Tai-Min/KV260-Human-Detector/hardware/hardware.runs/hardware_proc_sys_reset_1_0_synth_1/.vivado.begin.rst

<?xml version="1.0"?>
<ProcessHandle Version="1" Minor="0">
    <Process Command="vivado" Owner="mateusz" Host="PC" Pid="10663" HostCore="12" HostMemory="16323700">
    </Process>
</ProcessHandle>
