Tai-Min/KV260-Human-Detector/hardware/hardware.runs/impl_1/.init_design.begin.rst

<?xml version="1.0"?>
<ProcessHandle Version="1" Minor="0">
    <Process Command=".planAhead." Owner="mateusz" Host="" Pid="2269716">
    </Process>
</ProcessHandle>
