Tai-Min/KV260-Human-Detector/hardware/hardware.runs/hardware_temp2pwm_0_0_synth_1/.vivado.begin.rst

<?xml version="1.0"?>
<ProcessHandle Version="1" Minor="0">
    <Process Command="vivado" Owner="mateusz" Host="PC" Pid="37465" HostCore="12" HostMemory="16323700">
    </Process>
</ProcessHandle>
