Tai-Min/KV260-Human-Detector/linux/hardware/xilinx-k26-starterkit-2021.1/xilinx-k26-starterkit-2021.1.runs/impl_1/.vivado.begin.rst

<?xml version="1.0"?>
<ProcessHandle Version="1" Minor="0">
    <Process Command="vivado" Owner="xbrbbot" Host="xcosswbld06" Pid="35040" HostCore="56" HostMemory="528287204">
    </Process>
</ProcessHandle>
