Tai-Min/KV260-Human-Detector/stl/bottom_panel_stopper.stl

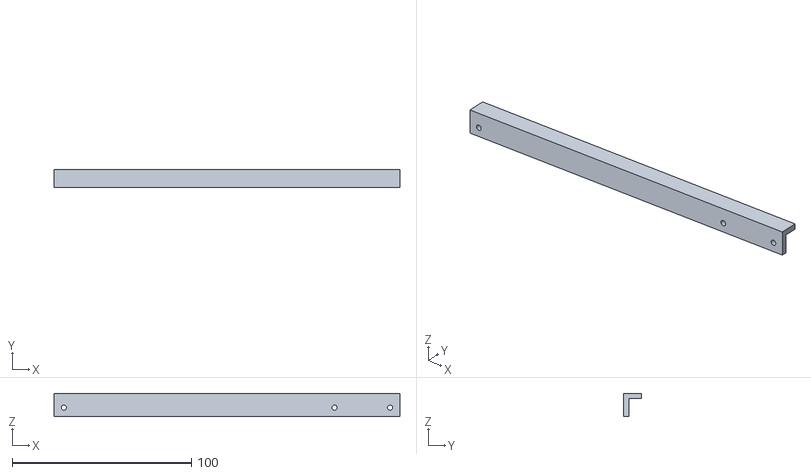
[picture p3: CAD file, 2022-03-03]
stl/bottom_panel_stopper.stl
193.0 x 10.0 x 13.0
