Tai-Min/KV260-Human-Detector/stl/top_panel.stl

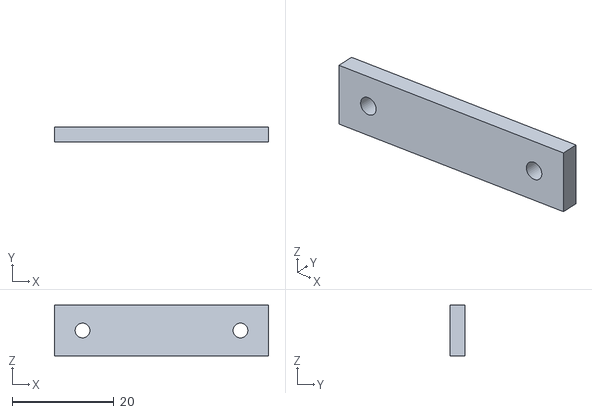
[picture p4: CAD file, 2022-03-03]
stl/top_panel.stl
42.0 x 3.00 x 10.0
