Tai-Min/KV260-Human-Detector/stl/motor_frame.stl

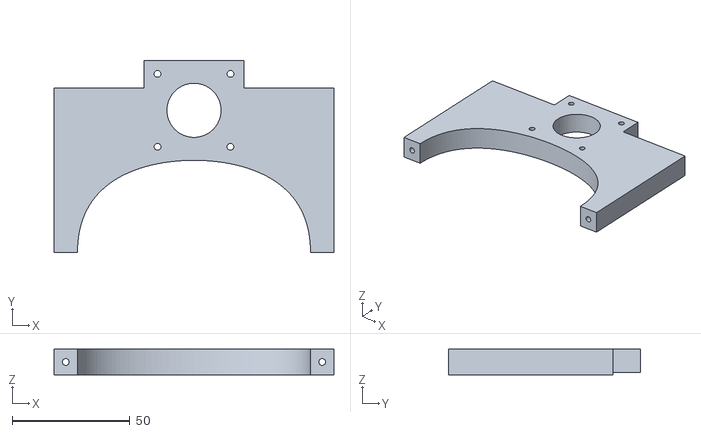
[picture p5: CAD file, 2022-03-03]
stl/motor_frame.stl
119.0 x 81.8 x 11.0
