Tai-Min/KV260-Human-Detector/stl/lidar_frame.stl

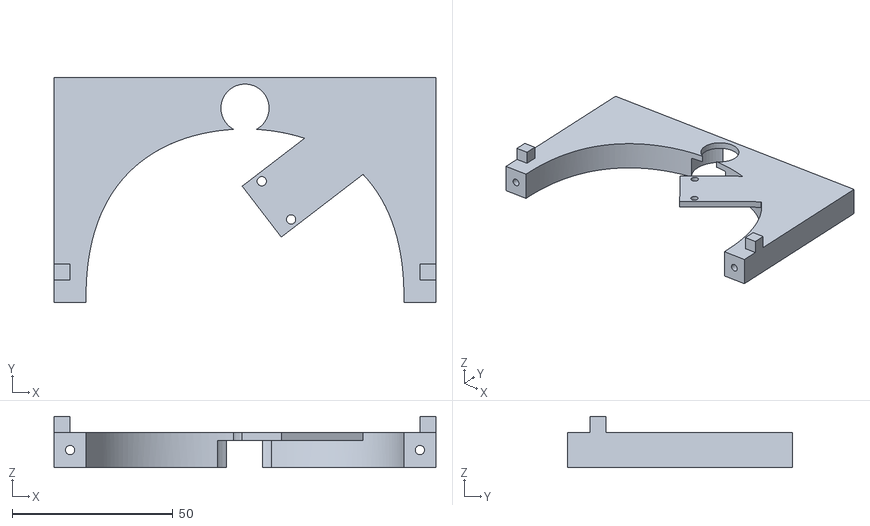
[picture p6: CAD file, 2022-03-03]
stl/lidar_frame.stl
119.0 x 70.0 x 16.0
