Tai-Min/KV260-Human-Detector/stl/bottom_panel.stl

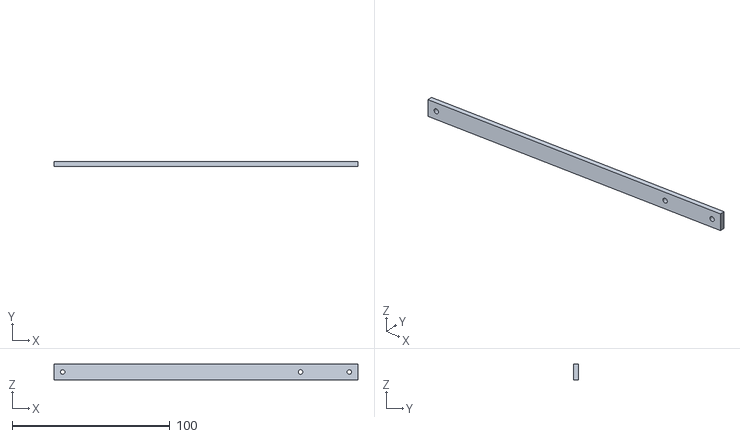
[picture p7: CAD file, 2022-03-03]
stl/bottom_panel.stl
193.0 x 3.00 x 10.0
