Tai-Min/KV260-Human-Detector/stl/bottom_panel_feets.stl

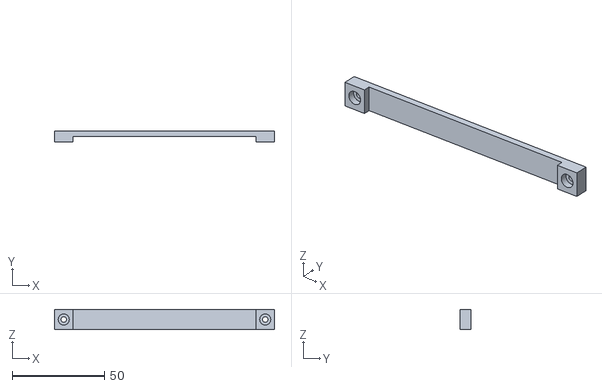
[picture p8: CAD file, 2022-03-03]
stl/bottom_panel_feets.stl
119.0 x 6.00 x 11.0
