Tai-Min/KV260-Human-Detector/stl/nema_connector.stl

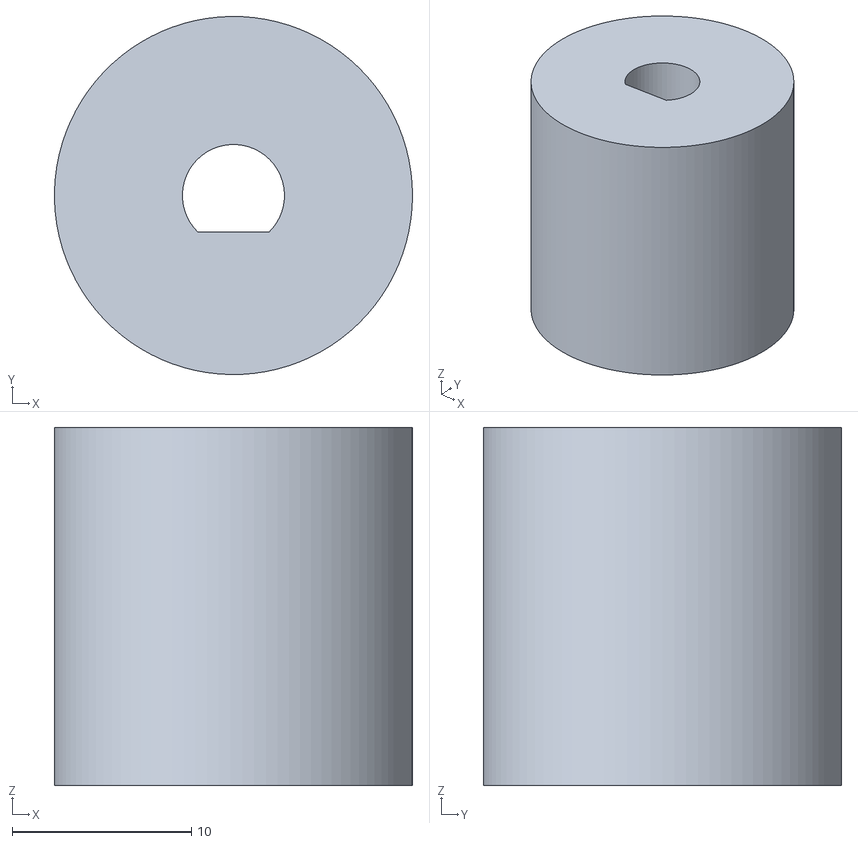
[picture p9: CAD file, 2022-03-03]
stl/nema_connector.stl
20.0 x 20.0 x 20.0
