Tai-Min/KV260-Human-Detector/stl/lidar_board_holder.stl

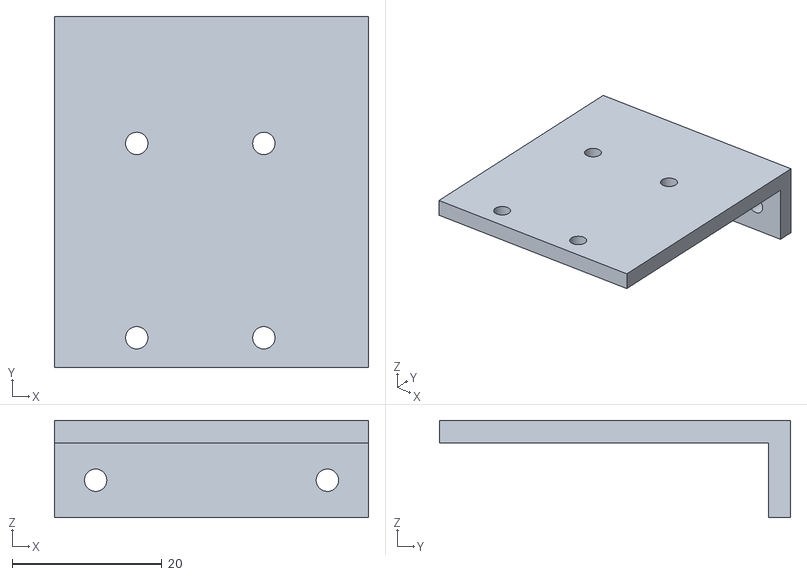
[picture p10: CAD file, 2022-03-03]
stl/lidar_board_holder.stl
42.0 x 47.0 x 13.0
