Tai-Min/KV260-Human-Detector/stl/cradle.stl

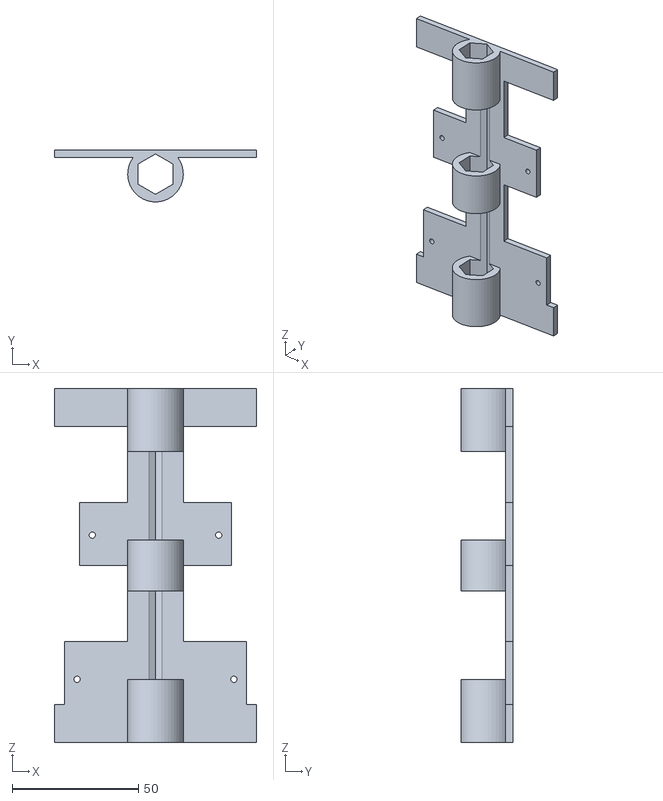
[picture p11: CAD file, 2022-03-03]
stl/cradle.stl
80.0 x 20.5 x 140.0
