Tai-Min/KV260-Human-Detector/linux/hardware/xilinx-k26-starterkit-2021.1/xilinx-k26-starterkit-2021.1.runs/impl_1/usage_statistics_webtalk.html

### Device Usage Page (usage_statistics_webtalk.html)

This HTML page displays the device usage statistics that will be sent to Xilinx.
To see the actual file transmitted to Xilinx, please click here.

software_version_and_target_device
beta | FALSE | build_version | 3247384
date_generated | Fri Jun 11 05:08:06 2021 | os_platform | LIN64
product_version | Vivado v2021.1 (64-bit) | project_id | 5b311babb7be460c8d784e81aaf17de7
project_iteration | 1 | random_id | fea0ae4543065926943c36c45e53d794
registration_id | 1_2_4_3 | route_design | TRUE
target_device | xck26 | target_family | zynquplus
target_package | sfvc784 | target_speed | -2LV
tool_flow | Vivado

user_environment
cpu_name | Intel(R) Xeon(R) CPU E5-2690 v4 @ 2.60GHz | cpu_speed | 1197.268 MHz
os_name | Ubuntu | os_release | Ubuntu 18.04.5 LTS
system_ram | 540.000 GB | total_processors | 2

vivado_usage

other_data

batchmode=1

project_data
base_connector_name_1=som240_1_connector | board=Kria KV260 Vision AI Starter Kit | constraintsetcount=1 | core_container=false
currentimplrun=impl_1 | currentsynthesisrun=synth_1 | default_library=xil_defaultlib | designmode=RTL
export_simulation_activehdl=0 | export_simulation_ies=0 | export_simulation_modelsim=0 | export_simulation_questa=0
export_simulation_riviera=0 | export_simulation_vcs=0 | export_simulation_xsim=0 | fmc_board_1=xilinx.com:som240:1.0
fmc_connector_name_1=som240_1_connector | implstrategy=Vivado Implementation Defaults | launch_simulation_activehdl=0 | launch_simulation_ies=0
launch_simulation_modelsim=0 | launch_simulation_questa=0 | launch_simulation_riviera=0 | launch_simulation_vcs=0
launch_simulation_xsim=0 | simulator_language=Mixed | srcsetcount=2 | synthesisstrategy=Vivado Synthesis Defaults
target_language=Verilog | target_simulator=XSim | totalimplruns=2 | totalsynthesisruns=2

unisim_transformation

post_unisim_transformation
bufg_ps=2 | gnd=3 | lut1=264 | ps8=1

vcc=2

pre_unisim_transformation
bufg_ps=2 | gnd=3 | lut1=264 | ps8=1

vcc=2

phys_opt_design_post_place

command_line_options
-aggressive_hold_fix=default::[not_specified] | -bram_register_opt=default::[not_specified] | -clock_opt=default::[not_specified] | -critical_cell_opt=default::[not_specified]
-critical_pin_opt=default::[not_specified] | -directive=default::[not_specified] | -dsp_register_opt=default::[not_specified] | -effort_level=default::[not_specified]
-fanout_opt=default::[not_specified] | -hold_fix=default::[not_specified] | -insert_negative_edge_ffs=default::[not_specified] | -multi_clock_opt=default::[not_specified]
-placement_opt=default::[not_specified] | -restruct_opt=default::[not_specified] | -retime=default::[not_specified] | -rewire=default::[not_specified]
-shift_register_opt=default::[not_specified] | -uram_register_opt=default::[not_specified] | -verbose=default::[not_specified] | -vhfn=default::[not_specified]

ip_statistics

IP_Integrator/1
bdsource=USER | core_container=NA | da_zynq_ultra_ps_e_cnt=1 | iptotal=1
maxhierdepth=0 | numblks=1 | numhdlrefblks=0 | numhierblks=0
numhlsblks=0 | numnonxlnxblks=0 | numpkgbdblks=0 | numreposblks=1
numsysgenblks=0 | synth_mode=OOC_per_IP | x_iplanguage=VERILOG | x_iplibrary=BlockDiagram
x_ipname=project_1 | x_ipvendor=xilinx.com | x_ipversion=1.00.a

zynq_ultra_ps_e_v3_3_5_zynq_ultra_ps_e/1
c_dp_use_audio=0 | c_dp_use_video=0 | c_emio_gpio_width=1 | c_en_emio_trace=0
c_en_fifo_enet0=0 | c_en_fifo_enet1=0 | c_en_fifo_enet2=0 | c_en_fifo_enet3=0
c_maxigp0_data_width=128 | c_maxigp1_data_width=128 | c_maxigp2_data_width=32 | c_num_f2p_0_intr_inputs=1
c_num_f2p_1_intr_inputs=1 | c_num_fabric_resets=1 | c_pl_clk0_buf=TRUE | c_pl_clk1_buf=TRUE
c_pl_clk2_buf=FALSE | c_pl_clk3_buf=FALSE | c_saxigp0_data_width=128 | c_saxigp1_data_width=128
c_saxigp2_data_width=128 | c_saxigp3_data_width=128 | c_saxigp4_data_width=128 | c_saxigp5_data_width=128
c_saxigp6_data_width=128 | c_sd0_internal_bus_width=8 | c_sd1_internal_bus_width=8 | c_trace_data_width=32
c_trace_pipeline_width=8 | c_use_debug_test=0 | c_use_diff_rw_clk_gp0=0 | c_use_diff_rw_clk_gp1=0
c_use_diff_rw_clk_gp2=0 | c_use_diff_rw_clk_gp3=0 | c_use_diff_rw_clk_gp4=0 | c_use_diff_rw_clk_gp5=0
c_use_diff_rw_clk_gp6=0 | core_container=NA | iptotal=1 | x_ipcorerevision=5
x_iplanguage=VERILOG | x_iplibrary=ip | x_ipname=zynq_ultra_ps_e | x_ipproduct=Vivado 2021.1
x_ipsimlanguage=MIXED | x_ipvendor=xilinx.com | x_ipversion=3.3

zynq_ultra_ps_e_v3_3_user_configuration/1
x_ipversion=3.3 | core_container=NA | iptotal=1 | psu__acpu0__power__on=1
psu__acpu1__power__on=1 | psu__acpu2__power__on=1 | psu__acpu3__power__on=1 | psu__actual__ip=1
psu__can0__grp_clk__enable=0 | psu__can0__peripheral__enable=0 | psu__can0_loop_can1__enable=0 | psu__can1__grp_clk__enable=0
psu__can1__peripheral__enable=0 | psu__crf_apb__acpu_ctrl__act_freqmhz=1333.333008 | psu__crf_apb__acpu_ctrl__divisor0=1 | psu__crf_apb__acpu_ctrl__freqmhz=1333.333
psu__crf_apb__acpu_ctrl__srcsel=APLL | psu__crf_apb__afi0_ref__enable=0 | psu__crf_apb__afi0_ref_ctrl__act_freqmhz=667 | psu__crf_apb__afi0_ref_ctrl__divisor0=2
psu__crf_apb__afi0_ref_ctrl__freqmhz=667 | psu__crf_apb__afi0_ref_ctrl__srcsel=DPLL | psu__crf_apb__afi1_ref__enable=0 | psu__crf_apb__afi1_ref_ctrl__act_freqmhz=667
psu__crf_apb__afi1_ref_ctrl__divisor0=2 | psu__crf_apb__afi1_ref_ctrl__freqmhz=667 | psu__crf_apb__afi1_ref_ctrl__srcsel=DPLL | psu__crf_apb__afi2_ref__enable=0
psu__crf_apb__afi2_ref_ctrl__act_freqmhz=667 | psu__crf_apb__afi2_ref_ctrl__divisor0=2 | psu__crf_apb__afi2_ref_ctrl__freqmhz=667 | psu__crf_apb__afi2_ref_ctrl__srcsel=DPLL
psu__crf_apb__afi3_ref__enable=0 | psu__crf_apb__afi3_ref_ctrl__act_freqmhz=667 | psu__crf_apb__afi3_ref_ctrl__divisor0=2 | psu__crf_apb__afi3_ref_ctrl__freqmhz=667
psu__crf_apb__afi3_ref_ctrl__srcsel=DPLL | psu__crf_apb__afi4_ref__enable=0 | psu__crf_apb__afi4_ref_ctrl__act_freqmhz=667 | psu__crf_apb__afi4_ref_ctrl__divisor0=2
psu__crf_apb__afi4_ref_ctrl__freqmhz=667 | psu__crf_apb__afi4_ref_ctrl__srcsel=DPLL | psu__crf_apb__afi5_ref__enable=0 | psu__crf_apb__afi5_ref_ctrl__act_freqmhz=667
psu__crf_apb__afi5_ref_ctrl__divisor0=2 | psu__crf_apb__afi5_ref_ctrl__freqmhz=667 | psu__crf_apb__afi5_ref_ctrl__srcsel=DPLL | psu__crf_apb__apll_ctrl__div2=1
psu__crf_apb__apll_ctrl__fbdiv=80 | psu__crf_apb__apll_ctrl__srcsel=PSS_REF_CLK | psu__crf_apb__apll_frac_cfg__enabled=1 | psu__crf_apb__apll_to_lpd_ctrl__divisor0=3
psu__crf_apb__apm_ctrl__act_freqmhz=1 | psu__crf_apb__apm_ctrl__divisor0=1 | psu__crf_apb__apm_ctrl__freqmhz=1 | psu__crf_apb__dbg_fpd_ctrl__act_freqmhz=249.997498
psu__crf_apb__dbg_fpd_ctrl__divisor0=2 | psu__crf_apb__dbg_fpd_ctrl__freqmhz=250 | psu__crf_apb__dbg_fpd_ctrl__srcsel=IOPLL | psu__crf_apb__dbg_trace_ctrl__act_freqmhz=250
psu__crf_apb__dbg_trace_ctrl__divisor0=5 | psu__crf_apb__dbg_trace_ctrl__freqmhz=250 | psu__crf_apb__dbg_trace_ctrl__srcsel=IOPLL | psu__crf_apb__dbg_tstmp_ctrl__act_freqmhz=249.997498
psu__crf_apb__dbg_tstmp_ctrl__divisor0=2 | psu__crf_apb__dbg_tstmp_ctrl__freqmhz=250 | psu__crf_apb__dbg_tstmp_ctrl__srcsel=IOPLL | psu__crf_apb__ddr_ctrl__act_freqmhz=533.328003
psu__crf_apb__ddr_ctrl__divisor0=2 | psu__crf_apb__ddr_ctrl__freqmhz=1200 | psu__crf_apb__ddr_ctrl__srcsel=DPLL | psu__crf_apb__dp_audio_ref_ctrl__act_freqmhz=24.242182
psu__crf_apb__dp_audio_ref_ctrl__divisor0=22 | psu__crf_apb__dp_audio_ref_ctrl__divisor1=1 | psu__crf_apb__dp_audio_ref_ctrl__freqmhz=25 | psu__crf_apb__dp_audio_ref_ctrl__srcsel=RPLL
psu__crf_apb__dp_stc_ref_ctrl__act_freqmhz=26.666401 | psu__crf_apb__dp_stc_ref_ctrl__divisor0=20 | psu__crf_apb__dp_stc_ref_ctrl__divisor1=1 | psu__crf_apb__dp_stc_ref_ctrl__freqmhz=27
psu__crf_apb__dp_stc_ref_ctrl__srcsel=RPLL | psu__crf_apb__dp_video_ref_ctrl__act_freqmhz=299.997009 | psu__crf_apb__dp_video_ref_ctrl__divisor0=5 | psu__crf_apb__dp_video_ref_ctrl__divisor1=1
psu__crf_apb__dp_video_ref_ctrl__freqmhz=300 | psu__crf_apb__dp_video_ref_ctrl__srcsel=VPLL | psu__crf_apb__dpdma_ref_ctrl__act_freqmhz=444.444336 | psu__crf_apb__dpdma_ref_ctrl__divisor0=3
psu__crf_apb__dpdma_ref_ctrl__freqmhz=600 | psu__crf_apb__dpdma_ref_ctrl__srcsel=APLL | psu__crf_apb__dpll_ctrl__div2=1 | psu__crf_apb__dpll_ctrl__fbdiv=64
psu__crf_apb__dpll_ctrl__srcsel=PSS_REF_CLK | psu__crf_apb__dpll_frac_cfg__enabled=0 | psu__crf_apb__dpll_to_lpd_ctrl__divisor0=2 | psu__crf_apb__gdma_ref_ctrl__act_freqmhz=533.328003
psu__crf_apb__gdma_ref_ctrl__divisor0=2 | psu__crf_apb__gdma_ref_ctrl__freqmhz=600 | psu__crf_apb__gdma_ref_ctrl__srcsel=DPLL | psu__crf_apb__gpu_ref_ctrl__act_freqmhz=499.994995
psu__crf_apb__gpu_ref_ctrl__divisor0=1 | psu__crf_apb__gpu_ref_ctrl__freqmhz=600 | psu__crf_apb__gpu_ref_ctrl__srcsel=IOPLL | psu__crf_apb__pcie_ref_ctrl__act_freqmhz=250
psu__crf_apb__pcie_ref_ctrl__divisor0=6 | psu__crf_apb__pcie_ref_ctrl__freqmhz=250 | psu__crf_apb__pcie_ref_ctrl__srcsel=IOPLL | psu__crf_apb__sata_ref_ctrl__act_freqmhz=250
psu__crf_apb__sata_ref_ctrl__divisor0=5 | psu__crf_apb__sata_ref_ctrl__freqmhz=250 | psu__crf_apb__sata_ref_ctrl__srcsel=IOPLL | psu__crf_apb__topsw_lsbus_ctrl__act_freqmhz=99.999001
psu__crf_apb__topsw_lsbus_ctrl__divisor0=5 | psu__crf_apb__topsw_lsbus_ctrl__freqmhz=100 | psu__crf_apb__topsw_lsbus_ctrl__srcsel=IOPLL | psu__crf_apb__topsw_main_ctrl__act_freqmhz=533.328003
psu__crf_apb__topsw_main_ctrl__divisor0=2 | psu__crf_apb__topsw_main_ctrl__freqmhz=533.33 | psu__crf_apb__topsw_main_ctrl__srcsel=DPLL | psu__crf_apb__vpll_ctrl__div2=1
psu__crf_apb__vpll_ctrl__fbdiv=90 | psu__crf_apb__vpll_ctrl__srcsel=PSS_REF_CLK | psu__crf_apb__vpll_frac_cfg__enabled=0 | psu__crf_apb__vpll_to_lpd_ctrl__divisor0=3
psu__crl_apb__adma_ref_ctrl__act_freqmhz=499.994995 | psu__crl_apb__adma_ref_ctrl__divisor0=3 | psu__crl_apb__adma_ref_ctrl__freqmhz=500 | psu__crl_apb__adma_ref_ctrl__srcsel=IOPLL
psu__crl_apb__afi6__enable=0 | psu__crl_apb__afi6_ref_ctrl__act_freqmhz=500 | psu__crl_apb__afi6_ref_ctrl__divisor0=3 | psu__crl_apb__afi6_ref_ctrl__freqmhz=500
psu__crl_apb__afi6_ref_ctrl__srcsel=IOPLL | psu__crl_apb__ams_ref_ctrl__act_freqmhz=49.999500 | psu__crl_apb__ams_ref_ctrl__divisor0=30 | psu__crl_apb__ams_ref_ctrl__divisor1=1
psu__crl_apb__ams_ref_ctrl__freqmhz=50 | psu__crl_apb__ams_ref_ctrl__srcsel=IOPLL | psu__crl_apb__can0_ref_ctrl__act_freqmhz=100 | psu__crl_apb__can0_ref_ctrl__divisor0=15
psu__crl_apb__can0_ref_ctrl__divisor1=1 | psu__crl_apb__can0_ref_ctrl__freqmhz=100 | psu__crl_apb__can0_ref_ctrl__srcsel=IOPLL | psu__crl_apb__can1_ref_ctrl__act_freqmhz=100
psu__crl_apb__can1_ref_ctrl__divisor0=15 | psu__crl_apb__can1_ref_ctrl__divisor1=1 | psu__crl_apb__can1_ref_ctrl__freqmhz=100 | psu__crl_apb__can1_ref_ctrl__srcsel=IOPLL
psu__crl_apb__cpu_r5_ctrl__act_freqmhz=533.328003 | psu__crl_apb__cpu_r5_ctrl__divisor0=2 | psu__crl_apb__cpu_r5_ctrl__freqmhz=533.333 | psu__crl_apb__cpu_r5_ctrl__srcsel=RPLL
psu__crl_apb__csu_pll_ctrl__act_freqmhz=180 | psu__crl_apb__csu_pll_ctrl__divisor0=3 | psu__crl_apb__csu_pll_ctrl__freqmhz=180 | psu__crl_apb__csu_pll_ctrl__srcsel=SysOsc
psu__crl_apb__dbg_lpd_ctrl__act_freqmhz=249.997498 | psu__crl_apb__dbg_lpd_ctrl__divisor0=6 | psu__crl_apb__dbg_lpd_ctrl__freqmhz=250 | psu__crl_apb__dbg_lpd_ctrl__srcsel=IOPLL
psu__crl_apb__debug_r5_atclk_ctrl__act_freqmhz=1000 | psu__crl_apb__debug_r5_atclk_ctrl__divisor0=6 | psu__crl_apb__debug_r5_atclk_ctrl__freqmhz=1000 | psu__crl_apb__debug_r5_atclk_ctrl__srcsel=RPLL
psu__crl_apb__dll_ref_ctrl__act_freqmhz=1499.984985 | psu__crl_apb__dll_ref_ctrl__freqmhz=1500 | psu__crl_apb__dll_ref_ctrl__srcsel=IOPLL | psu__crl_apb__gem0_ref_ctrl__act_freqmhz=125
psu__crl_apb__gem0_ref_ctrl__divisor0=12 | psu__crl_apb__gem0_ref_ctrl__divisor1=1 | psu__crl_apb__gem0_ref_ctrl__freqmhz=125 | psu__crl_apb__gem0_ref_ctrl__srcsel=IOPLL
psu__crl_apb__gem1_ref_ctrl__act_freqmhz=125 | psu__crl_apb__gem1_ref_ctrl__divisor0=12 | psu__crl_apb__gem1_ref_ctrl__divisor1=1 | psu__crl_apb__gem1_ref_ctrl__freqmhz=125
psu__crl_apb__gem1_ref_ctrl__srcsel=IOPLL | psu__crl_apb__gem2_ref_ctrl__act_freqmhz=125 | psu__crl_apb__gem2_ref_ctrl__divisor0=12 | psu__crl_apb__gem2_ref_ctrl__divisor1=1
psu__crl_apb__gem2_ref_ctrl__freqmhz=125 | psu__crl_apb__gem2_ref_ctrl__srcsel=IOPLL | psu__crl_apb__gem3_ref_ctrl__act_freqmhz=124.998749 | psu__crl_apb__gem3_ref_ctrl__divisor0=12
psu__crl_apb__gem3_ref_ctrl__divisor1=1 | psu__crl_apb__gem3_ref_ctrl__freqmhz=125 | psu__crl_apb__gem3_ref_ctrl__srcsel=IOPLL | psu__crl_apb__gem_tsu_ref_ctrl__act_freqmhz=249.997498
psu__crl_apb__gem_tsu_ref_ctrl__divisor0=6 | psu__crl_apb__gem_tsu_ref_ctrl__divisor1=1 | psu__crl_apb__gem_tsu_ref_ctrl__freqmhz=250 | psu__crl_apb__gem_tsu_ref_ctrl__srcsel=IOPLL
psu__crl_apb__i2c0_ref_ctrl__act_freqmhz=100 | psu__crl_apb__i2c0_ref_ctrl__divisor0=15 | psu__crl_apb__i2c0_ref_ctrl__divisor1=1 | psu__crl_apb__i2c0_ref_ctrl__freqmhz=100
psu__crl_apb__i2c0_ref_ctrl__srcsel=IOPLL | psu__crl_apb__i2c1_ref_ctrl__act_freqmhz=99.999001 | psu__crl_apb__i2c1_ref_ctrl__divisor0=15 | psu__crl_apb__i2c1_ref_ctrl__divisor1=1
psu__crl_apb__i2c1_ref_ctrl__freqmhz=100 | psu__crl_apb__i2c1_ref_ctrl__srcsel=IOPLL | psu__crl_apb__iopll_ctrl__div2=1 | psu__crl_apb__iopll_ctrl__fbdiv=90
psu__crl_apb__iopll_ctrl__srcsel=PSS_REF_CLK | psu__crl_apb__iopll_frac_cfg__enabled=0 | psu__crl_apb__iopll_to_fpd_ctrl__divisor0=3 | psu__crl_apb__iou_switch_ctrl__act_freqmhz=249.997498
psu__crl_apb__iou_switch_ctrl__divisor0=6 | psu__crl_apb__iou_switch_ctrl__freqmhz=250 | psu__crl_apb__iou_switch_ctrl__srcsel=IOPLL | psu__crl_apb__lpd_lsbus_ctrl__act_freqmhz=99.999001
psu__crl_apb__lpd_lsbus_ctrl__divisor0=15 | psu__crl_apb__lpd_lsbus_ctrl__freqmhz=100 | psu__crl_apb__lpd_lsbus_ctrl__srcsel=IOPLL | psu__crl_apb__lpd_switch_ctrl__act_freqmhz=499.994995
psu__crl_apb__lpd_switch_ctrl__divisor0=3 | psu__crl_apb__lpd_switch_ctrl__freqmhz=500 | psu__crl_apb__lpd_switch_ctrl__srcsel=IOPLL | psu__crl_apb__nand_ref_ctrl__act_freqmhz=100
psu__crl_apb__nand_ref_ctrl__divisor0=15 | psu__crl_apb__nand_ref_ctrl__divisor1=1 | psu__crl_apb__nand_ref_ctrl__freqmhz=100 | psu__crl_apb__nand_ref_ctrl__srcsel=IOPLL
psu__crl_apb__ocm_main_ctrl__act_freqmhz=500 | psu__crl_apb__ocm_main_ctrl__divisor0=3 | psu__crl_apb__ocm_main_ctrl__freqmhz=500 | psu__crl_apb__ocm_main_ctrl__srcsel=IOPLL
psu__crl_apb__pcap_ctrl__act_freqmhz=187.498123 | psu__crl_apb__pcap_ctrl__divisor0=8 | psu__crl_apb__pcap_ctrl__freqmhz=200 | psu__crl_apb__pcap_ctrl__srcsel=IOPLL
psu__crl_apb__pl0_ref_ctrl__act_freqmhz=99.999001 | psu__crl_apb__pl0_ref_ctrl__divisor0=15 | psu__crl_apb__pl0_ref_ctrl__divisor1=1 | psu__crl_apb__pl0_ref_ctrl__freqmhz=100
psu__crl_apb__pl0_ref_ctrl__srcsel=IOPLL | psu__crl_apb__pl1_ref_ctrl__act_freqmhz=99.999001 | psu__crl_apb__pl1_ref_ctrl__divisor0=15 | psu__crl_apb__pl1_ref_ctrl__divisor1=1
psu__crl_apb__pl1_ref_ctrl__freqmhz=100 | psu__crl_apb__pl1_ref_ctrl__srcsel=IOPLL | psu__crl_apb__pl2_ref_ctrl__act_freqmhz=100 | psu__crl_apb__pl2_ref_ctrl__divisor0=4
psu__crl_apb__pl2_ref_ctrl__divisor1=1 | psu__crl_apb__pl2_ref_ctrl__freqmhz=100 | psu__crl_apb__pl2_ref_ctrl__srcsel=RPLL | psu__crl_apb__pl3_ref_ctrl__act_freqmhz=100
psu__crl_apb__pl3_ref_ctrl__divisor0=4 | psu__crl_apb__pl3_ref_ctrl__divisor1=1 | psu__crl_apb__pl3_ref_ctrl__freqmhz=100 | psu__crl_apb__pl3_ref_ctrl__srcsel=RPLL
psu__crl_apb__qspi_ref_ctrl__act_freqmhz=124.998749 | psu__crl_apb__qspi_ref_ctrl__divisor0=12 | psu__crl_apb__qspi_ref_ctrl__divisor1=1 | psu__crl_apb__qspi_ref_ctrl__freqmhz=125
psu__crl_apb__qspi_ref_ctrl__srcsel=IOPLL | psu__crl_apb__rpll_ctrl__div2=1 | psu__crl_apb__rpll_ctrl__fbdiv=64 | psu__crl_apb__rpll_ctrl__srcsel=PSS_REF_CLK
psu__crl_apb__rpll_frac_cfg__enabled=0 | psu__crl_apb__rpll_to_fpd_ctrl__divisor0=2 | psu__crl_apb__sdio0_ref_ctrl__act_freqmhz=200 | psu__crl_apb__sdio0_ref_ctrl__divisor0=7
psu__crl_apb__sdio0_ref_ctrl__divisor1=1 | psu__crl_apb__sdio0_ref_ctrl__freqmhz=200 | psu__crl_apb__sdio0_ref_ctrl__srcsel=RPLL | psu__crl_apb__sdio1_ref_ctrl__act_freqmhz=187.498123
psu__crl_apb__sdio1_ref_ctrl__divisor0=8 | psu__crl_apb__sdio1_ref_ctrl__divisor1=1 | psu__crl_apb__sdio1_ref_ctrl__freqmhz=200 | psu__crl_apb__sdio1_ref_ctrl__srcsel=IOPLL
psu__crl_apb__spi0_ref_ctrl__act_freqmhz=214 | psu__crl_apb__spi0_ref_ctrl__divisor0=7 | psu__crl_apb__spi0_ref_ctrl__divisor1=1 | psu__crl_apb__spi0_ref_ctrl__freqmhz=200
psu__crl_apb__spi0_ref_ctrl__srcsel=RPLL | psu__crl_apb__spi1_ref_ctrl__act_freqmhz=187.498123 | psu__crl_apb__spi1_ref_ctrl__divisor0=8 | psu__crl_apb__spi1_ref_ctrl__divisor1=1
psu__crl_apb__spi1_ref_ctrl__freqmhz=200 | psu__crl_apb__spi1_ref_ctrl__srcsel=IOPLL | psu__crl_apb__timestamp_ref_ctrl__act_freqmhz=99.999001 | psu__crl_apb__timestamp_ref_ctrl__divisor0=15
psu__crl_apb__timestamp_ref_ctrl__freqmhz=100 | psu__crl_apb__timestamp_ref_ctrl__srcsel=IOPLL | psu__crl_apb__uart0_ref_ctrl__act_freqmhz=100 | psu__crl_apb__uart0_ref_ctrl__divisor0=15
psu__crl_apb__uart0_ref_ctrl__divisor1=1 | psu__crl_apb__uart0_ref_ctrl__freqmhz=100 | psu__crl_apb__uart0_ref_ctrl__srcsel=IOPLL | psu__crl_apb__uart1_ref_ctrl__act_freqmhz=99.999001
psu__crl_apb__uart1_ref_ctrl__divisor0=15 | psu__crl_apb__uart1_ref_ctrl__divisor1=1 | psu__crl_apb__uart1_ref_ctrl__freqmhz=100 | psu__crl_apb__uart1_ref_ctrl__srcsel=IOPLL
psu__crl_apb__usb0_bus_ref_ctrl__act_freqmhz=249.997498 | psu__crl_apb__usb0_bus_ref_ctrl__divisor0=6 | psu__crl_apb__usb0_bus_ref_ctrl__divisor1=1 | psu__crl_apb__usb0_bus_ref_ctrl__freqmhz=250
psu__crl_apb__usb0_bus_ref_ctrl__srcsel=IOPLL | psu__crl_apb__usb1_bus_ref_ctrl__act_freqmhz=250 | psu__crl_apb__usb1_bus_ref_ctrl__divisor0=6 | psu__crl_apb__usb1_bus_ref_ctrl__divisor1=1
psu__crl_apb__usb1_bus_ref_ctrl__freqmhz=250 | psu__crl_apb__usb1_bus_ref_ctrl__srcsel=IOPLL | psu__crl_apb__usb3__enable=1 | psu__crl_apb__usb3_dual_ref_ctrl__act_freqmhz=19.999800
psu__crl_apb__usb3_dual_ref_ctrl__divisor0=25 | psu__crl_apb__usb3_dual_ref_ctrl__divisor1=3 | psu__crl_apb__usb3_dual_ref_ctrl__freqmhz=20 | psu__crl_apb__usb3_dual_ref_ctrl__srcsel=IOPLL
psu__csu__csu_tamper_0__enable=0 | psu__csu__csu_tamper_0__erase_bbram=0 | psu__csu__csu_tamper_10__enable=0 | psu__csu__csu_tamper_10__erase_bbram=0
psu__csu__csu_tamper_11__enable=0 | psu__csu__csu_tamper_11__erase_bbram=0 | psu__csu__csu_tamper_12__enable=0 | psu__csu__csu_tamper_12__erase_bbram=0
psu__csu__csu_tamper_1__enable=0 | psu__csu__csu_tamper_1__erase_bbram=0 | psu__csu__csu_tamper_2__enable=0 | psu__csu__csu_tamper_2__erase_bbram=0
psu__csu__csu_tamper_3__enable=0 | psu__csu__csu_tamper_3__erase_bbram=0 | psu__csu__csu_tamper_4__enable=0 | psu__csu__csu_tamper_4__erase_bbram=0
psu__csu__csu_tamper_5__enable=0 | psu__csu__csu_tamper_5__erase_bbram=0 | psu__csu__csu_tamper_6__enable=0 | psu__csu__csu_tamper_6__erase_bbram=0
psu__csu__csu_tamper_7__enable=0 | psu__csu__csu_tamper_7__erase_bbram=0 | psu__csu__csu_tamper_8__enable=0 | psu__csu__csu_tamper_8__erase_bbram=0
psu__csu__csu_tamper_9__enable=0 | psu__csu__csu_tamper_9__erase_bbram=0 | psu__csu__peripheral__enable=0 | psu__ddr_qos_enable=0
psu__ddrc__al=0 | psu__ddrc__bank_addr_count=2 | psu__ddrc__bus_width=64 Bit | psu__ddrc__cl=16
psu__ddrc__clock_stop_en=0 | psu__ddrc__col_addr_count=10 | psu__ddrc__cwl=14 | psu__ddrc__device_capacity=8192 MBits
psu__ddrc__dram_width=16 Bits | psu__ddrc__ecc=Disabled | psu__ddrc__enable=1 | psu__ddrc__freq_mhz=1
psu__ddrc__memory_type=DDR 4 | psu__ddrc__row_addr_count=16 | psu__ddrc__speed_bin=DDR4_2400R | psu__ddrc__t_faw=30.0
psu__ddrc__t_ras_min=33 | psu__ddrc__t_rc=47.06 | psu__ddrc__t_rcd=16 | psu__ddrc__t_rp=16
psu__ddrc__train_data_eye=1 | psu__ddrc__train_read_gate=1 | psu__ddrc__train_write_level=1 | psu__displayport__peripheral__enable=1
psu__dpaux__peripheral__enable=1 | psu__dpaux__peripheral__io=MIO 27 .. 30 | psu__enet0__grp_mdio__enable=0 | psu__enet0__peripheral__enable=0
psu__enet1__grp_mdio__enable=0 | psu__enet1__peripheral__enable=0 | psu__enet2__grp_mdio__enable=0 | psu__enet2__peripheral__enable=0
psu__enet3__grp_mdio__enable=1 | psu__enet3__grp_mdio__io=MIO 76 .. 77 | psu__enet3__peripheral__enable=1 | psu__enet3__peripheral__io=MIO 64 .. 75
psu__ep__ip=0 | psu__fp__power__on=1 | psu__fpd_slcr__wdt_clk_sel__select=APB | psu__fpga_pl0_enable=1
psu__fpga_pl1_enable=1 | psu__fpga_pl2_enable=0 | psu__fpga_pl3_enable=0 | psu__gem__tsu__enable=0
psu__gen_ipi_0__master=APU | psu__gen_ipi_10__master=NONE | psu__gen_ipi_1__master=RPU0 | psu__gen_ipi_2__master=RPU1
psu__gen_ipi_3__master=PMU | psu__gen_ipi_4__master=PMU | psu__gen_ipi_5__master=PMU | psu__gen_ipi_6__master=PMU
psu__gen_ipi_7__master=NONE | psu__gen_ipi_8__master=NONE | psu__gen_ipi_9__master=NONE | psu__gpio0_mio__io=MIO 0 .. 25
psu__gpio0_mio__peripheral__enable=1 | psu__gpio1_mio__io=MIO 26 .. 51 | psu__gpio1_mio__peripheral__enable=1 | psu__gpio2_mio__peripheral__enable=0
psu__gpio_emio__peripheral__enable=0 | psu__gpu_pp0__power__on=1 | psu__gpu_pp1__power__on=1 | psu__i2c0__grp_int__enable=0
psu__i2c0__peripheral__enable=0 | psu__i2c0_loop_i2c1__enable=0 | psu__i2c1__grp_int__enable=0 | psu__i2c1__peripheral__enable=1
psu__i2c1__peripheral__io=MIO 24 .. 25 | psu__iou_slcr__iou_ttc_apb_clk__ttc0_sel=APB | psu__iou_slcr__iou_ttc_apb_clk__ttc1_sel=APB | psu__iou_slcr__iou_ttc_apb_clk__ttc2_sel=APB
psu__iou_slcr__iou_ttc_apb_clk__ttc3_sel=APB | psu__iou_slcr__wdt_clk_sel__select=APB | psu__l2_bank0__power__on=1 | psu__nand__chip_enable__enable=0
psu__nand__data_strobe__enable=0 | psu__nand__peripheral__enable=0 | psu__nand__ready_busy__enable=0 | psu__ocm_bank0__power__on=1
psu__ocm_bank1__power__on=1 | psu__ocm_bank2__power__on=1 | psu__ocm_bank3__power__on=1 | psu__override__basic_clock=0
psu__pcie__peripheral__enable=0 | psu__pjtag__peripheral__enable=0 | psu__pl__power__on=1 | psu__pmu__emio_gpi__enable=0
psu__pmu__emio_gpo__enable=0 | psu__pmu__gpi0__enable=1 | psu__pmu__gpi0__io=MIO 26 | psu__pmu__gpi1__enable=0
psu__pmu__gpi2__enable=0 | psu__pmu__gpi3__enable=0 | psu__pmu__gpi4__enable=0 | psu__pmu__gpi5__enable=1
psu__pmu__gpi5__io=MIO 31 | psu__pmu__gpo0__enable=1 | psu__pmu__gpo0__io=MIO 32 | psu__pmu__gpo1__enable=1
psu__pmu__gpo1__io=MIO 33 | psu__pmu__gpo2__enable=1 | psu__pmu__gpo2__io=MIO 34 | psu__pmu__gpo3__enable=1
psu__pmu__gpo3__io=MIO 35 | psu__pmu__gpo4__enable=0 | psu__pmu__gpo5__enable=0 | psu__pmu__peripheral__enable=1

psu__protection__ddr_segments=NONE

psu__protection__debug=0

psu__protection__fpd_segments=SA:0xFD1A0000; SIZE:1280; UNIT:KB; RegionTZ:Secure; WrAllowed:Read/Write; subsystemId:PMU Firmware| SA:0xFD000000; SIZE:64; UNIT:KB; RegionTZ:Secure; WrAllowed:Read/Write; subsystemId:PMU Firmware| SA:0xFD010000; SIZE:64; UNIT:KB; RegionTZ:Secure; WrAllowed:Read/Write; subsystemId:PMU Firmware| SA:0xFD020000; SIZE:64; UNIT:KB; RegionTZ:Secure; WrAllowed:Read/Write; subsystemId:PMU Firmware| SA:0xFD030000; SIZE:64; UNIT:KB; RegionTZ:Secure; WrAllowed:Read/Write; subsystemId:PMU Firmware| SA:0xFD040000; SIZE:64; UNIT:KB; RegionTZ:Secure; WrAllowed:Read/Write; subsystemId:PMU Firmware| SA:0xFD050000; SIZE:64; UNIT:KB; RegionTZ:Secure; WrAllowed:Read/Write; subsystemId:PMU Firmware| SA:0xFD610000; SIZE:512; UNIT:KB; RegionTZ:Secure; WrAllowed:Read/Write; subsystemId:PMU Firmware| SA:0xFD5D0000; SIZE:64; UNIT:KB; RegionTZ:Secure; WrAllowed:Read/Write; subsystemId:PMU Firmware|SA:0xFD1A0000 ; SIZE:1280; UNIT:KB; RegionTZ:Secure ; WrAllowed:Read/Write; subsystemId:Secure Subsystem

psu__protection__lpd_segments=SA:0xFF980000; SIZE:64; UNIT:KB; RegionTZ:Secure; WrAllowed:Read/Write; subsystemId:PMU Firmware| SA:0xFF5E0000; SIZE:2560; UNIT:KB; RegionTZ:Secure; WrAllowed:Read/Write; subsystemId:PMU Firmware| SA:0xFFCC0000; SIZE:64; UNIT:KB; RegionTZ:Secure; WrAllowed:Read/Write; subsystemId:PMU Firmware| SA:0xFF180000; SIZE:768; UNIT:KB; RegionTZ:Secure; WrAllowed:Read/Write; subsystemId:PMU Firmware| SA:0xFF410000; SIZE:640; UNIT:KB; RegionTZ:Secure; WrAllowed:Read/Write; subsystemId:PMU Firmware| SA:0xFFA70000; SIZE:64; UNIT:KB; RegionTZ:Secure; WrAllowed:Read/Write; subsystemId:PMU Firmware| SA:0xFF9A0000; SIZE:64; UNIT:KB; RegionTZ:Secure; WrAllowed:Read/Write; subsystemId:PMU Firmware|SA:0xFF5E0000 ; SIZE:2560; UNIT:KB; RegionTZ:Secure ; WrAllowed:Read/Write; subsystemId:Secure Subsystem|SA:0xFFCC0000 ; SIZE:64; UNIT:KB; RegionTZ:Secure ; WrAllowed:Read/Write; subsystemId:Secure Subsystem|SA:0xFF180000 ; SIZE:768; UNIT:KB; RegionTZ:Secure ; WrAllowed:Read/Write; subsystemId:Secure Subsystem|SA:0xFF9A0000 ; SIZE:64; UNIT:KB; RegionTZ:Secure ; WrAllowed:Read/Write; subsystemId:Secure Subsystem
psu__protection__ocm_segments=NONE | psu__protection__presubsystems=NONE | psu__protection__subsystems=PMU Firmware:PMU|Secure Subsystem: | psu__qspi__grp_fbclk__enable=0
psu__qspi__peripheral__data_mode=x4 | psu__qspi__peripheral__enable=1 | psu__qspi__peripheral__io=MIO 0 .. 5 | psu__qspi__peripheral__mode=Single
psu__rpu__power__on=1 | psu__sata__lane0__enable=0 | psu__sata__lane1__enable=0 | psu__sata__peripheral__enable=0
psu__sd0__grp_cd__enable=0 | psu__sd0__grp_pow__enable=0 | psu__sd0__grp_wp__enable=0 | psu__sd0__peripheral__enable=0
psu__sd1__grp_cd__enable=1 | psu__sd1__grp_cd__io=MIO 45 | psu__sd1__grp_pow__enable=1 | psu__sd1__grp_pow__io=MIO 43
psu__sd1__grp_wp__enable=0 | psu__sd1__peripheral__enable=1 | psu__sd1__peripheral__io=MIO 39 .. 51 | psu__sd1__slot_type=SD 3.0
psu__spi0__grp_ss0__enable=0 | psu__spi0__grp_ss1__enable=0 | psu__spi0__grp_ss2__enable=0 | psu__spi0__peripheral__enable=0
psu__spi0_loop_spi1__enable=0 | psu__spi1__grp_ss0__enable=1 | psu__spi1__grp_ss0__io=MIO 9 | psu__spi1__grp_ss1__enable=0
psu__spi1__grp_ss2__enable=0 | psu__spi1__peripheral__enable=1 | psu__spi1__peripheral__io=MIO 6 .. 11 | psu__swdt0__peripheral__enable=1
psu__swdt1__peripheral__enable=1 | psu__tcm0a__power__on=1 | psu__tcm0b__power__on=1 | psu__tcm1a__power__on=1
psu__tcm1b__power__on=1 | psu__testscan__peripheral__enable=0 | psu__trace__peripheral__enable=0 | psu__ttc0__peripheral__enable=1
psu__ttc1__peripheral__enable=1 | psu__ttc2__peripheral__enable=1 | psu__ttc3__peripheral__enable=1 | psu__uart0__modem__enable=0
psu__uart0__peripheral__enable=0 | psu__uart0_loop_uart1__enable=0 | psu__uart1__baud_rate=115200 | psu__uart1__modem__enable=0
psu__uart1__peripheral__enable=1 | psu__uart1__peripheral__io=MIO 36 .. 37 | psu__usb0__peripheral__enable=1 | psu__usb0__peripheral__io=MIO 52 .. 63

psu__usb1__peripheral__enable=0

report_design_analysis

command_line_options
-append=default::[not_specified] | -bounding_boxes=default::[not_specified] | -cells=default::[not_specified] | -complexity=default::[not_specified]
-congestion=default::[not_specified] | -end_point_clocks=default::[not_specified] | -extend=default::[not_specified] | -extract_metrics=default::[not_specified]
-file=default::[not_specified] | -full_logical_pin=default::[not_specified] | -hierarchical_depth=default::[not_specified] | -hold=default::[not_specified]
-logic_level_dist_paths=default::[not_specified] | -logic_level_distribution=default::[not_specified] | -logic_levels=default::[not_specified] | -max_level=default::[not_specified]
-max_paths=default::[not_specified] | -min_congestion_level=default::5 | -min_level=default::[not_specified] | -name=default::[not_specified]
-no_header=default::[not_specified] | -of_timing_paths=default::[not_specified] | -pploc_distance=default::[not_specified] | -qor_summary=[specified]
-quiet=default::[not_specified] | -return_string=default::[not_specified] | -return_timing_paths=default::[not_specified] | -routed_vs_estimated=default::[not_specified]
-routes=default::[not_specified] | -setup=default::[not_specified] | -show_all_congestion_windows=default::false | -suggestion=default::[not_specified]
-timing=default::[not_specified] | -verbose=default::[not_specified]

usage

runtime=0.3 secs

usage_count

qor_summary=4

report_drc

command_line_options
-append=default::[not_specified] | -checks=default::[not_specified] | -fail_on=default::[not_specified] | -force=default::[not_specified]
-format=default::[not_specified] | -internal=default::[not_specified] | -internal_only=default::[not_specified] | -max_msgs_per_check=default::[not_specified]
-messages=default::[not_specified] | -name=default::[not_specified] | -no_waivers=default::[not_specified] | -return_string=default::[not_specified]
-ruledecks=default::[not_specified] | -upgrade_cw=default::[not_specified] | -waived=default::[not_specified]

report_methodology

command_line_options
-append=default::[not_specified] | -checks=default::[not_specified] | -fail_on=default::[not_specified] | -force=default::[not_specified]
-format=default::[not_specified] | -merge_exceptions =default::[not_specified] | -messages=default::[not_specified] | -name=default::[not_specified]
-return_string=default::[not_specified] | -slack_lesser_than=default::[not_specified] | -waived=default::[not_specified]

report_power

command_line_options
-advisory=default::[not_specified] | -append=default::[not_specified] | -file=[specified] | -format=default::text
-hier=default::power | -hierarchical_depth=default::4 | -l=default::[not_specified] | -name=default::[not_specified]
-no_propagation=default::[not_specified] | -return_string=default::[not_specified] | -rpx=[specified] | -verbose=default::[not_specified]
-vid=default::[not_specified] | -xpe=default::[not_specified]

usage
airflow=250 (LFM) | ambient_temp=25.0 (C) | bi-dir_toggle=12.500000 | bidir_output_enable=1.000000
board_layers=12to15 (12 to 15 Layers) | board_selection=medium (10"x10") | clocks=0.001056 | confidence_level_clock_activity=High
confidence_level_design_state=High | confidence_level_device_models=High | confidence_level_internal_activity=High | confidence_level_io_activity=High
confidence_level_overall=High | customer=TBD | customer_class=TBD | devstatic=0.301196
die=xck26-sfvc784-2LV-c | dsp_output_toggle=12.500000 | dynamic=2.547053 | effective_thetaja=2.32
enable_probability=0.990000 | family=zynquplus | ff_toggle=12.500000 | flow_state=routed
heatsink=medium (Medium Profile) | input_toggle=12.500000 | junction_temp=31.6 (C) | logic=0.000000
mgtavcc_dynamic_current=0.000000 | mgtavcc_static_current=0.000000 | mgtavcc_total_current=0.000000 | mgtavcc_voltage=0.900000
mgtavtt_dynamic_current=0.000000 | mgtavtt_static_current=0.000000 | mgtavtt_total_current=0.000000 | mgtavtt_voltage=1.200000
mgtvccaux_dynamic_current=0.000000 | mgtvccaux_static_current=0.000000 | mgtvccaux_total_current=0.000000 | mgtvccaux_voltage=1.800000
netlist_net_matched=NA | off-chip_power=0.000000 | on-chip_power=2.848249 | output_enable=1.000000
output_load=0.000000 | output_toggle=12.500000 | package=sfvc784 | pct_clock_constrained=2.970000
pct_inputs_defined=0 | platform=lin64 | process=typical | ps8=2.545998
ram_enable=50.000000 | ram_write=50.000000 | read_saif=False | set/reset_probability=0.000000
signal_rate=False | simulation_file=None | speedgrade=-2LV | static_prob=False
temp_grade=commercial | thetajb=2.3 (C/W) | thetasa=5.5 (C/W) | toggle_rate=False
user_board_temp=25.0 (C) | user_effective_thetaja=2.32 | user_junc_temp=31.6 (C) | user_thetajb=2.3 (C/W)
user_thetasa=5.5 (C/W) | vcc_psadc_dynamic_current=0.000000 | vcc_psadc_static_current=0.000000 | vcc_psadc_total_current=0.000000
vcc_psadc_voltage=1.800000 | vcc_psaux_dynamic_current=0.000002 | vcc_psaux_static_current=0.000000 | vcc_psaux_total_current=0.000002
vcc_psaux_voltage=1.800000 | vcc_psbatt_dynamic_current=0.000000 | vcc_psbatt_static_current=0.000000 | vcc_psbatt_total_current=0.000000
vcc_psbatt_voltage=1.200000 | vcc_psddr_pll_dynamic_current=0.000000 | vcc_psddr_pll_static_current=0.000000 | vcc_psddr_pll_total_current=0.000000
vcc_psddr_pll_voltage=1.800000 | vcc_psintfp_ddr_dynamic_current=0.725560 | vcc_psintfp_ddr_static_current=0.000000 | vcc_psintfp_ddr_total_current=0.725560
vcc_psintfp_ddr_voltage=0.850000 | vcc_psintfp_dynamic_current=0.962651 | vcc_psintfp_static_current=0.000000 | vcc_psintfp_total_current=0.962651
vcc_psintfp_voltage=0.850000 | vcc_psintlp_dynamic_current=0.248744 | vcc_psintlp_static_current=0.000000 | vcc_psintlp_total_current=0.248744
vcc_psintlp_voltage=0.850000 | vcc_pspll_dynamic_current=0.071264 | vcc_pspll_static_current=0.000000 | vcc_pspll_total_current=0.071264
vcc_pspll_voltage=1.200000 | vccadc_dynamic_current=0.000000 | vccadc_static_current=0.008000 | vccadc_total_current=0.008000
vccadc_voltage=1.800000 | vccaux_dynamic_current=0.000000 | vccaux_io_dynamic_current=0.000000 | vccaux_io_static_current=0.031312
vccaux_io_total_current=0.031312 | vccaux_io_voltage=1.800000 | vccaux_static_current=0.075221 | vccaux_total_current=0.075221
vccaux_voltage=1.800000 | vccbram_dynamic_current=0.000000 | vccbram_static_current=0.001275 | vccbram_total_current=0.001275
vccbram_voltage=0.850000 | vccint_dynamic_current=0.001466 | vccint_io_dynamic_current=0.000000 | vccint_io_static_current=0.036418
vccint_io_total_current=0.036418 | vccint_io_voltage=0.850000 | vccint_static_current=0.087496 | vccint_total_current=0.088962
vccint_voltage=0.720000 | vcco10_dynamic_current=0.000000 | vcco10_static_current=0.000000 | vcco10_total_current=0.000000
vcco10_voltage=1.000000 | vcco12_dynamic_current=0.000000 | vcco12_static_current=0.000000 | vcco12_total_current=0.000000
vcco12_voltage=1.200000 | vcco135_dynamic_current=0.000000 | vcco135_static_current=0.000000 | vcco135_total_current=0.000000
vcco135_voltage=1.350000 | vcco15_dynamic_current=0.000000 | vcco15_static_current=0.000000 | vcco15_total_current=0.000000
vcco15_voltage=1.500000 | vcco18_dynamic_current=0.000000 | vcco18_static_current=0.000000 | vcco18_total_current=0.000000
vcco18_voltage=1.800000 | vcco25_dynamic_current=0.000000 | vcco25_static_current=0.000000 | vcco25_total_current=0.000000
vcco25_voltage=2.500000 | vcco33_dynamic_current=0.000000 | vcco33_static_current=0.000000 | vcco33_total_current=0.000000
vcco33_voltage=3.300000 | vcco_psddr_504_dynamic_current=0.592387 | vcco_psddr_504_static_current=0.000000 | vcco_psddr_504_total_current=0.592387
vcco_psddr_504_voltage=1.200000 | vcco_psio0_500_dynamic_current=0.000356 | vcco_psio0_500_static_current=0.000000 | vcco_psio0_500_total_current=0.000356
vcco_psio0_500_voltage=1.800000 | vcco_psio1_501_dynamic_current=0.000356 | vcco_psio1_501_static_current=0.000000 | vcco_psio1_501_total_current=0.000356
vcco_psio1_501_voltage=1.800000 | vcco_psio2_502_dynamic_current=0.000178 | vcco_psio2_502_static_current=0.000000 | vcco_psio2_502_total_current=0.000178
vcco_psio2_502_voltage=1.800000 | vcco_psio3_503_dynamic_current=0.000000 | vcco_psio3_503_static_current=0.000000 | vcco_psio3_503_total_current=0.000000
vcco_psio3_503_voltage=1.800000 | version=2021.1 | vps_mgtravcc_dynamic_current=0.067119 | vps_mgtravcc_static_current=0.000000
vps_mgtravcc_total_current=0.067119 | vps_mgtravcc_voltage=0.850000 | vps_mgtravtt_dynamic_current=0.024750 | vps_mgtravtt_static_current=0.000000
vps_mgtravtt_total_current=0.024750 | vps_mgtravtt_voltage=1.800000

report_utilization

io_standard
analog=0 | analog_se=0 | diff_hstl_i=0 | diff_hstl_i_12=0
diff_hstl_i_18=0 | diff_hstl_i_dci=0 | diff_hstl_i_dci_12=0 | diff_hstl_i_dci_18=0
diff_hsul_12=0 | diff_hsul_12_dci=0 | diff_pod10=0 | diff_pod10_dci=0
diff_pod12=0 | diff_pod12_dci=0 | diff_sstl12=0 | diff_sstl12_dci=0
diff_sstl135=0 | diff_sstl135_dci=0 | diff_sstl135_ii=0 | diff_sstl15=0
diff_sstl15_dci=0 | diff_sstl15_ii=0 | diff_sstl18_i=0 | diff_sstl18_i_dci=0
diff_sstl18_ii=0 | hslvdci_15=0 | hslvdci_18=0 | hstl_i=0
hstl_i_12=0 | hstl_i_18=0 | hstl_i_dci=0 | hstl_i_dci_12=0
hstl_i_dci_18=0 | hsul_12=0 | hsul_12_dci=0 | lvcmos12=0
lvcmos15=0 | lvcmos18=0 | lvcmos25=0 | lvcmos33=0
lvdci_15=0 | lvdci_18=0 | lvds=0 | lvds_25=0
lvpecl=0 | lvttl=0 | mipi_dphy_dci=0 | pod10=0
pod10_dci=0 | pod12=0 | pod12_dci=0 | slvs_400_18=0
slvs_400_25=0 | sstl12=0 | sstl12_dci=0 | sstl135=0
sstl135_dci=0 | sstl135_ii=0 | sstl15=0 | sstl15_dci=0
sstl15_ii=0 | sstl18_i=0 | sstl18_i_dci=0 | sstl18_ii=0

sub_lvds=0

primitives
bufg_ps_functional_category=Clock | bufg_ps_used=2 | ps8_functional_category=Advanced | ps8_used=1

synthesis

command_line_options
-assert=default::[not_specified] | -bufg=default::12 | -cascade_dsp=default::auto | -constrset=default::[not_specified]
-control_set_opt_threshold=default::auto | -debug_log=default::[not_specified] | -directive=default::default | -fanout_limit=default::10000
-flatten_hierarchy=default::rebuilt | -fsm_extraction=default::auto | -gated_clock_conversion=default::off | -generic=default::[not_specified]
-include_dirs=default::[not_specified] | -incremental=default::[not_specified] | -keep_equivalent_registers=default::[not_specified] | -lint=default::[not_specified]
-max_bram=default::-1 | -max_bram_cascade_height=default::-1 | -max_dsp=default::-1 | -max_uram=default::-1
-max_uram_cascade_height=default::-1 | -mode=default::default | -name=default::[not_specified] | -no_lc=default::[not_specified]
-no_srlextract=default::[not_specified] | -no_timing_driven=default::[not_specified] | -os=default::[not_specified] | -part=xck26-sfvc784-2LV-c
-resource_sharing=default::auto | -retiming=default::[not_specified] | -rtl=default::[not_specified] | -rtl_skip_constraints=default::[not_specified]
-rtl_skip_ip=default::[not_specified] | -seu_protect=default::none | -sfcu=default::[not_specified] | -shreg_min_size=default::3
-top=project_1_wrapper | -verilog_define=default::[not_specified]

usage
elapsed=00:00:30s | hls_ip=0 | memory_gain=901.492MB | memory_peak=3483.789MB
