Tai-Min/KV260-Human-Detector/hardware/hardware.pdf

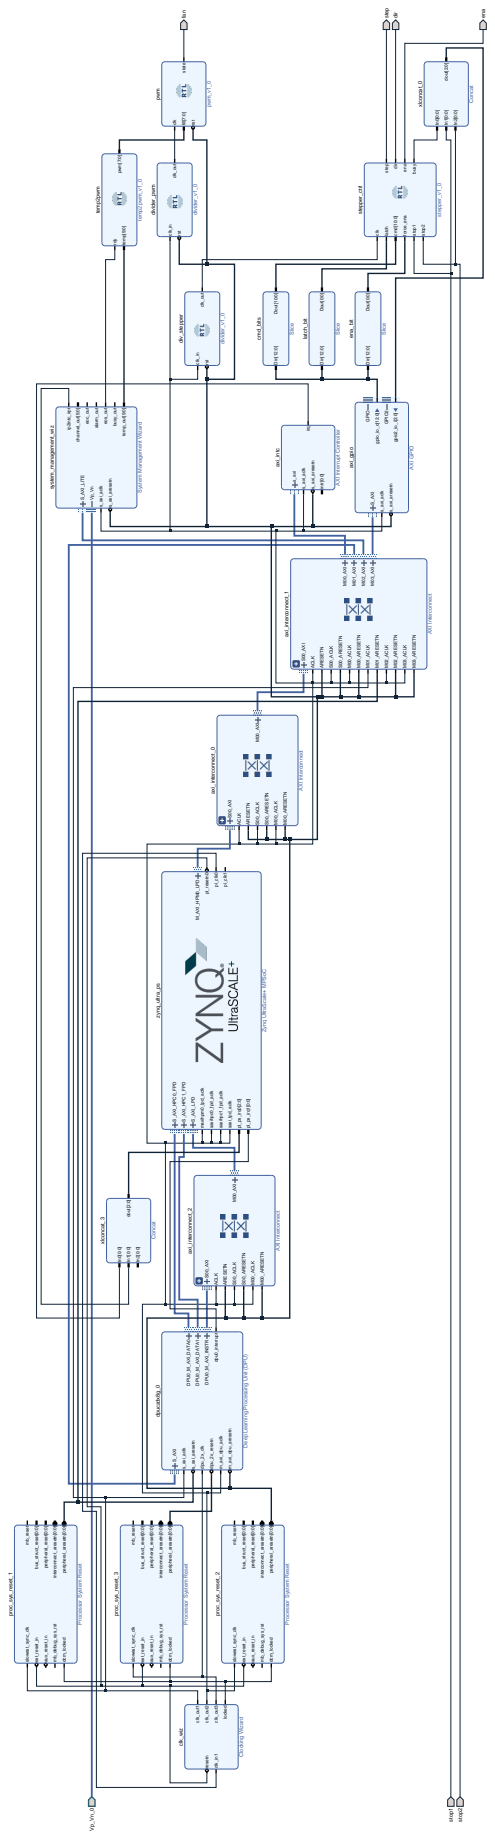
[picture p12: page 1]
axi_gpio; AXI GPIO; S_AXI GPIO; gpio_io_o[12:0] GPIO2; gpio2_io_i[2:0]; s_axi_aclk; s_axi_aresetn; axi_intc; s_axi s_axi_aclk; intr[0:0]; irq; axi_interconnect_0; AXI Interconnect; S00_AXI; M00_AXI; ACLK; ARESETN; S00_ACLK; S00_ARESETN M00_ACLK M00_ARESETN axi_interconnect_1; M00_AXI M01_AXI M02_AXI M03_AXI; S00_ARESETN M00_ACLK M00_ARESETN M01_ACLK M01_ARESETN M02_ACLK M02_ARESETN M03_ACLK M03_ARESETN; axi_interconnect_2; S00_ARESETN M00_ACLK M00_ARESETN; clk_wiz; Clocking Wizard; resetn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

System Management Wizard

AXI Interrupt Controller

Zynq UltraScale+ MPSoC

Deep Learning Processing Unit (DPU)

Processor System Reset
