Tai-Min/KV260-Human-Detector/pmod_shield/pcb.pdf

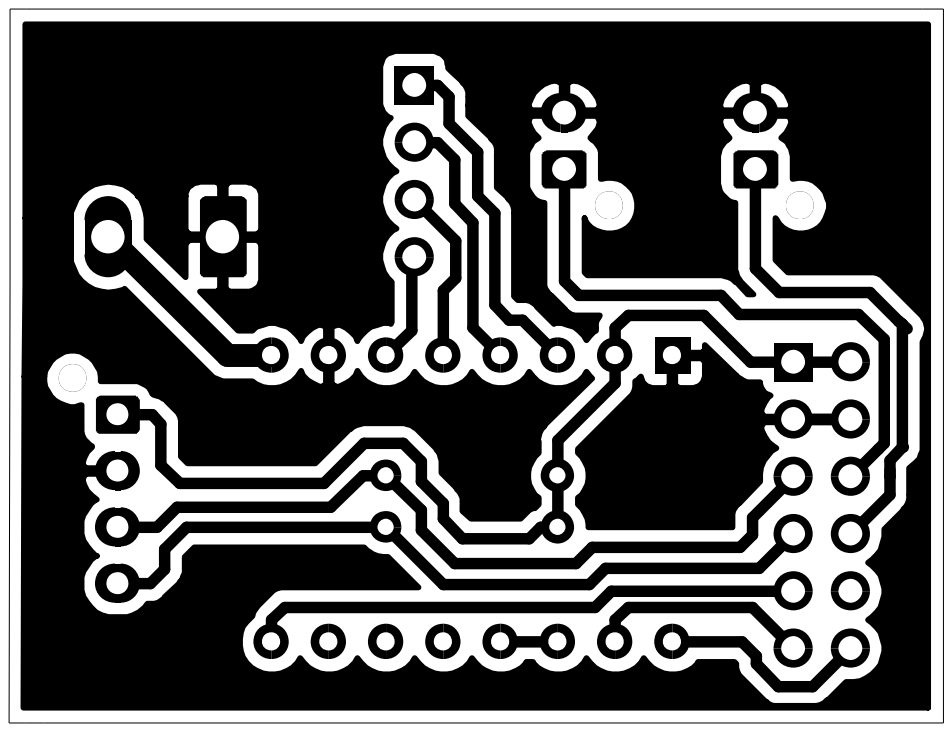
[picture p13: page 1]
