Tai-Min/KV260-Human-Detector/pmod_shield/pmod_shield.kicad_pcb

## KiCad design pmod_shield/pmod_shield.kicad_pcb (2022-01-18)

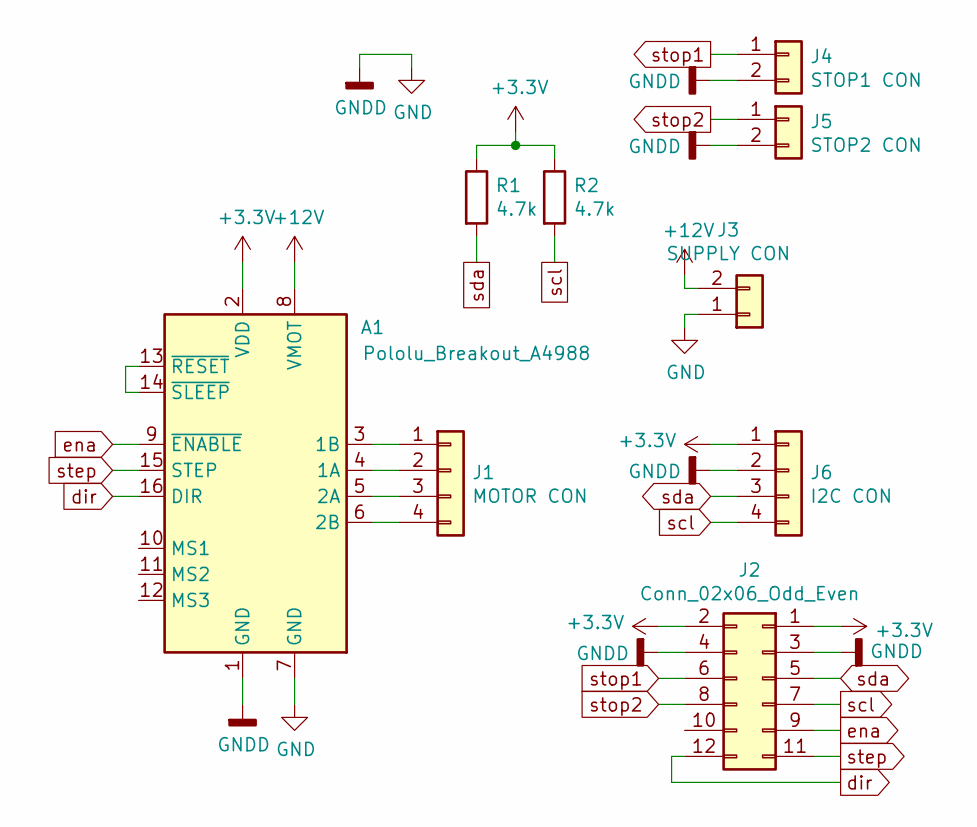
[picture p14: schematic pmod_shield.sch]

Parts:
A1: Pololu_Breakout_A4988; Pololu_Breakout-16_15.2x20.3mm
J1: MOTOR CON; PinHeader_1x04_P2.54mm_Vertical
J2: Conn_02x06_Odd_Even; PinHeader_2x06_P2.54mm_Horizontal
J3: SUPPLY CON; PhoenixContact_MSTBA_2,5_2-G-5,08_1x02_P5.08mm_Horizontal
J4: STOP1 CON; JST_XH_B2B-XH-AM_1x02_P2.50mm_Vertical
J5: STOP2 CON; JST_XH_B2B-XH-AM_1x02_P2.50mm_Vertical
J6: I2C CON; JST_XH_B4B-XH-AM_1x04_P2.50mm_Vertical
R1, R2: 4.7k; R_Axial_DIN0204_L3.6mm_D1.6mm_P7.62mm_Horizontal

Connections:
+3V3: A1.2 (VDD), J2.1, J2.2, J6.1, R1.1, R2.1
+12V: A1.8 (VMOT), J3.2
GND: A1.1 (GND), A1.7 (GND), J2.3, J2.4, J3.1, J4.2, J5.2, J6.2
unnamed: A1.3 (1B), J1.1
unnamed: A1.4 (1A), J1.2
unnamed: A1.5 (2A), J1.3
unnamed: A1.6 (2B), J1.4
unnamed: A1.13 (~RESET), A1.14 (~SLEEP)
dir: A1.16 (DIR), J2.12
ena: A1.9 (~ENABLE), J2.9
scl: J2.7, J6.4, R2.2
sda: J2.5, J6.3, R1.2
step: A1.15 (STEP), J2.11
stop1: J2.6, J4.1
stop2: J2.8, J5.1

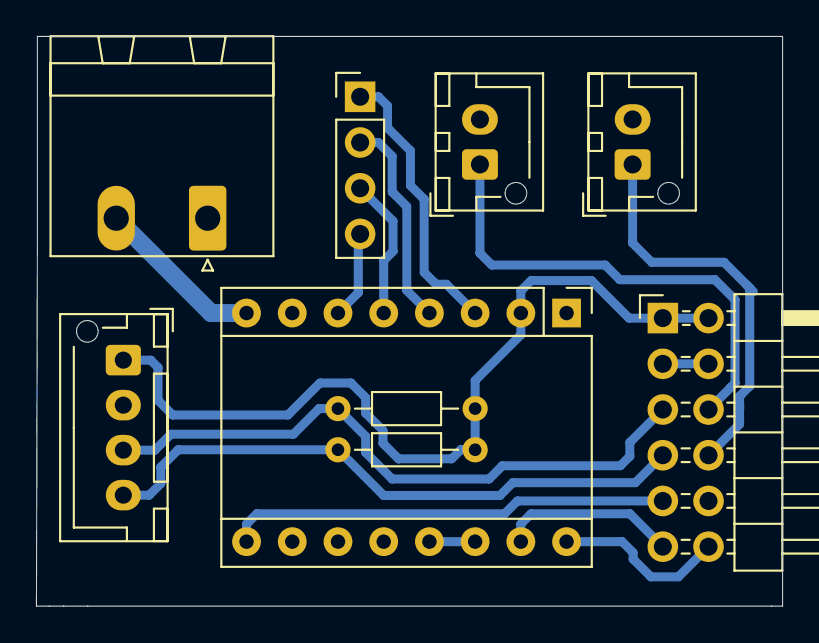
[picture p15: board pmod_shield.kicad_pcb from above]

Board: 2 copper layers, 41.5 x 31.6 mm, 9 parts (0 on the bottom side), 15 nets.
