Tai-Min/KV260-Human-Detector/hardware/hardware.runs/synth_1/.Xil/hardware_wrapper_propImpl.xdc

set_property SRC_FILE_INFO {cfile:/home/mateusz/KV260/hardware/hardware.srcs/constrs_1/imports/new/system.xdc rfile:../../../hardware.srcs/constrs_1/imports/new/system.xdc id:1} [current_design]
set_property src_info {type:XDC file:1 line:1 export:INPUT save:INPUT read:READ} [current_design]
set_property PACKAGE_PIN B11 [get_ports stop1]
set_property src_info {type:XDC file:1 line:5 export:INPUT save:INPUT read:READ} [current_design]
set_property PACKAGE_PIN D11 [get_ports stop2]
set_property src_info {type:XDC file:1 line:9 export:INPUT save:INPUT read:READ} [current_design]
set_property PACKAGE_PIN H12 [get_ports step]
set_property src_info {type:XDC file:1 line:12 export:INPUT save:INPUT read:READ} [current_design]
set_property PACKAGE_PIN B10 [get_ports dir]
set_property src_info {type:XDC file:1 line:15 export:INPUT save:INPUT read:READ} [current_design]
set_property PACKAGE_PIN E10 [get_ports ena]
set_property src_info {type:XDC file:1 line:18 export:INPUT save:INPUT read:READ} [current_design]
set_property PACKAGE_PIN A12 [get_ports fan]
