Tai-Min/KV260-Human-Detector/hardware/hardware.srcs/constrs_1/imports/new/system.xdc

set_property PACKAGE_PIN B11 [get_ports stop1]
set_property IOSTANDARD LVCMOS33 [get_ports stop1]
set_property PULLTYPE PULLUP [get_ports stop1]

set_property PACKAGE_PIN D11 [get_ports stop2]
set_property IOSTANDARD LVCMOS33 [get_ports stop2]
set_property PULLTYPE PULLUP [get_ports stop2]

set_property PACKAGE_PIN H12 [get_ports step]
set_property IOSTANDARD LVCMOS33 [get_ports step]

set_property PACKAGE_PIN B10 [get_ports dir]
set_property IOSTANDARD LVCMOS33 [get_ports dir]

set_property PACKAGE_PIN E10 [get_ports ena]
set_property IOSTANDARD LVCMOS33 [get_ports ena]

set_property PACKAGE_PIN A12 [get_ports fan]
set_property IOSTANDARD LVCMOS33 [get_ports fan]
