Tai-Min/KV260-Human-Detector/hardware/hardware.gen/sources_1/bd/hardware/ip/hardware_axi_intc_0_0/synth/hardware_axi_intc_0_0.vhd

-- (c) Copyright 1995-2022 Xilinx, Inc. All rights reserved.
-- 
-- This file contains confidential and proprietary information
-- of Xilinx, Inc. and is protected under U.S. and
-- international copyright and other intellectual property
-- laws.
-- 
-- DISCLAIMER
-- This disclaimer is not a license and does not grant any
-- rights to the materials distributed herewith. Except as
-- otherwise provided in a valid license issued to you by
-- Xilinx, and to the maximum extent permitted by applicable
-- law: (1) THESE MATERIALS ARE MADE AVAILABLE "AS IS" AND
-- WITH ALL FAULTS, AND XILINX HEREBY DISCLAIMS ALL WARRANTIES
-- AND CONDITIONS, EXPRESS, IMPLIED, OR STATUTORY, INCLUDING
-- BUT NOT LIMITED TO WARRANTIES OF MERCHANTABILITY, NON-
-- INFRINGEMENT, OR FITNESS FOR ANY PARTICULAR PURPOSE; and
-- (2) Xilinx shall not be liable (whether in contract or tort,
-- including negligence, or under any other theory of
-- liability) for any loss or damage of any kind or nature
-- related to, arising under or in connection with these
-- materials, including for any direct, or any indirect,
-- special, incidental, or consequential loss or damage
-- (including loss of data, profits, goodwill, or any type of
-- loss or damage suffered as a result of any action brought
-- by a third party) even if such damage or loss was
-- reasonably foreseeable or Xilinx had been advised of the
-- possibility of the same.
-- 
-- CRITICAL APPLICATIONS
-- Xilinx products are not designed or intended to be fail-
-- safe, or for use in any application requiring fail-safe
-- performance, such as life-support or safety devices or
-- systems, Class III medical devices, nuclear facilities,
-- applications related to the deployment of airbags, or any
-- other applications that could lead to death, personal
-- injury, or severe property or environmental damage
-- (individually and collectively, "Critical
-- Applications"). Customer assumes the sole risk and
-- liability of any use of Xilinx products in Critical
-- Applications, subject only to applicable laws and
-- regulations governing limitations on product liability.
-- 
-- THIS COPYRIGHT NOTICE AND DISCLAIMER MUST BE RETAINED AS
-- PART OF THIS FILE AT ALL TIMES.
-- 
-- DO NOT MODIFY THIS FILE.

-- IP VLNV: xilinx.com:ip:axi_intc:4.1
-- IP Revision: 15

LIBRARY ieee;
USE ieee.std_logic_1164.ALL;
USE ieee.numeric_std.ALL;

LIBRARY axi_intc_v4_1_15;
USE axi_intc_v4_1_15.axi_intc;

ENTITY hardware_axi_intc_0_0 IS
  PORT (
    s_axi_aclk : IN STD_LOGIC;
    s_axi_aresetn : IN STD_LOGIC;
    s_axi_awaddr : IN STD_LOGIC_VECTOR(8 DOWNTO 0);
    s_axi_awvalid : IN STD_LOGIC;
    s_axi_awready : OUT STD_LOGIC;
    s_axi_wdata : IN STD_LOGIC_VECTOR(31 DOWNTO 0);
    s_axi_wstrb : IN STD_LOGIC_VECTOR(3 DOWNTO 0);
    s_axi_wvalid : IN STD_LOGIC;
    s_axi_wready : OUT STD_LOGIC;
    s_axi_bresp : OUT STD_LOGIC_VECTOR(1 DOWNTO 0);
    s_axi_bvalid : OUT STD_LOGIC;
    s_axi_bready : IN STD_LOGIC;
    s_axi_araddr : IN STD_LOGIC_VECTOR(8 DOWNTO 0);
    s_axi_arvalid : IN STD_LOGIC;
    s_axi_arready : OUT STD_LOGIC;
    s_axi_rdata : OUT STD_LOGIC_VECTOR(31 DOWNTO 0);
    s_axi_rresp : OUT STD_LOGIC_VECTOR(1 DOWNTO 0);
    s_axi_rvalid : OUT STD_LOGIC;
    s_axi_rready : IN STD_LOGIC;
    intr : IN STD_LOGIC_VECTOR(0 DOWNTO 0);
    irq : OUT STD_LOGIC
  );
END hardware_axi_intc_0_0;

ARCHITECTURE hardware_axi_intc_0_0_arch OF hardware_axi_intc_0_0 IS
  ATTRIBUTE DowngradeIPIdentifiedWarnings : STRING;
  ATTRIBUTE DowngradeIPIdentifiedWarnings OF hardware_axi_intc_0_0_arch: ARCHITECTURE IS "yes";
  COMPONENT axi_intc IS
    GENERIC (
      C_FAMILY : STRING;
      C_INSTANCE : STRING;
      C_S_AXI_ADDR_WIDTH : INTEGER;
      C_S_AXI_DATA_WIDTH : INTEGER;
      C_NUM_INTR_INPUTS : INTEGER;
      C_NUM_SW_INTR : INTEGER;
      C_KIND_OF_INTR : STD_LOGIC_VECTOR(31 DOWNTO 0);
      C_KIND_OF_EDGE : STD_LOGIC_VECTOR(31 DOWNTO 0);
      C_KIND_OF_LVL : STD_LOGIC_VECTOR(31 DOWNTO 0);
      C_ASYNC_INTR : STD_LOGIC_VECTOR(31 DOWNTO 0);
      C_NUM_SYNC_FF : INTEGER;
      C_ADDR_WIDTH : INTEGER;
      C_IVAR_RESET_VALUE : STD_LOGIC_VECTOR;
      C_ENABLE_ASYNC : INTEGER;
      C_HAS_IPR : INTEGER;
      C_HAS_SIE : INTEGER;
      C_HAS_CIE : INTEGER;
      C_HAS_IVR : INTEGER;
      C_HAS_ILR : INTEGER;
      C_IRQ_IS_LEVEL : INTEGER;
      C_IRQ_ACTIVE : STD_LOGIC;
      C_DISABLE_SYNCHRONIZERS : INTEGER;
      C_MB_CLK_NOT_CONNECTED : INTEGER;
      C_HAS_FAST : INTEGER;
      C_EN_CASCADE_MODE : INTEGER;
      C_CASCADE_MASTER : INTEGER
    );
    PORT (
      s_axi_aclk : IN STD_LOGIC;
      s_axi_aresetn : IN STD_LOGIC;
      s_axi_awaddr : IN STD_LOGIC_VECTOR(8 DOWNTO 0);
      s_axi_awvalid : IN STD_LOGIC;
      s_axi_awready : OUT STD_LOGIC;
      s_axi_wdata : IN STD_LOGIC_VECTOR(31 DOWNTO 0);
      s_axi_wstrb : IN STD_LOGIC_VECTOR(3 DOWNTO 0);
      s_axi_wvalid : IN STD_LOGIC;
      s_axi_wready : OUT STD_LOGIC;
      s_axi_bresp : OUT STD_LOGIC_VECTOR(1 DOWNTO 0);
      s_axi_bvalid : OUT STD_LOGIC;
      s_axi_bready : IN STD_LOGIC;
      s_axi_araddr : IN STD_LOGIC_VECTOR(8 DOWNTO 0);
      s_axi_arvalid : IN STD_LOGIC;
      s_axi_arready : OUT STD_LOGIC;
      s_axi_rdata : OUT STD_LOGIC_VECTOR(31 DOWNTO 0);
      s_axi_rresp : OUT STD_LOGIC_VECTOR(1 DOWNTO 0);
      s_axi_rvalid : OUT STD_LOGIC;
      s_axi_rready : IN STD_LOGIC;
      intr : IN STD_LOGIC_VECTOR(0 DOWNTO 0);
      processor_clk : IN STD_LOGIC;
      processor_rst : IN STD_LOGIC;
      irq : OUT STD_LOGIC;
      processor_ack : IN STD_LOGIC_VECTOR(1 DOWNTO 0);
      interrupt_address : OUT STD_LOGIC_VECTOR(31 DOWNTO 0);
      irq_in : IN STD_LOGIC;
      interrupt_address_in : IN STD_LOGIC_VECTOR(31 DOWNTO 0);
      processor_ack_out : OUT STD_LOGIC_VECTOR(1 DOWNTO 0)
    );
  END COMPONENT axi_intc;
  ATTRIBUTE X_CORE_INFO : STRING;
  ATTRIBUTE X_CORE_INFO OF hardware_axi_intc_0_0_arch: ARCHITECTURE IS "axi_intc,Vivado 2021.1";
  ATTRIBUTE CHECK_LICENSE_TYPE : STRING;
  ATTRIBUTE CHECK_LICENSE_TYPE OF hardware_axi_intc_0_0_arch : ARCHITECTURE IS "hardware_axi_intc_0_0,axi_intc,{}";
  ATTRIBUTE CORE_GENERATION_INFO : STRING;
  ATTRIBUTE CORE_GENERATION_INFO OF hardware_axi_intc_0_0_arch: ARCHITECTURE IS "hardware_axi_intc_0_0,axi_intc,{x_ipProduct=Vivado 2021.1,x_ipVendor=xilinx.com,x_ipLibrary=ip,x_ipName=axi_intc,x_ipVersion=4.1,x_ipCoreRevision=15,x_ipLanguage=VERILOG,x_ipSimLanguage=MIXED,C_FAMILY=zynquplus,C_INSTANCE=hardware_axi_intc_0_0,C_S_AXI_ADDR_WIDTH=9,C_S_AXI_DATA_WIDTH=32,C_NUM_INTR_INPUTS=1,C_NUM_SW_INTR=0,C_KIND_OF_INTR=0xfffffffc,C_KIND_OF_EDGE=0xFFFFFFFF,C_KIND_OF_LVL=0xFFFFFFFF,C_ASYNC_INTR=0xFFFFFFFF,C_NUM_SYNC_FF=2,C_ADDR_WIDTH=32,C_IVAR_RESET_VALUE=0x0000000000000010,C_ENAB" & 
"LE_ASYNC=0,C_HAS_IPR=1,C_HAS_SIE=1,C_HAS_CIE=1,C_HAS_IVR=1,C_HAS_ILR=0,C_IRQ_IS_LEVEL=1,C_IRQ_ACTIVE=0x1,C_DISABLE_SYNCHRONIZERS=0,C_MB_CLK_NOT_CONNECTED=1,C_HAS_FAST=0,C_EN_CASCADE_MODE=0,C_CASCADE_MASTER=0}";
  ATTRIBUTE X_INTERFACE_INFO : STRING;
  ATTRIBUTE X_INTERFACE_PARAMETER : STRING;
  ATTRIBUTE X_INTERFACE_PARAMETER OF irq: SIGNAL IS "XIL_INTERFACENAME interrupt.irq, SENSITIVITY LEVEL_HIGH, PortWidth 1";
  ATTRIBUTE X_INTERFACE_INFO OF irq: SIGNAL IS "xilinx.com:signal:interrupt:1.0 interrupt.irq INTERRUPT";
  ATTRIBUTE X_INTERFACE_PARAMETER OF intr: SIGNAL IS "XIL_INTERFACENAME interrupt_input, SENSITIVITY LEVEL_HIGH, PortWidth 1";
  ATTRIBUTE X_INTERFACE_INFO OF intr: SIGNAL IS "xilinx.com:signal:interrupt:1.0 interrupt_input INTERRUPT";
  ATTRIBUTE X_INTERFACE_INFO OF s_axi_rready: SIGNAL IS "xilinx.com:interface:aximm:1.0 s_axi RREADY";
  ATTRIBUTE X_INTERFACE_INFO OF s_axi_rvalid: SIGNAL IS "xilinx.com:interface:aximm:1.0 s_axi RVALID";
  ATTRIBUTE X_INTERFACE_INFO OF s_axi_rresp: SIGNAL IS "xilinx.com:interface:aximm:1.0 s_axi RRESP";
  ATTRIBUTE X_INTERFACE_INFO OF s_axi_rdata: SIGNAL IS "xilinx.com:interface:aximm:1.0 s_axi RDATA";
  ATTRIBUTE X_INTERFACE_INFO OF s_axi_arready: SIGNAL IS "xilinx.com:interface:aximm:1.0 s_axi ARREADY";
  ATTRIBUTE X_INTERFACE_INFO OF s_axi_arvalid: SIGNAL IS "xilinx.com:interface:aximm:1.0 s_axi ARVALID";
  ATTRIBUTE X_INTERFACE_INFO OF s_axi_araddr: SIGNAL IS "xilinx.com:interface:aximm:1.0 s_axi ARADDR";
  ATTRIBUTE X_INTERFACE_INFO OF s_axi_bready: SIGNAL IS "xilinx.com:interface:aximm:1.0 s_axi BREADY";
  ATTRIBUTE X_INTERFACE_INFO OF s_axi_bvalid: SIGNAL IS "xilinx.com:interface:aximm:1.0 s_axi BVALID";
  ATTRIBUTE X_INTERFACE_INFO OF s_axi_bresp: SIGNAL IS "xilinx.com:interface:aximm:1.0 s_axi BRESP";
  ATTRIBUTE X_INTERFACE_INFO OF s_axi_wready: SIGNAL IS "xilinx.com:interface:aximm:1.0 s_axi WREADY";
  ATTRIBUTE X_INTERFACE_INFO OF s_axi_wvalid: SIGNAL IS "xilinx.com:interface:aximm:1.0 s_axi WVALID";
  ATTRIBUTE X_INTERFACE_INFO OF s_axi_wstrb: SIGNAL IS "xilinx.com:interface:aximm:1.0 s_axi WSTRB";
  ATTRIBUTE X_INTERFACE_INFO OF s_axi_wdata: SIGNAL IS "xilinx.com:interface:aximm:1.0 s_axi WDATA";
  ATTRIBUTE X_INTERFACE_INFO OF s_axi_awready: SIGNAL IS "xilinx.com:interface:aximm:1.0 s_axi AWREADY";
  ATTRIBUTE X_INTERFACE_INFO OF s_axi_awvalid: SIGNAL IS "xilinx.com:interface:aximm:1.0 s_axi AWVALID";
  ATTRIBUTE X_INTERFACE_PARAMETER OF s_axi_awaddr: SIGNAL IS "XIL_INTERFACENAME s_axi, DATA_WIDTH 32, PROTOCOL AXI4LITE, FREQ_HZ 99999000, ID_WIDTH 0, ADDR_WIDTH 9, AWUSER_WIDTH 0, ARUSER_WIDTH 0, WUSER_WIDTH 0, RUSER_WIDTH 0, BUSER_WIDTH 0, READ_WRITE_MODE READ_WRITE, HAS_BURST 0, HAS_LOCK 0, HAS_PROT 0, HAS_CACHE 0, HAS_QOS 0, HAS_REGION 0, HAS_WSTRB 1, HAS_BRESP 1, HAS_RRESP 1, SUPPORTS_NARROW_BURST 0, NUM_READ_OUTSTANDING 2, NUM_WRITE_OUTSTANDING 2, MAX_BURST_LENGTH 1, PHASE 0.0, CLK_DOMAIN /clk_wiz_0_clk_out1, NUM_READ_THREADS 1, NUM_WRITE_THREADS 1, " & 
"RUSER_BITS_PER_BYTE 0, WUSER_BITS_PER_BYTE 0, INSERT_VIP 0";
  ATTRIBUTE X_INTERFACE_INFO OF s_axi_awaddr: SIGNAL IS "xilinx.com:interface:aximm:1.0 s_axi AWADDR";
  ATTRIBUTE X_INTERFACE_PARAMETER OF s_axi_aresetn: SIGNAL IS "XIL_INTERFACENAME s_resetn, POLARITY ACTIVE_LOW, INSERT_VIP 0";
  ATTRIBUTE X_INTERFACE_INFO OF s_axi_aresetn: SIGNAL IS "xilinx.com:signal:reset:1.0 s_resetn RST";
  ATTRIBUTE X_INTERFACE_PARAMETER OF s_axi_aclk: SIGNAL IS "XIL_INTERFACENAME s_axi_aclk, ASSOCIATED_BUSIF s_axi, ASSOCIATED_RESET s_axi_aresetn, FREQ_HZ 99999000, FREQ_TOLERANCE_HZ 0, PHASE 0.0, CLK_DOMAIN /clk_wiz_0_clk_out1, INSERT_VIP 0";
  ATTRIBUTE X_INTERFACE_INFO OF s_axi_aclk: SIGNAL IS "xilinx.com:signal:clock:1.0 s_axi_aclk CLK";
BEGIN
  U0 : axi_intc
    GENERIC MAP (
      C_FAMILY => "zynquplus",
      C_INSTANCE => "hardware_axi_intc_0_0",
      C_S_AXI_ADDR_WIDTH => 9,
      C_S_AXI_DATA_WIDTH => 32,
      C_NUM_INTR_INPUTS => 1,
      C_NUM_SW_INTR => 0,
      C_KIND_OF_INTR => X"fffffffc",
      C_KIND_OF_EDGE => X"FFFFFFFF",
      C_KIND_OF_LVL => X"FFFFFFFF",
      C_ASYNC_INTR => X"FFFFFFFF",
      C_NUM_SYNC_FF => 2,
      C_ADDR_WIDTH => 32,
      C_IVAR_RESET_VALUE => X"0000000000000010",
      C_ENABLE_ASYNC => 0,
      C_HAS_IPR => 1,
      C_HAS_SIE => 1,
      C_HAS_CIE => 1,
      C_HAS_IVR => 1,
      C_HAS_ILR => 0,
      C_IRQ_IS_LEVEL => 1,
      C_IRQ_ACTIVE => '1',
      C_DISABLE_SYNCHRONIZERS => 0,
      C_MB_CLK_NOT_CONNECTED => 1,
      C_HAS_FAST => 0,
      C_EN_CASCADE_MODE => 0,
      C_CASCADE_MASTER => 0
    )
    PORT MAP (
      s_axi_aclk => s_axi_aclk,
      s_axi_aresetn => s_axi_aresetn,
      s_axi_awaddr => s_axi_awaddr,
      s_axi_awvalid => s_axi_awvalid,
      s_axi_awready => s_axi_awready,
      s_axi_wdata => s_axi_wdata,
      s_axi_wstrb => s_axi_wstrb,
      s_axi_wvalid => s_axi_wvalid,
      s_axi_wready => s_axi_wready,
      s_axi_bresp => s_axi_bresp,
      s_axi_bvalid => s_axi_bvalid,
      s_axi_bready => s_axi_bready,
      s_axi_araddr => s_axi_araddr,
      s_axi_arvalid => s_axi_arvalid,
      s_axi_arready => s_axi_arready,
      s_axi_rdata => s_axi_rdata,
      s_axi_rresp => s_axi_rresp,
      s_axi_rvalid => s_axi_rvalid,
      s_axi_rready => s_axi_rready,
      intr => intr,
      processor_clk => '0',
      processor_rst => '0',
      irq => irq,
      processor_ack => STD_LOGIC_VECTOR(TO_UNSIGNED(0, 2)),
      irq_in => '0',
      interrupt_address_in => STD_LOGIC_VECTOR(TO_UNSIGNED(0, 32))
    );
END hardware_axi_intc_0_0_arch;
