Tai-Min/KV260-Human-Detector/hardware/hardware.gen/sources_1/bd/hardware/ip/hardware_zynq_ultra_ps_e_0_0/hardware_zynq_ultra_ps_e_0_0_stub.vhdl

-- Copyright 1986-2021 Xilinx, Inc. All Rights Reserved.
-- --------------------------------------------------------------------------------
-- Tool Version: Vivado v.2021.1 (lin64) Build 3247384 Thu Jun 10 19:36:07 MDT 2021
-- Date        : Fri Mar 18 15:52:42 2022
-- Host        : PC running 64-bit Ubuntu 20.04.4 LTS
-- Command     : write_vhdl -force -mode synth_stub
--               /home/mateusz/KV260/hardware/hardware.gen/sources_1/bd/hardware/ip/hardware_zynq_ultra_ps_e_0_0/hardware_zynq_ultra_ps_e_0_0_stub.vhdl
-- Design      : hardware_zynq_ultra_ps_e_0_0
-- Purpose     : Stub declaration of top-level module interface
-- Device      : xck26-sfvc784-2LV-c
-- --------------------------------------------------------------------------------
library IEEE;
use IEEE.STD_LOGIC_1164.ALL;

entity hardware_zynq_ultra_ps_e_0_0 is
  Port ( 
    maxihpm0_lpd_aclk : in STD_LOGIC;
    maxigp2_awid : out STD_LOGIC_VECTOR ( 15 downto 0 );
    maxigp2_awaddr : out STD_LOGIC_VECTOR ( 39 downto 0 );
    maxigp2_awlen : out STD_LOGIC_VECTOR ( 7 downto 0 );
    maxigp2_awsize : out STD_LOGIC_VECTOR ( 2 downto 0 );
    maxigp2_awburst : out STD_LOGIC_VECTOR ( 1 downto 0 );
    maxigp2_awlock : out STD_LOGIC;
    maxigp2_awcache : out STD_LOGIC_VECTOR ( 3 downto 0 );
    maxigp2_awprot : out STD_LOGIC_VECTOR ( 2 downto 0 );
    maxigp2_awvalid : out STD_LOGIC;
    maxigp2_awuser : out STD_LOGIC_VECTOR ( 15 downto 0 );
    maxigp2_awready : in STD_LOGIC;
    maxigp2_wdata : out STD_LOGIC_VECTOR ( 31 downto 0 );
    maxigp2_wstrb : out STD_LOGIC_VECTOR ( 3 downto 0 );
    maxigp2_wlast : out STD_LOGIC;
    maxigp2_wvalid : out STD_LOGIC;
    maxigp2_wready : in STD_LOGIC;
    maxigp2_bid : in STD_LOGIC_VECTOR ( 15 downto 0 );
    maxigp2_bresp : in STD_LOGIC_VECTOR ( 1 downto 0 );
    maxigp2_bvalid : in STD_LOGIC;
    maxigp2_bready : out STD_LOGIC;
    maxigp2_arid : out STD_LOGIC_VECTOR ( 15 downto 0 );
    maxigp2_araddr : out STD_LOGIC_VECTOR ( 39 downto 0 );
    maxigp2_arlen : out STD_LOGIC_VECTOR ( 7 downto 0 );
    maxigp2_arsize : out STD_LOGIC_VECTOR ( 2 downto 0 );
    maxigp2_arburst : out STD_LOGIC_VECTOR ( 1 downto 0 );
    maxigp2_arlock : out STD_LOGIC;
    maxigp2_arcache : out STD_LOGIC_VECTOR ( 3 downto 0 );
    maxigp2_arprot : out STD_LOGIC_VECTOR ( 2 downto 0 );
    maxigp2_arvalid : out STD_LOGIC;
    maxigp2_aruser : out STD_LOGIC_VECTOR ( 15 downto 0 );
    maxigp2_arready : in STD_LOGIC;
    maxigp2_rid : in STD_LOGIC_VECTOR ( 15 downto 0 );
    maxigp2_rdata : in STD_LOGIC_VECTOR ( 31 downto 0 );
    maxigp2_rresp : in STD_LOGIC_VECTOR ( 1 downto 0 );
    maxigp2_rlast : in STD_LOGIC;
    maxigp2_rvalid : in STD_LOGIC;
    maxigp2_rready : out STD_LOGIC;
    maxigp2_awqos : out STD_LOGIC_VECTOR ( 3 downto 0 );
    maxigp2_arqos : out STD_LOGIC_VECTOR ( 3 downto 0 );
    saxihpc0_fpd_aclk : in STD_LOGIC;
    saxigp0_aruser : in STD_LOGIC;
    saxigp0_awuser : in STD_LOGIC;
    saxigp0_awid : in STD_LOGIC_VECTOR ( 5 downto 0 );
    saxigp0_awaddr : in STD_LOGIC_VECTOR ( 48 downto 0 );
    saxigp0_awlen : in STD_LOGIC_VECTOR ( 7 downto 0 );
    saxigp0_awsize : in STD_LOGIC_VECTOR ( 2 downto 0 );
    saxigp0_awburst : in STD_LOGIC_VECTOR ( 1 downto 0 );
    saxigp0_awlock : in STD_LOGIC;
    saxigp0_awcache : in STD_LOGIC_VECTOR ( 3 downto 0 );
    saxigp0_awprot : in STD_LOGIC_VECTOR ( 2 downto 0 );
    saxigp0_awvalid : in STD_LOGIC;
    saxigp0_awready : out STD_LOGIC;
    saxigp0_wdata : in STD_LOGIC_VECTOR ( 127 downto 0 );
    saxigp0_wstrb : in STD_LOGIC_VECTOR ( 15 downto 0 );
    saxigp0_wlast : in STD_LOGIC;
    saxigp0_wvalid : in STD_LOGIC;
    saxigp0_wready : out STD_LOGIC;
    saxigp0_bid : out STD_LOGIC_VECTOR ( 5 downto 0 );
    saxigp0_bresp : out STD_LOGIC_VECTOR ( 1 downto 0 );
    saxigp0_bvalid : out STD_LOGIC;
    saxigp0_bready : in STD_LOGIC;
    saxigp0_arid : in STD_LOGIC_VECTOR ( 5 downto 0 );
    saxigp0_araddr : in STD_LOGIC_VECTOR ( 48 downto 0 );
    saxigp0_arlen : in STD_LOGIC_VECTOR ( 7 downto 0 );
    saxigp0_arsize : in STD_LOGIC_VECTOR ( 2 downto 0 );
    saxigp0_arburst : in STD_LOGIC_VECTOR ( 1 downto 0 );
    saxigp0_arlock : in STD_LOGIC;
    saxigp0_arcache : in STD_LOGIC_VECTOR ( 3 downto 0 );
    saxigp0_arprot : in STD_LOGIC_VECTOR ( 2 downto 0 );
    saxigp0_arvalid : in STD_LOGIC;
    saxigp0_arready : out STD_LOGIC;
    saxigp0_rid : out STD_LOGIC_VECTOR ( 5 downto 0 );
    saxigp0_rdata : out STD_LOGIC_VECTOR ( 127 downto 0 );
    saxigp0_rresp : out STD_LOGIC_VECTOR ( 1 downto 0 );
    saxigp0_rlast : out STD_LOGIC;
    saxigp0_rvalid : out STD_LOGIC;
    saxigp0_rready : in STD_LOGIC;
    saxigp0_awqos : in STD_LOGIC_VECTOR ( 3 downto 0 );
    saxigp0_arqos : in STD_LOGIC_VECTOR ( 3 downto 0 );
    saxihpc1_fpd_aclk : in STD_LOGIC;
    saxigp1_aruser : in STD_LOGIC;
    saxigp1_awuser : in STD_LOGIC;
    saxigp1_awid : in STD_LOGIC_VECTOR ( 5 downto 0 );
    saxigp1_awaddr : in STD_LOGIC_VECTOR ( 48 downto 0 );
    saxigp1_awlen : in STD_LOGIC_VECTOR ( 7 downto 0 );
    saxigp1_awsize : in STD_LOGIC_VECTOR ( 2 downto 0 );
    saxigp1_awburst : in STD_LOGIC_VECTOR ( 1 downto 0 );
    saxigp1_awlock : in STD_LOGIC;
    saxigp1_awcache : in STD_LOGIC_VECTOR ( 3 downto 0 );
    saxigp1_awprot : in STD_LOGIC_VECTOR ( 2 downto 0 );
    saxigp1_awvalid : in STD_LOGIC;
    saxigp1_awready : out STD_LOGIC;
    saxigp1_wdata : in STD_LOGIC_VECTOR ( 127 downto 0 );
    saxigp1_wstrb : in STD_LOGIC_VECTOR ( 15 downto 0 );
    saxigp1_wlast : in STD_LOGIC;
    saxigp1_wvalid : in STD_LOGIC;
    saxigp1_wready : out STD_LOGIC;
    saxigp1_bid : out STD_LOGIC_VECTOR ( 5 downto 0 );
    saxigp1_bresp : out STD_LOGIC_VECTOR ( 1 downto 0 );
    saxigp1_bvalid : out STD_LOGIC;
    saxigp1_bready : in STD_LOGIC;
    saxigp1_arid : in STD_LOGIC_VECTOR ( 5 downto 0 );
    saxigp1_araddr : in STD_LOGIC_VECTOR ( 48 downto 0 );
    saxigp1_arlen : in STD_LOGIC_VECTOR ( 7 downto 0 );
    saxigp1_arsize : in STD_LOGIC_VECTOR ( 2 downto 0 );
    saxigp1_arburst : in STD_LOGIC_VECTOR ( 1 downto 0 );
    saxigp1_arlock : in STD_LOGIC;
    saxigp1_arcache : in STD_LOGIC_VECTOR ( 3 downto 0 );
    saxigp1_arprot : in STD_LOGIC_VECTOR ( 2 downto 0 );
    saxigp1_arvalid : in STD_LOGIC;
    saxigp1_arready : out STD_LOGIC;
    saxigp1_rid : out STD_LOGIC_VECTOR ( 5 downto 0 );
    saxigp1_rdata : out STD_LOGIC_VECTOR ( 127 downto 0 );
    saxigp1_rresp : out STD_LOGIC_VECTOR ( 1 downto 0 );
    saxigp1_rlast : out STD_LOGIC;
    saxigp1_rvalid : out STD_LOGIC;
    saxigp1_rready : in STD_LOGIC;
    saxigp1_awqos : in STD_LOGIC_VECTOR ( 3 downto 0 );
    saxigp1_arqos : in STD_LOGIC_VECTOR ( 3 downto 0 );
    saxi_lpd_aclk : in STD_LOGIC;
    saxigp6_aruser : in STD_LOGIC;
    saxigp6_awuser : in STD_LOGIC;
    saxigp6_awid : in STD_LOGIC_VECTOR ( 5 downto 0 );
    saxigp6_awaddr : in STD_LOGIC_VECTOR ( 48 downto 0 );
    saxigp6_awlen : in STD_LOGIC_VECTOR ( 7 downto 0 );
    saxigp6_awsize : in STD_LOGIC_VECTOR ( 2 downto 0 );
    saxigp6_awburst : in STD_LOGIC_VECTOR ( 1 downto 0 );
    saxigp6_awlock : in STD_LOGIC;
    saxigp6_awcache : in STD_LOGIC_VECTOR ( 3 downto 0 );
    saxigp6_awprot : in STD_LOGIC_VECTOR ( 2 downto 0 );
    saxigp6_awvalid : in STD_LOGIC;
    saxigp6_awready : out STD_LOGIC;
    saxigp6_wdata : in STD_LOGIC_VECTOR ( 31 downto 0 );
    saxigp6_wstrb : in STD_LOGIC_VECTOR ( 3 downto 0 );
    saxigp6_wlast : in STD_LOGIC;
    saxigp6_wvalid : in STD_LOGIC;
    saxigp6_wready : out STD_LOGIC;
    saxigp6_bid : out STD_LOGIC_VECTOR ( 5 downto 0 );
    saxigp6_bresp : out STD_LOGIC_VECTOR ( 1 downto 0 );
    saxigp6_bvalid : out STD_LOGIC;
    saxigp6_bready : in STD_LOGIC;
    saxigp6_arid : in STD_LOGIC_VECTOR ( 5 downto 0 );
    saxigp6_araddr : in STD_LOGIC_VECTOR ( 48 downto 0 );
    saxigp6_arlen : in STD_LOGIC_VECTOR ( 7 downto 0 );
    saxigp6_arsize : in STD_LOGIC_VECTOR ( 2 downto 0 );
    saxigp6_arburst : in STD_LOGIC_VECTOR ( 1 downto 0 );
    saxigp6_arlock : in STD_LOGIC;
    saxigp6_arcache : in STD_LOGIC_VECTOR ( 3 downto 0 );
    saxigp6_arprot : in STD_LOGIC_VECTOR ( 2 downto 0 );
    saxigp6_arvalid : in STD_LOGIC;
    saxigp6_arready : out STD_LOGIC;
    saxigp6_rid : out STD_LOGIC_VECTOR ( 5 downto 0 );
    saxigp6_rdata : out STD_LOGIC_VECTOR ( 31 downto 0 );
    saxigp6_rresp : out STD_LOGIC_VECTOR ( 1 downto 0 );
    saxigp6_rlast : out STD_LOGIC;
    saxigp6_rvalid : out STD_LOGIC;
    saxigp6_rready : in STD_LOGIC;
    saxigp6_awqos : in STD_LOGIC_VECTOR ( 3 downto 0 );
    saxigp6_arqos : in STD_LOGIC_VECTOR ( 3 downto 0 );
    pl_ps_irq0 : in STD_LOGIC_VECTOR ( 2 downto 0 );
    pl_resetn0 : out STD_LOGIC;
    pl_clk0 : out STD_LOGIC
  );

end hardware_zynq_ultra_ps_e_0_0;

architecture stub of hardware_zynq_ultra_ps_e_0_0 is
attribute syn_black_box : boolean;
attribute black_box_pad_pin : string;
attribute syn_black_box of stub : architecture is true;
attribute black_box_pad_pin of stub : architecture is "maxihpm0_lpd_aclk,maxigp2_awid[15:0],maxigp2_awaddr[39:0],maxigp2_awlen[7:0],maxigp2_awsize[2:0],maxigp2_awburst[1:0],maxigp2_awlock,maxigp2_awcache[3:0],maxigp2_awprot[2:0],maxigp2_awvalid,maxigp2_awuser[15:0],maxigp2_awready,maxigp2_wdata[31:0],maxigp2_wstrb[3:0],maxigp2_wlast,maxigp2_wvalid,maxigp2_wready,maxigp2_bid[15:0],maxigp2_bresp[1:0],maxigp2_bvalid,maxigp2_bready,maxigp2_arid[15:0],maxigp2_araddr[39:0],maxigp2_arlen[7:0],maxigp2_arsize[2:0],maxigp2_arburst[1:0],maxigp2_arlock,maxigp2_arcache[3:0],maxigp2_arprot[2:0],maxigp2_arvalid,maxigp2_aruser[15:0],maxigp2_arready,maxigp2_rid[15:0],maxigp2_rdata[31:0],maxigp2_rresp[1:0],maxigp2_rlast,maxigp2_rvalid,maxigp2_rready,maxigp2_awqos[3:0],maxigp2_arqos[3:0],saxihpc0_fpd_aclk,saxigp0_aruser,saxigp0_awuser,saxigp0_awid[5:0],saxigp0_awaddr[48:0],saxigp0_awlen[7:0],saxigp0_awsize[2:0],saxigp0_awburst[1:0],saxigp0_awlock,saxigp0_awcache[3:0],saxigp0_awprot[2:0],saxigp0_awvalid,saxigp0_awready,saxigp0_wdata[127:0],saxigp0_wstrb[15:0],saxigp0_wlast,saxigp0_wvalid,saxigp0_wready,saxigp0_bid[5:0],saxigp0_bresp[1:0],saxigp0_bvalid,saxigp0_bready,saxigp0_arid[5:0],saxigp0_araddr[48:0],saxigp0_arlen[7:0],saxigp0_arsize[2:0],saxigp0_arburst[1:0],saxigp0_arlock,saxigp0_arcache[3:0],saxigp0_arprot[2:0],saxigp0_arvalid,saxigp0_arready,saxigp0_rid[5:0],saxigp0_rdata[127:0],saxigp0_rresp[1:0],saxigp0_rlast,saxigp0_rvalid,saxigp0_rready,saxigp0_awqos[3:0],saxigp0_arqos[3:0],saxihpc1_fpd_aclk,saxigp1_aruser,saxigp1_awuser,saxigp1_awid[5:0],saxigp1_awaddr[48:0],saxigp1_awlen[7:0],saxigp1_awsize[2:0],saxigp1_awburst[1:0],saxigp1_awlock,saxigp1_awcache[3:0],saxigp1_awprot[2:0],saxigp1_awvalid,saxigp1_awready,saxigp1_wdata[127:0],saxigp1_wstrb[15:0],saxigp1_wlast,saxigp1_wvalid,saxigp1_wready,saxigp1_bid[5:0],saxigp1_bresp[1:0],saxigp1_bvalid,saxigp1_bready,saxigp1_arid[5:0],saxigp1_araddr[48:0],saxigp1_arlen[7:0],saxigp1_arsize[2:0],saxigp1_arburst[1:0],saxigp1_arlock,saxigp1_arcache[3:0],saxigp1_arprot[2:0],saxigp1_arvalid,saxigp1_arready,saxigp1_rid[5:0],saxigp1_rdata[127:0],saxigp1_rresp[1:0],saxigp1_rlast,saxigp1_rvalid,saxigp1_rready,saxigp1_awqos[3:0],saxigp1_arqos[3:0],saxi_lpd_aclk,saxigp6_aruser,saxigp6_awuser,saxigp6_awid[5:0],saxigp6_awaddr[48:0],saxigp6_awlen[7:0],saxigp6_awsize[2:0],saxigp6_awburst[1:0],saxigp6_awlock,saxigp6_awcache[3:0],saxigp6_awprot[2:0],saxigp6_awvalid,saxigp6_awready,saxigp6_wdata[31:0],saxigp6_wstrb[3:0],saxigp6_wlast,saxigp6_wvalid,saxigp6_wready,saxigp6_bid[5:0],saxigp6_bresp[1:0],saxigp6_bvalid,saxigp6_bready,saxigp6_arid[5:0],saxigp6_araddr[48:0],saxigp6_arlen[7:0],saxigp6_arsize[2:0],saxigp6_arburst[1:0],saxigp6_arlock,saxigp6_arcache[3:0],saxigp6_arprot[2:0],saxigp6_arvalid,saxigp6_arready,saxigp6_rid[5:0],saxigp6_rdata[31:0],saxigp6_rresp[1:0],saxigp6_rlast,saxigp6_rvalid,saxigp6_rready,saxigp6_awqos[3:0],saxigp6_arqos[3:0],pl_ps_irq0[2:0],pl_resetn0,pl_clk0";
attribute X_CORE_INFO : string;
attribute X_CORE_INFO of stub : architecture is "zynq_ultra_ps_e_v3_3_5_zynq_ultra_ps_e,Vivado 2021.1";
begin
end;
