Tai-Min/KV260-Human-Detector/hardware/hardware.gen/sources_1/bd/hardware/synth/hardware.v

//Copyright 1986-2021 Xilinx, Inc. All Rights Reserved.
//--------------------------------------------------------------------------------
//Tool Version: Vivado v.2021.1 (lin64) Build 3247384 Thu Jun 10 19:36:07 MDT 2021
//Date        : Tue Mar 22 19:39:31 2022
//Host        : PC running 64-bit Ubuntu 20.04.4 LTS
//Command     : generate_target hardware.bd
//Design      : hardware
//Purpose     : IP block netlist
//--------------------------------------------------------------------------------
`timescale 1 ps / 1 ps

(* CORE_GENERATION_INFO = "hardware,IP_Integrator,{x_ipVendor=xilinx.com,x_ipLibrary=BlockDiagram,x_ipName=hardware,x_ipVersion=1.00.a,x_ipLanguage=VERILOG,numBlks=32,numReposBlks=24,numNonXlnxBlks=0,numHierBlks=8,maxHierDepth=0,numSysgenBlks=0,numHlsBlks=0,numHdlrefBlks=5,numPkgbdBlks=0,bdsource=USER,da_sys_mgmt_wiz_cnt=1,da_zynq_ultra_ps_e_cnt=1,synth_mode=OOC_per_IP}" *) (* HW_HANDOFF = "hardware.hwdef" *) 
module hardware
   (dir,
    ena,
    fan,
    step,
    stop1,
    stop2);
  output dir;
  output ena;
  output fan;
  output step;
  input stop1;
  input stop2;

  wire [39:0]DPUCZDX8G_0_DPU0_M_AXI_DATA0_ARADDR;
  wire [1:0]DPUCZDX8G_0_DPU0_M_AXI_DATA0_ARBURST;
  wire [3:0]DPUCZDX8G_0_DPU0_M_AXI_DATA0_ARCACHE;
  wire [1:0]DPUCZDX8G_0_DPU0_M_AXI_DATA0_ARID;
  wire [7:0]DPUCZDX8G_0_DPU0_M_AXI_DATA0_ARLEN;
  wire [0:0]DPUCZDX8G_0_DPU0_M_AXI_DATA0_ARLOCK;
  wire [2:0]DPUCZDX8G_0_DPU0_M_AXI_DATA0_ARPROT;
  wire [3:0]DPUCZDX8G_0_DPU0_M_AXI_DATA0_ARQOS;
  wire DPUCZDX8G_0_DPU0_M_AXI_DATA0_ARREADY;
  wire [2:0]DPUCZDX8G_0_DPU0_M_AXI_DATA0_ARSIZE;
  wire [0:0]DPUCZDX8G_0_DPU0_M_AXI_DATA0_ARUSER;
  wire DPUCZDX8G_0_DPU0_M_AXI_DATA0_ARVALID;
  wire [39:0]DPUCZDX8G_0_DPU0_M_AXI_DATA0_AWADDR;
  wire [1:0]DPUCZDX8G_0_DPU0_M_AXI_DATA0_AWBURST;
  wire [3:0]DPUCZDX8G_0_DPU0_M_AXI_DATA0_AWCACHE;
  wire [1:0]DPUCZDX8G_0_DPU0_M_AXI_DATA0_AWID;
  wire [7:0]DPUCZDX8G_0_DPU0_M_AXI_DATA0_AWLEN;
  wire [0:0]DPUCZDX8G_0_DPU0_M_AXI_DATA0_AWLOCK;
  wire [2:0]DPUCZDX8G_0_DPU0_M_AXI_DATA0_AWPROT;
  wire [3:0]DPUCZDX8G_0_DPU0_M_AXI_DATA0_AWQOS;
  wire DPUCZDX8G_0_DPU0_M_AXI_DATA0_AWREADY;
  wire [2:0]DPUCZDX8G_0_DPU0_M_AXI_DATA0_AWSIZE;
  wire [0:0]DPUCZDX8G_0_DPU0_M_AXI_DATA0_AWUSER;
  wire DPUCZDX8G_0_DPU0_M_AXI_DATA0_AWVALID;
  wire [5:0]DPUCZDX8G_0_DPU0_M_AXI_DATA0_BID;
  wire DPUCZDX8G_0_DPU0_M_AXI_DATA0_BREADY;
  wire [1:0]DPUCZDX8G_0_DPU0_M_AXI_DATA0_BRESP;
  wire DPUCZDX8G_0_DPU0_M_AXI_DATA0_BVALID;
  wire [127:0]DPUCZDX8G_0_DPU0_M_AXI_DATA0_RDATA;
  wire [5:0]DPUCZDX8G_0_DPU0_M_AXI_DATA0_RID;
  wire DPUCZDX8G_0_DPU0_M_AXI_DATA0_RLAST;
  wire DPUCZDX8G_0_DPU0_M_AXI_DATA0_RREADY;
  wire [1:0]DPUCZDX8G_0_DPU0_M_AXI_DATA0_RRESP;
  wire DPUCZDX8G_0_DPU0_M_AXI_DATA0_RVALID;
  wire [127:0]DPUCZDX8G_0_DPU0_M_AXI_DATA0_WDATA;
  wire DPUCZDX8G_0_DPU0_M_AXI_DATA0_WLAST;
  wire DPUCZDX8G_0_DPU0_M_AXI_DATA0_WREADY;
  wire [15:0]DPUCZDX8G_0_DPU0_M_AXI_DATA0_WSTRB;
  wire DPUCZDX8G_0_DPU0_M_AXI_DATA0_WVALID;
  wire [39:0]DPUCZDX8G_0_DPU0_M_AXI_DATA1_ARADDR;
  wire [1:0]DPUCZDX8G_0_DPU0_M_AXI_DATA1_ARBURST;
  wire [3:0]DPUCZDX8G_0_DPU0_M_AXI_DATA1_ARCACHE;
  wire [1:0]DPUCZDX8G_0_DPU0_M_AXI_DATA1_ARID;
  wire [7:0]DPUCZDX8G_0_DPU0_M_AXI_DATA1_ARLEN;
  wire [0:0]DPUCZDX8G_0_DPU0_M_AXI_DATA1_ARLOCK;
  wire [2:0]DPUCZDX8G_0_DPU0_M_AXI_DATA1_ARPROT;
  wire [3:0]DPUCZDX8G_0_DPU0_M_AXI_DATA1_ARQOS;
  wire DPUCZDX8G_0_DPU0_M_AXI_DATA1_ARREADY;
  wire [2:0]DPUCZDX8G_0_DPU0_M_AXI_DATA1_ARSIZE;
  wire [0:0]DPUCZDX8G_0_DPU0_M_AXI_DATA1_ARUSER;
  wire DPUCZDX8G_0_DPU0_M_AXI_DATA1_ARVALID;
  wire [39:0]DPUCZDX8G_0_DPU0_M_AXI_DATA1_AWADDR;
  wire [1:0]DPUCZDX8G_0_DPU0_M_AXI_DATA1_AWBURST;
  wire [3:0]DPUCZDX8G_0_DPU0_M_AXI_DATA1_AWCACHE;
  wire [1:0]DPUCZDX8G_0_DPU0_M_AXI_DATA1_AWID;
  wire [7:0]DPUCZDX8G_0_DPU0_M_AXI_DATA1_AWLEN;
  wire [0:0]DPUCZDX8G_0_DPU0_M_AXI_DATA1_AWLOCK;
  wire [2:0]DPUCZDX8G_0_DPU0_M_AXI_DATA1_AWPROT;
  wire [3:0]DPUCZDX8G_0_DPU0_M_AXI_DATA1_AWQOS;
  wire DPUCZDX8G_0_DPU0_M_AXI_DATA1_AWREADY;
  wire [2:0]DPUCZDX8G_0_DPU0_M_AXI_DATA1_AWSIZE;
  wire [0:0]DPUCZDX8G_0_DPU0_M_AXI_DATA1_AWUSER;
  wire DPUCZDX8G_0_DPU0_M_AXI_DATA1_AWVALID;
  wire [5:0]DPUCZDX8G_0_DPU0_M_AXI_DATA1_BID;
  wire DPUCZDX8G_0_DPU0_M_AXI_DATA1_BREADY;
  wire [1:0]DPUCZDX8G_0_DPU0_M_AXI_DATA1_BRESP;
  wire DPUCZDX8G_0_DPU0_M_AXI_DATA1_BVALID;
  wire [127:0]DPUCZDX8G_0_DPU0_M_AXI_DATA1_RDATA;
  wire [5:0]DPUCZDX8G_0_DPU0_M_AXI_DATA1_RID;
  wire DPUCZDX8G_0_DPU0_M_AXI_DATA1_RLAST;
  wire DPUCZDX8G_0_DPU0_M_AXI_DATA1_RREADY;
  wire [1:0]DPUCZDX8G_0_DPU0_M_AXI_DATA1_RRESP;
  wire DPUCZDX8G_0_DPU0_M_AXI_DATA1_RVALID;
  wire [127:0]DPUCZDX8G_0_DPU0_M_AXI_DATA1_WDATA;
  wire DPUCZDX8G_0_DPU0_M_AXI_DATA1_WLAST;
  wire DPUCZDX8G_0_DPU0_M_AXI_DATA1_WREADY;
  wire [15:0]DPUCZDX8G_0_DPU0_M_AXI_DATA1_WSTRB;
  wire DPUCZDX8G_0_DPU0_M_AXI_DATA1_WVALID;
  wire [39:0]DPUCZDX8G_0_DPU0_M_AXI_INSTR_ARADDR;
  wire [1:0]DPUCZDX8G_0_DPU0_M_AXI_INSTR_ARBURST;
  wire [3:0]DPUCZDX8G_0_DPU0_M_AXI_INSTR_ARCACHE;
  wire [1:0]DPUCZDX8G_0_DPU0_M_AXI_INSTR_ARID;
  wire [7:0]DPUCZDX8G_0_DPU0_M_AXI_INSTR_ARLEN;
  wire [0:0]DPUCZDX8G_0_DPU0_M_AXI_INSTR_ARLOCK;
  wire [2:0]DPUCZDX8G_0_DPU0_M_AXI_INSTR_ARPROT;
  wire [3:0]DPUCZDX8G_0_DPU0_M_AXI_INSTR_ARQOS;
  wire DPUCZDX8G_0_DPU0_M_AXI_INSTR_ARREADY;
  wire [2:0]DPUCZDX8G_0_DPU0_M_AXI_INSTR_ARSIZE;
  wire [0:0]DPUCZDX8G_0_DPU0_M_AXI_INSTR_ARUSER;
  wire DPUCZDX8G_0_DPU0_M_AXI_INSTR_ARVALID;
  wire [39:0]DPUCZDX8G_0_DPU0_M_AXI_INSTR_AWADDR;
  wire [1:0]DPUCZDX8G_0_DPU0_M_AXI_INSTR_AWBURST;
  wire [3:0]DPUCZDX8G_0_DPU0_M_AXI_INSTR_AWCACHE;
  wire [1:0]DPUCZDX8G_0_DPU0_M_AXI_INSTR_AWID;
  wire [7:0]DPUCZDX8G_0_DPU0_M_AXI_INSTR_AWLEN;
  wire [0:0]DPUCZDX8G_0_DPU0_M_AXI_INSTR_AWLOCK;
  wire [2:0]DPUCZDX8G_0_DPU0_M_AXI_INSTR_AWPROT;
  wire [3:0]DPUCZDX8G_0_DPU0_M_AXI_INSTR_AWQOS;
  wire DPUCZDX8G_0_DPU0_M_AXI_INSTR_AWREADY;
  wire [2:0]DPUCZDX8G_0_DPU0_M_AXI_INSTR_AWSIZE;
  wire [0:0]DPUCZDX8G_0_DPU0_M_AXI_INSTR_AWUSER;
  wire DPUCZDX8G_0_DPU0_M_AXI_INSTR_AWVALID;
  wire [5:0]DPUCZDX8G_0_DPU0_M_AXI_INSTR_BID;
  wire DPUCZDX8G_0_DPU0_M_AXI_INSTR_BREADY;
  wire [1:0]DPUCZDX8G_0_DPU0_M_AXI_INSTR_BRESP;
  wire DPUCZDX8G_0_DPU0_M_AXI_INSTR_BVALID;
  wire [31:0]DPUCZDX8G_0_DPU0_M_AXI_INSTR_RDATA;
  wire [5:0]DPUCZDX8G_0_DPU0_M_AXI_INSTR_RID;
  wire DPUCZDX8G_0_DPU0_M_AXI_INSTR_RLAST;
  wire DPUCZDX8G_0_DPU0_M_AXI_INSTR_RREADY;
  wire [1:0]DPUCZDX8G_0_DPU0_M_AXI_INSTR_RRESP;
  wire DPUCZDX8G_0_DPU0_M_AXI_INSTR_RVALID;
  wire [31:0]DPUCZDX8G_0_DPU0_M_AXI_INSTR_WDATA;
  wire DPUCZDX8G_0_DPU0_M_AXI_INSTR_WLAST;
  wire DPUCZDX8G_0_DPU0_M_AXI_INSTR_WREADY;
  wire [3:0]DPUCZDX8G_0_DPU0_M_AXI_INSTR_WSTRB;
  wire DPUCZDX8G_0_DPU0_M_AXI_INSTR_WVALID;
  wire [0:0]DPUCZDX8G_0_dpu_interrupt;
  wire [12:0]axi_gpio_gpio_io_o;
  wire axi_intc_irq;
  wire [39:0]axi_interconnect_0_M00_AXI_ARADDR;
  wire [1:0]axi_interconnect_0_M00_AXI_ARBURST;
  wire [3:0]axi_interconnect_0_M00_AXI_ARCACHE;
  wire [15:0]axi_interconnect_0_M00_AXI_ARID;
  wire [7:0]axi_interconnect_0_M00_AXI_ARLEN;
  wire [0:0]axi_interconnect_0_M00_AXI_ARLOCK;
  wire [2:0]axi_interconnect_0_M00_AXI_ARPROT;
  wire [3:0]axi_interconnect_0_M00_AXI_ARQOS;
  wire [0:0]axi_interconnect_0_M00_AXI_ARREADY;
  wire [2:0]axi_interconnect_0_M00_AXI_ARSIZE;
  wire [15:0]axi_interconnect_0_M00_AXI_ARUSER;
  wire [0:0]axi_interconnect_0_M00_AXI_ARVALID;
  wire [39:0]axi_interconnect_0_M00_AXI_AWADDR;
  wire [1:0]axi_interconnect_0_M00_AXI_AWBURST;
  wire [3:0]axi_interconnect_0_M00_AXI_AWCACHE;
  wire [15:0]axi_interconnect_0_M00_AXI_AWID;
  wire [7:0]axi_interconnect_0_M00_AXI_AWLEN;
  wire [0:0]axi_interconnect_0_M00_AXI_AWLOCK;
  wire [2:0]axi_interconnect_0_M00_AXI_AWPROT;
  wire [3:0]axi_interconnect_0_M00_AXI_AWQOS;
  wire [0:0]axi_interconnect_0_M00_AXI_AWREADY;
  wire [2:0]axi_interconnect_0_M00_AXI_AWSIZE;
  wire [15:0]axi_interconnect_0_M00_AXI_AWUSER;
  wire [0:0]axi_interconnect_0_M00_AXI_AWVALID;
  wire [15:0]axi_interconnect_0_M00_AXI_BID;
  wire [0:0]axi_interconnect_0_M00_AXI_BREADY;
  wire [1:0]axi_interconnect_0_M00_AXI_BRESP;
  wire [0:0]axi_interconnect_0_M00_AXI_BVALID;
  wire [31:0]axi_interconnect_0_M00_AXI_RDATA;
  wire [15:0]axi_interconnect_0_M00_AXI_RID;
  wire [0:0]axi_interconnect_0_M00_AXI_RLAST;
  wire [0:0]axi_interconnect_0_M00_AXI_RREADY;
  wire [1:0]axi_interconnect_0_M00_AXI_RRESP;
  wire [0:0]axi_interconnect_0_M00_AXI_RVALID;
  wire [31:0]axi_interconnect_0_M00_AXI_WDATA;
  wire [0:0]axi_interconnect_0_M00_AXI_WLAST;
  wire [0:0]axi_interconnect_0_M00_AXI_WREADY;
  wire [3:0]axi_interconnect_0_M00_AXI_WSTRB;
  wire [0:0]axi_interconnect_0_M00_AXI_WVALID;
  wire [39:0]axi_interconnect_1_M00_AXI_ARADDR;
  wire axi_interconnect_1_M00_AXI_ARREADY;
  wire axi_interconnect_1_M00_AXI_ARVALID;
  wire [39:0]axi_interconnect_1_M00_AXI_AWADDR;
  wire axi_interconnect_1_M00_AXI_AWREADY;
  wire axi_interconnect_1_M00_AXI_AWVALID;
  wire axi_interconnect_1_M00_AXI_BREADY;
  wire [1:0]axi_interconnect_1_M00_AXI_BRESP;
  wire axi_interconnect_1_M00_AXI_BVALID;
  wire [31:0]axi_interconnect_1_M00_AXI_RDATA;
  wire axi_interconnect_1_M00_AXI_RREADY;
  wire [1:0]axi_interconnect_1_M00_AXI_RRESP;
  wire axi_interconnect_1_M00_AXI_RVALID;
  wire [31:0]axi_interconnect_1_M00_AXI_WDATA;
  wire axi_interconnect_1_M00_AXI_WREADY;
  wire [3:0]axi_interconnect_1_M00_AXI_WSTRB;
  wire axi_interconnect_1_M00_AXI_WVALID;
  wire [39:0]axi_interconnect_1_M01_AXI_ARADDR;
  wire [1:0]axi_interconnect_1_M01_AXI_ARBURST;
  wire [3:0]axi_interconnect_1_M01_AXI_ARCACHE;
  wire [7:0]axi_interconnect_1_M01_AXI_ARLEN;
  wire [0:0]axi_interconnect_1_M01_AXI_ARLOCK;
  wire [2:0]axi_interconnect_1_M01_AXI_ARPROT;
  wire [3:0]axi_interconnect_1_M01_AXI_ARQOS;
  wire axi_interconnect_1_M01_AXI_ARREADY;
  wire [3:0]axi_interconnect_1_M01_AXI_ARREGION;
  wire [2:0]axi_interconnect_1_M01_AXI_ARSIZE;
  wire [15:0]axi_interconnect_1_M01_AXI_ARUSER;
  wire axi_interconnect_1_M01_AXI_ARVALID;
  wire [39:0]axi_interconnect_1_M01_AXI_AWADDR;
  wire [1:0]axi_interconnect_1_M01_AXI_AWBURST;
  wire [3:0]axi_interconnect_1_M01_AXI_AWCACHE;
  wire [7:0]axi_interconnect_1_M01_AXI_AWLEN;
  wire [0:0]axi_interconnect_1_M01_AXI_AWLOCK;
  wire [2:0]axi_interconnect_1_M01_AXI_AWPROT;
  wire [3:0]axi_interconnect_1_M01_AXI_AWQOS;
  wire axi_interconnect_1_M01_AXI_AWREADY;
  wire [3:0]axi_interconnect_1_M01_AXI_AWREGION;
  wire [2:0]axi_interconnect_1_M01_AXI_AWSIZE;
  wire [15:0]axi_interconnect_1_M01_AXI_AWUSER;
  wire axi_interconnect_1_M01_AXI_AWVALID;
  wire axi_interconnect_1_M01_AXI_BREADY;
  wire [1:0]axi_interconnect_1_M01_AXI_BRESP;
  wire axi_interconnect_1_M01_AXI_BVALID;
  wire [31:0]axi_interconnect_1_M01_AXI_RDATA;
  wire axi_interconnect_1_M01_AXI_RLAST;
  wire axi_interconnect_1_M01_AXI_RREADY;
  wire [1:0]axi_interconnect_1_M01_AXI_RRESP;
  wire axi_interconnect_1_M01_AXI_RVALID;
  wire [31:0]axi_interconnect_1_M01_AXI_WDATA;
  wire axi_interconnect_1_M01_AXI_WLAST;
  wire axi_interconnect_1_M01_AXI_WREADY;
  wire [3:0]axi_interconnect_1_M01_AXI_WSTRB;
  wire axi_interconnect_1_M01_AXI_WVALID;
  wire [12:0]axi_interconnect_1_M02_AXI_ARADDR;
  wire axi_interconnect_1_M02_AXI_ARREADY;
  wire axi_interconnect_1_M02_AXI_ARVALID;
  wire [12:0]axi_interconnect_1_M02_AXI_AWADDR;
  wire axi_interconnect_1_M02_AXI_AWREADY;
  wire axi_interconnect_1_M02_AXI_AWVALID;
  wire axi_interconnect_1_M02_AXI_BREADY;
  wire [1:0]axi_interconnect_1_M02_AXI_BRESP;
  wire axi_interconnect_1_M02_AXI_BVALID;
  wire [31:0]axi_interconnect_1_M02_AXI_RDATA;
  wire axi_interconnect_1_M02_AXI_RREADY;
  wire [1:0]axi_interconnect_1_M02_AXI_RRESP;
  wire axi_interconnect_1_M02_AXI_RVALID;
  wire [31:0]axi_interconnect_1_M02_AXI_WDATA;
  wire axi_interconnect_1_M02_AXI_WREADY;
  wire [3:0]axi_interconnect_1_M02_AXI_WSTRB;
  wire axi_interconnect_1_M02_AXI_WVALID;
  wire [39:0]axi_interconnect_1_M03_AXI_ARADDR;
  wire axi_interconnect_1_M03_AXI_ARREADY;
  wire axi_interconnect_1_M03_AXI_ARVALID;
  wire [39:0]axi_interconnect_1_M03_AXI_AWADDR;
  wire axi_interconnect_1_M03_AXI_AWREADY;
  wire axi_interconnect_1_M03_AXI_AWVALID;
  wire axi_interconnect_1_M03_AXI_BREADY;
  wire [1:0]axi_interconnect_1_M03_AXI_BRESP;
  wire axi_interconnect_1_M03_AXI_BVALID;
  wire [31:0]axi_interconnect_1_M03_AXI_RDATA;
  wire axi_interconnect_1_M03_AXI_RREADY;
  wire [1:0]axi_interconnect_1_M03_AXI_RRESP;
  wire axi_interconnect_1_M03_AXI_RVALID;
  wire [31:0]axi_interconnect_1_M03_AXI_WDATA;
  wire axi_interconnect_1_M03_AXI_WREADY;
  wire [3:0]axi_interconnect_1_M03_AXI_WSTRB;
  wire axi_interconnect_1_M03_AXI_WVALID;
  wire clk_wiz_0_dpu;
  wire clk_wiz_1_locked;
  wire clk_wiz_clk_out2;
  wire clk_wiz_clk_out3;
  wire clk_wiz_locked;
  wire [10:0]cmd_bits_Dout;
  wire div_stepper_clk_out;
  wire divider_0_clk_out;
  wire [0:0]dpu_reset_peripheral_aresetn;
  wire [0:0]ena_bit_Dout;
  wire [0:0]latch_bit_Dout;
  wire [0:0]proc_sys_reset_2_peripheral_aresetn;
  wire [0:0]proc_sys_reset_3_peripheral_aresetn;
  wire pwm_0_state;
  wire stepper_ctrl_busy;
  wire stepper_ctrl_dir;
  wire stepper_ctrl_ena;
  wire stepper_ctrl_step;
  wire stop1_1;
  wire stop2_1;
  wire system_management_wiz_0_eos_out;
  wire [9:0]system_management_wiz_0_temp_out;
  wire system_management_wiz_ip2intc_irpt;
  wire [7:0]temp2pwm_0_pwm;
  wire [2:0]xlconcat_0_dout;
  wire [2:0]xlconcat_3_dout;
  wire [39:0]zynq_ultra_ps_M_AXI_HPM0_LPD_ARADDR;
  wire [1:0]zynq_ultra_ps_M_AXI_HPM0_LPD_ARBURST;
  wire [3:0]zynq_ultra_ps_M_AXI_HPM0_LPD_ARCACHE;
  wire [15:0]zynq_ultra_ps_M_AXI_HPM0_LPD_ARID;
  wire [7:0]zynq_ultra_ps_M_AXI_HPM0_LPD_ARLEN;
  wire zynq_ultra_ps_M_AXI_HPM0_LPD_ARLOCK;
  wire [2:0]zynq_ultra_ps_M_AXI_HPM0_LPD_ARPROT;
  wire [3:0]zynq_ultra_ps_M_AXI_HPM0_LPD_ARQOS;
  wire [0:0]zynq_ultra_ps_M_AXI_HPM0_LPD_ARREADY;
  wire [2:0]zynq_ultra_ps_M_AXI_HPM0_LPD_ARSIZE;
  wire [15:0]zynq_ultra_ps_M_AXI_HPM0_LPD_ARUSER;
  wire zynq_ultra_ps_M_AXI_HPM0_LPD_ARVALID;
  wire [39:0]zynq_ultra_ps_M_AXI_HPM0_LPD_AWADDR;
  wire [1:0]zynq_ultra_ps_M_AXI_HPM0_LPD_AWBURST;
  wire [3:0]zynq_ultra_ps_M_AXI_HPM0_LPD_AWCACHE;
  wire [15:0]zynq_ultra_ps_M_AXI_HPM0_LPD_AWID;
  wire [7:0]zynq_ultra_ps_M_AXI_HPM0_LPD_AWLEN;
  wire zynq_ultra_ps_M_AXI_HPM0_LPD_AWLOCK;
  wire [2:0]zynq_ultra_ps_M_AXI_HPM0_LPD_AWPROT;
  wire [3:0]zynq_ultra_ps_M_AXI_HPM0_LPD_AWQOS;
  wire [0:0]zynq_ultra_ps_M_AXI_HPM0_LPD_AWREADY;
  wire [2:0]zynq_ultra_ps_M_AXI_HPM0_LPD_AWSIZE;
  wire [15:0]zynq_ultra_ps_M_AXI_HPM0_LPD_AWUSER;
  wire zynq_ultra_ps_M_AXI_HPM0_LPD_AWVALID;
  wire [15:0]zynq_ultra_ps_M_AXI_HPM0_LPD_BID;
  wire zynq_ultra_ps_M_AXI_HPM0_LPD_BREADY;
  wire [1:0]zynq_ultra_ps_M_AXI_HPM0_LPD_BRESP;
  wire [0:0]zynq_ultra_ps_M_AXI_HPM0_LPD_BVALID;
  wire [31:0]zynq_ultra_ps_M_AXI_HPM0_LPD_RDATA;
  wire [15:0]zynq_ultra_ps_M_AXI_HPM0_LPD_RID;
  wire [0:0]zynq_ultra_ps_M_AXI_HPM0_LPD_RLAST;
  wire zynq_ultra_ps_M_AXI_HPM0_LPD_RREADY;
  wire [1:0]zynq_ultra_ps_M_AXI_HPM0_LPD_RRESP;
  wire [0:0]zynq_ultra_ps_M_AXI_HPM0_LPD_RVALID;
  wire [31:0]zynq_ultra_ps_M_AXI_HPM0_LPD_WDATA;
  wire zynq_ultra_ps_M_AXI_HPM0_LPD_WLAST;
  wire [0:0]zynq_ultra_ps_M_AXI_HPM0_LPD_WREADY;
  wire [3:0]zynq_ultra_ps_M_AXI_HPM0_LPD_WSTRB;
  wire zynq_ultra_ps_M_AXI_HPM0_LPD_WVALID;
  wire zynq_ultra_ps_pl_clk0;
  wire zynq_ultra_ps_pl_resetn0;

  assign dir = stepper_ctrl_dir;
  assign ena = stepper_ctrl_ena;
  assign fan = pwm_0_state;
  assign step = stepper_ctrl_step;
  assign stop1_1 = stop1;
  assign stop2_1 = stop2;
  hardware_DPUCZDX8G_0_1 DPUCZDX8G_0
       (.dpu0_m_axi_data0_araddr(DPUCZDX8G_0_DPU0_M_AXI_DATA0_ARADDR),
        .dpu0_m_axi_data0_arburst(DPUCZDX8G_0_DPU0_M_AXI_DATA0_ARBURST),
        .dpu0_m_axi_data0_arcache(DPUCZDX8G_0_DPU0_M_AXI_DATA0_ARCACHE),
        .dpu0_m_axi_data0_arid(DPUCZDX8G_0_DPU0_M_AXI_DATA0_ARID),
        .dpu0_m_axi_data0_arlen(DPUCZDX8G_0_DPU0_M_AXI_DATA0_ARLEN),
        .dpu0_m_axi_data0_arlock(DPUCZDX8G_0_DPU0_M_AXI_DATA0_ARLOCK),
        .dpu0_m_axi_data0_arprot(DPUCZDX8G_0_DPU0_M_AXI_DATA0_ARPROT),
        .dpu0_m_axi_data0_arqos(DPUCZDX8G_0_DPU0_M_AXI_DATA0_ARQOS),
        .dpu0_m_axi_data0_arready(DPUCZDX8G_0_DPU0_M_AXI_DATA0_ARREADY),
        .dpu0_m_axi_data0_arsize(DPUCZDX8G_0_DPU0_M_AXI_DATA0_ARSIZE),
        .dpu0_m_axi_data0_aruser(DPUCZDX8G_0_DPU0_M_AXI_DATA0_ARUSER),
        .dpu0_m_axi_data0_arvalid(DPUCZDX8G_0_DPU0_M_AXI_DATA0_ARVALID),
        .dpu0_m_axi_data0_awaddr(DPUCZDX8G_0_DPU0_M_AXI_DATA0_AWADDR),
        .dpu0_m_axi_data0_awburst(DPUCZDX8G_0_DPU0_M_AXI_DATA0_AWBURST),
        .dpu0_m_axi_data0_awcache(DPUCZDX8G_0_DPU0_M_AXI_DATA0_AWCACHE),
        .dpu0_m_axi_data0_awid(DPUCZDX8G_0_DPU0_M_AXI_DATA0_AWID),
        .dpu0_m_axi_data0_awlen(DPUCZDX8G_0_DPU0_M_AXI_DATA0_AWLEN),
        .dpu0_m_axi_data0_awlock(DPUCZDX8G_0_DPU0_M_AXI_DATA0_AWLOCK),
        .dpu0_m_axi_data0_awprot(DPUCZDX8G_0_DPU0_M_AXI_DATA0_AWPROT),
        .dpu0_m_axi_data0_awqos(DPUCZDX8G_0_DPU0_M_AXI_DATA0_AWQOS),
        .dpu0_m_axi_data0_awready(DPUCZDX8G_0_DPU0_M_AXI_DATA0_AWREADY),
        .dpu0_m_axi_data0_awsize(DPUCZDX8G_0_DPU0_M_AXI_DATA0_AWSIZE),
        .dpu0_m_axi_data0_awuser(DPUCZDX8G_0_DPU0_M_AXI_DATA0_AWUSER),
        .dpu0_m_axi_data0_awvalid(DPUCZDX8G_0_DPU0_M_AXI_DATA0_AWVALID),
        .dpu0_m_axi_data0_bid(DPUCZDX8G_0_DPU0_M_AXI_DATA0_BID),
        .dpu0_m_axi_data0_bready(DPUCZDX8G_0_DPU0_M_AXI_DATA0_BREADY),
        .dpu0_m_axi_data0_bresp(DPUCZDX8G_0_DPU0_M_AXI_DATA0_BRESP),
        .dpu0_m_axi_data0_bvalid(DPUCZDX8G_0_DPU0_M_AXI_DATA0_BVALID),
        .dpu0_m_axi_data0_rdata(DPUCZDX8G_0_DPU0_M_AXI_DATA0_RDATA),
        .dpu0_m_axi_data0_rid(DPUCZDX8G_0_DPU0_M_AXI_DATA0_RID),
        .dpu0_m_axi_data0_rlast(DPUCZDX8G_0_DPU0_M_AXI_DATA0_RLAST),
        .dpu0_m_axi_data0_rready(DPUCZDX8G_0_DPU0_M_AXI_DATA0_RREADY),
        .dpu0_m_axi_data0_rresp(DPUCZDX8G_0_DPU0_M_AXI_DATA0_RRESP),
        .dpu0_m_axi_data0_rvalid(DPUCZDX8G_0_DPU0_M_AXI_DATA0_RVALID),
        .dpu0_m_axi_data0_wdata(DPUCZDX8G_0_DPU0_M_AXI_DATA0_WDATA),
        .dpu0_m_axi_data0_wlast(DPUCZDX8G_0_DPU0_M_AXI_DATA0_WLAST),
        .dpu0_m_axi_data0_wready(DPUCZDX8G_0_DPU0_M_AXI_DATA0_WREADY),
        .dpu0_m_axi_data0_wstrb(DPUCZDX8G_0_DPU0_M_AXI_DATA0_WSTRB),
        .dpu0_m_axi_data0_wvalid(DPUCZDX8G_0_DPU0_M_AXI_DATA0_WVALID),
        .dpu0_m_axi_data1_araddr(DPUCZDX8G_0_DPU0_M_AXI_DATA1_ARADDR),
        .dpu0_m_axi_data1_arburst(DPUCZDX8G_0_DPU0_M_AXI_DATA1_ARBURST),
        .dpu0_m_axi_data1_arcache(DPUCZDX8G_0_DPU0_M_AXI_DATA1_ARCACHE),
        .dpu0_m_axi_data1_arid(DPUCZDX8G_0_DPU0_M_AXI_DATA1_ARID),
        .dpu0_m_axi_data1_arlen(DPUCZDX8G_0_DPU0_M_AXI_DATA1_ARLEN),
        .dpu0_m_axi_data1_arlock(DPUCZDX8G_0_DPU0_M_AXI_DATA1_ARLOCK),
        .dpu0_m_axi_data1_arprot(DPUCZDX8G_0_DPU0_M_AXI_DATA1_ARPROT),
        .dpu0_m_axi_data1_arqos(DPUCZDX8G_0_DPU0_M_AXI_DATA1_ARQOS),
        .dpu0_m_axi_data1_arready(DPUCZDX8G_0_DPU0_M_AXI_DATA1_ARREADY),
        .dpu0_m_axi_data1_arsize(DPUCZDX8G_0_DPU0_M_AXI_DATA1_ARSIZE),
        .dpu0_m_axi_data1_aruser(DPUCZDX8G_0_DPU0_M_AXI_DATA1_ARUSER),
        .dpu0_m_axi_data1_arvalid(DPUCZDX8G_0_DPU0_M_AXI_DATA1_ARVALID),
        .dpu0_m_axi_data1_awaddr(DPUCZDX8G_0_DPU0_M_AXI_DATA1_AWADDR),
        .dpu0_m_axi_data1_awburst(DPUCZDX8G_0_DPU0_M_AXI_DATA1_AWBURST),
        .dpu0_m_axi_data1_awcache(DPUCZDX8G_0_DPU0_M_AXI_DATA1_AWCACHE),
        .dpu0_m_axi_data1_awid(DPUCZDX8G_0_DPU0_M_AXI_DATA1_AWID),
        .dpu0_m_axi_data1_awlen(DPUCZDX8G_0_DPU0_M_AXI_DATA1_AWLEN),
        .dpu0_m_axi_data1_awlock(DPUCZDX8G_0_DPU0_M_AXI_DATA1_AWLOCK),
        .dpu0_m_axi_data1_awprot(DPUCZDX8G_0_DPU0_M_AXI_DATA1_AWPROT),
        .dpu0_m_axi_data1_awqos(DPUCZDX8G_0_DPU0_M_AXI_DATA1_AWQOS),
        .dpu0_m_axi_data1_awready(DPUCZDX8G_0_DPU0_M_AXI_DATA1_AWREADY),
        .dpu0_m_axi_data1_awsize(DPUCZDX8G_0_DPU0_M_AXI_DATA1_AWSIZE),
        .dpu0_m_axi_data1_awuser(DPUCZDX8G_0_DPU0_M_AXI_DATA1_AWUSER),
        .dpu0_m_axi_data1_awvalid(DPUCZDX8G_0_DPU0_M_AXI_DATA1_AWVALID),
        .dpu0_m_axi_data1_bid(DPUCZDX8G_0_DPU0_M_AXI_DATA1_BID),
        .dpu0_m_axi_data1_bready(DPUCZDX8G_0_DPU0_M_AXI_DATA1_BREADY),
        .dpu0_m_axi_data1_bresp(DPUCZDX8G_0_DPU0_M_AXI_DATA1_BRESP),
        .dpu0_m_axi_data1_bvalid(DPUCZDX8G_0_DPU0_M_AXI_DATA1_BVALID),
        .dpu0_m_axi_data1_rdata(DPUCZDX8G_0_DPU0_M_AXI_DATA1_RDATA),
        .dpu0_m_axi_data1_rid(DPUCZDX8G_0_DPU0_M_AXI_DATA1_RID),
        .dpu0_m_axi_data1_rlast(DPUCZDX8G_0_DPU0_M_AXI_DATA1_RLAST),
        .dpu0_m_axi_data1_rready(DPUCZDX8G_0_DPU0_M_AXI_DATA1_RREADY),
        .dpu0_m_axi_data1_rresp(DPUCZDX8G_0_DPU0_M_AXI_DATA1_RRESP),
        .dpu0_m_axi_data1_rvalid(DPUCZDX8G_0_DPU0_M_AXI_DATA1_RVALID),
        .dpu0_m_axi_data1_wdata(DPUCZDX8G_0_DPU0_M_AXI_DATA1_WDATA),
        .dpu0_m_axi_data1_wlast(DPUCZDX8G_0_DPU0_M_AXI_DATA1_WLAST),
        .dpu0_m_axi_data1_wready(DPUCZDX8G_0_DPU0_M_AXI_DATA1_WREADY),
        .dpu0_m_axi_data1_wstrb(DPUCZDX8G_0_DPU0_M_AXI_DATA1_WSTRB),
        .dpu0_m_axi_data1_wvalid(DPUCZDX8G_0_DPU0_M_AXI_DATA1_WVALID),
        .dpu0_m_axi_instr_araddr(DPUCZDX8G_0_DPU0_M_AXI_INSTR_ARADDR),
        .dpu0_m_axi_instr_arburst(DPUCZDX8G_0_DPU0_M_AXI_INSTR_ARBURST),
        .dpu0_m_axi_instr_arcache(DPUCZDX8G_0_DPU0_M_AXI_INSTR_ARCACHE),
        .dpu0_m_axi_instr_arid(DPUCZDX8G_0_DPU0_M_AXI_INSTR_ARID),
        .dpu0_m_axi_instr_arlen(DPUCZDX8G_0_DPU0_M_AXI_INSTR_ARLEN),
        .dpu0_m_axi_instr_arlock(DPUCZDX8G_0_DPU0_M_AXI_INSTR_ARLOCK),
        .dpu0_m_axi_instr_arprot(DPUCZDX8G_0_DPU0_M_AXI_INSTR_ARPROT),
        .dpu0_m_axi_instr_arqos(DPUCZDX8G_0_DPU0_M_AXI_INSTR_ARQOS),
        .dpu0_m_axi_instr_arready(DPUCZDX8G_0_DPU0_M_AXI_INSTR_ARREADY),
        .dpu0_m_axi_instr_arsize(DPUCZDX8G_0_DPU0_M_AXI_INSTR_ARSIZE),
        .dpu0_m_axi_instr_aruser(DPUCZDX8G_0_DPU0_M_AXI_INSTR_ARUSER),
        .dpu0_m_axi_instr_arvalid(DPUCZDX8G_0_DPU0_M_AXI_INSTR_ARVALID),
        .dpu0_m_axi_instr_awaddr(DPUCZDX8G_0_DPU0_M_AXI_INSTR_AWADDR),
        .dpu0_m_axi_instr_awburst(DPUCZDX8G_0_DPU0_M_AXI_INSTR_AWBURST),
        .dpu0_m_axi_instr_awcache(DPUCZDX8G_0_DPU0_M_AXI_INSTR_AWCACHE),
        .dpu0_m_axi_instr_awid(DPUCZDX8G_0_DPU0_M_AXI_INSTR_AWID),
        .dpu0_m_axi_instr_awlen(DPUCZDX8G_0_DPU0_M_AXI_INSTR_AWLEN),
        .dpu0_m_axi_instr_awlock(DPUCZDX8G_0_DPU0_M_AXI_INSTR_AWLOCK),
        .dpu0_m_axi_instr_awprot(DPUCZDX8G_0_DPU0_M_AXI_INSTR_AWPROT),
        .dpu0_m_axi_instr_awqos(DPUCZDX8G_0_DPU0_M_AXI_INSTR_AWQOS),
        .dpu0_m_axi_instr_awready(DPUCZDX8G_0_DPU0_M_AXI_INSTR_AWREADY),
        .dpu0_m_axi_instr_awsize(DPUCZDX8G_0_DPU0_M_AXI_INSTR_AWSIZE),
        .dpu0_m_axi_instr_awuser(DPUCZDX8G_0_DPU0_M_AXI_INSTR_AWUSER),
        .dpu0_m_axi_instr_awvalid(DPUCZDX8G_0_DPU0_M_AXI_INSTR_AWVALID),
        .dpu0_m_axi_instr_bid(DPUCZDX8G_0_DPU0_M_AXI_INSTR_BID),
        .dpu0_m_axi_instr_bready(DPUCZDX8G_0_DPU0_M_AXI_INSTR_BREADY),
        .dpu0_m_axi_instr_bresp(DPUCZDX8G_0_DPU0_M_AXI_INSTR_BRESP),
        .dpu0_m_axi_instr_bvalid(DPUCZDX8G_0_DPU0_M_AXI_INSTR_BVALID),
        .dpu0_m_axi_instr_rdata(DPUCZDX8G_0_DPU0_M_AXI_INSTR_RDATA),
        .dpu0_m_axi_instr_rid(DPUCZDX8G_0_DPU0_M_AXI_INSTR_RID),
        .dpu0_m_axi_instr_rlast(DPUCZDX8G_0_DPU0_M_AXI_INSTR_RLAST),
        .dpu0_m_axi_instr_rready(DPUCZDX8G_0_DPU0_M_AXI_INSTR_RREADY),
        .dpu0_m_axi_instr_rresp(DPUCZDX8G_0_DPU0_M_AXI_INSTR_RRESP),
        .dpu0_m_axi_instr_rvalid(DPUCZDX8G_0_DPU0_M_AXI_INSTR_RVALID),
        .dpu0_m_axi_instr_wdata(DPUCZDX8G_0_DPU0_M_AXI_INSTR_WDATA),
        .dpu0_m_axi_instr_wlast(DPUCZDX8G_0_DPU0_M_AXI_INSTR_WLAST),
        .dpu0_m_axi_instr_wready(DPUCZDX8G_0_DPU0_M_AXI_INSTR_WREADY),
        .dpu0_m_axi_instr_wstrb(DPUCZDX8G_0_DPU0_M_AXI_INSTR_WSTRB),
        .dpu0_m_axi_instr_wvalid(DPUCZDX8G_0_DPU0_M_AXI_INSTR_WVALID),
        .dpu_2x_clk(clk_wiz_clk_out3),
        .dpu_2x_resetn(proc_sys_reset_3_peripheral_aresetn),
        .dpu_interrupt(DPUCZDX8G_0_dpu_interrupt),
        .m_axi_dpu_aclk(clk_wiz_0_dpu),
        .m_axi_dpu_aresetn(dpu_reset_peripheral_aresetn),
        .s_axi_aclk(clk_wiz_clk_out2),
        .s_axi_araddr(axi_interconnect_1_M01_AXI_ARADDR[31:0]),
        .s_axi_arburst(axi_interconnect_1_M01_AXI_ARBURST),
        .s_axi_arcache(axi_interconnect_1_M01_AXI_ARCACHE),
        .s_axi_aresetn(proc_sys_reset_2_peripheral_aresetn),
        .s_axi_arid({1'b0,1'b0,1'b0,1'b0,1'b0,1'b0,1'b0,1'b0,1'b0,1'b0,1'b0,1'b0,1'b0,1'b0,1'b0,1'b0}),
        .s_axi_arlen(axi_interconnect_1_M01_AXI_ARLEN),
        .s_axi_arlock({1'b0,axi_interconnect_1_M01_AXI_ARLOCK}),
        .s_axi_arprot(axi_interconnect_1_M01_AXI_ARPROT),
        .s_axi_arqos(axi_interconnect_1_M01_AXI_ARQOS),
        .s_axi_arready(axi_interconnect_1_M01_AXI_ARREADY),
        .s_axi_arregion(axi_interconnect_1_M01_AXI_ARREGION),
        .s_axi_arsize(axi_interconnect_1_M01_AXI_ARSIZE),
        .s_axi_aruser(axi_interconnect_1_M01_AXI_ARUSER),
        .s_axi_arvalid(axi_interconnect_1_M01_AXI_ARVALID),
        .s_axi_awaddr(axi_interconnect_1_M01_AXI_AWADDR[31:0]),
        .s_axi_awburst(axi_interconnect_1_M01_AXI_AWBURST),
        .s_axi_awcache(axi_interconnect_1_M01_AXI_AWCACHE),
        .s_axi_awid({1'b0,1'b0,1'b0,1'b0,1'b0,1'b0,1'b0,1'b0,1'b0,1'b0,1'b0,1'b0,1'b0,1'b0,1'b0,1'b0}),
        .s_axi_awlen(axi_interconnect_1_M01_AXI_AWLEN),
        .s_axi_awlock({1'b0,axi_interconnect_1_M01_AXI_AWLOCK}),
        .s_axi_awprot(axi_interconnect_1_M01_AXI_AWPROT),
        .s_axi_awqos(axi_interconnect_1_M01_AXI_AWQOS),
        .s_axi_awready(axi_interconnect_1_M01_AXI_AWREADY),
        .s_axi_awregion(axi_interconnect_1_M01_AXI_AWREGION),
        .s_axi_awsize(axi_interconnect_1_M01_AXI_AWSIZE),
        .s_axi_awuser(axi_interconnect_1_M01_AXI_AWUSER),
        .s_axi_awvalid(axi_interconnect_1_M01_AXI_AWVALID),
        .s_axi_bready(axi_interconnect_1_M01_AXI_BREADY),
        .s_axi_bresp(axi_interconnect_1_M01_AXI_BRESP),
        .s_axi_bvalid(axi_interconnect_1_M01_AXI_BVALID),
        .s_axi_rdata(axi_interconnect_1_M01_AXI_RDATA),
        .s_axi_rlast(axi_interconnect_1_M01_AXI_RLAST),
        .s_axi_rready(axi_interconnect_1_M01_AXI_RREADY),
        .s_axi_rresp(axi_interconnect_1_M01_AXI_RRESP),
        .s_axi_rvalid(axi_interconnect_1_M01_AXI_RVALID),
        .s_axi_wdata(axi_interconnect_1_M01_AXI_WDATA),
        .s_axi_wid({1'b0,1'b0,1'b0,1'b0,1'b0,1'b0,1'b0,1'b0,1'b0,1'b0,1'b0,1'b0,1'b0,1'b0,1'b0,1'b0}),
        .s_axi_wlast(axi_interconnect_1_M01_AXI_WLAST),
        .s_axi_wready(axi_interconnect_1_M01_AXI_WREADY),
        .s_axi_wstrb(axi_interconnect_1_M01_AXI_WSTRB),
        .s_axi_wvalid(axi_interconnect_1_M01_AXI_WVALID));
  hardware_axi_gpio_0_0 axi_gpio
       (.gpio2_io_i(xlconcat_0_dout),
        .gpio_io_o(axi_gpio_gpio_io_o),
        .s_axi_aclk(clk_wiz_clk_out2),
        .s_axi_araddr(axi_interconnect_1_M03_AXI_ARADDR[8:0]),
        .s_axi_aresetn(proc_sys_reset_2_peripheral_aresetn),
        .s_axi_arready(axi_interconnect_1_M03_AXI_ARREADY),
        .s_axi_arvalid(axi_interconnect_1_M03_AXI_ARVALID),
        .s_axi_awaddr(axi_interconnect_1_M03_AXI_AWADDR[8:0]),
        .s_axi_awready(axi_interconnect_1_M03_AXI_AWREADY),
        .s_axi_awvalid(axi_interconnect_1_M03_AXI_AWVALID),
        .s_axi_bready(axi_interconnect_1_M03_AXI_BREADY),
        .s_axi_bresp(axi_interconnect_1_M03_AXI_BRESP),
        .s_axi_bvalid(axi_interconnect_1_M03_AXI_BVALID),
        .s_axi_rdata(axi_interconnect_1_M03_AXI_RDATA),
        .s_axi_rready(axi_interconnect_1_M03_AXI_RREADY),
        .s_axi_rresp(axi_interconnect_1_M03_AXI_RRESP),
        .s_axi_rvalid(axi_interconnect_1_M03_AXI_RVALID),
        .s_axi_wdata(axi_interconnect_1_M03_AXI_WDATA),
        .s_axi_wready(axi_interconnect_1_M03_AXI_WREADY),
        .s_axi_wstrb(axi_interconnect_1_M03_AXI_WSTRB),
        .s_axi_wvalid(axi_interconnect_1_M03_AXI_WVALID));
  hardware_axi_intc_0_0 axi_intc
       (.intr(1'b0),
        .irq(axi_intc_irq),
        .s_axi_aclk(clk_wiz_clk_out2),
        .s_axi_araddr(axi_interconnect_1_M00_AXI_ARADDR[8:0]),
        .s_axi_aresetn(proc_sys_reset_2_peripheral_aresetn),
        .s_axi_arready(axi_interconnect_1_M00_AXI_ARREADY),
        .s_axi_arvalid(axi_interconnect_1_M00_AXI_ARVALID),
        .s_axi_awaddr(axi_interconnect_1_M00_AXI_AWADDR[8:0]),
        .s_axi_awready(axi_interconnect_1_M00_AXI_AWREADY),
        .s_axi_awvalid(axi_interconnect_1_M00_AXI_AWVALID),
        .s_axi_bready(axi_interconnect_1_M00_AXI_BREADY),
        .s_axi_bresp(axi_interconnect_1_M00_AXI_BRESP),
        .s_axi_bvalid(axi_interconnect_1_M00_AXI_BVALID),
        .s_axi_rdata(axi_interconnect_1_M00_AXI_RDATA),
        .s_axi_rready(axi_interconnect_1_M00_AXI_RREADY),
        .s_axi_rresp(axi_interconnect_1_M00_AXI_RRESP),
        .s_axi_rvalid(axi_interconnect_1_M00_AXI_RVALID),
        .s_axi_wdata(axi_interconnect_1_M00_AXI_WDATA),
        .s_axi_wready(axi_interconnect_1_M00_AXI_WREADY),
        .s_axi_wstrb(axi_interconnect_1_M00_AXI_WSTRB),
        .s_axi_wvalid(axi_interconnect_1_M00_AXI_WVALID));
  hardware_axi_interconnect_0_0 axi_interconnect_0
       (.ACLK(clk_wiz_clk_out2),
        .ARESETN(proc_sys_reset_2_peripheral_aresetn),
        .M00_ACLK(clk_wiz_clk_out2),
        .M00_ARESETN(proc_sys_reset_2_peripheral_aresetn),
        .M00_AXI_araddr(axi_interconnect_0_M00_AXI_ARADDR),
        .M00_AXI_arburst(axi_interconnect_0_M00_AXI_ARBURST),
        .M00_AXI_arcache(axi_interconnect_0_M00_AXI_ARCACHE),
        .M00_AXI_arid(axi_interconnect_0_M00_AXI_ARID),
        .M00_AXI_arlen(axi_interconnect_0_M00_AXI_ARLEN),
        .M00_AXI_arlock(axi_interconnect_0_M00_AXI_ARLOCK),
        .M00_AXI_arprot(axi_interconnect_0_M00_AXI_ARPROT),
        .M00_AXI_arqos(axi_interconnect_0_M00_AXI_ARQOS),
        .M00_AXI_arready(axi_interconnect_0_M00_AXI_ARREADY),
        .M00_AXI_arsize(axi_interconnect_0_M00_AXI_ARSIZE),
        .M00_AXI_aruser(axi_interconnect_0_M00_AXI_ARUSER),
        .M00_AXI_arvalid(axi_interconnect_0_M00_AXI_ARVALID),
        .M00_AXI_awaddr(axi_interconnect_0_M00_AXI_AWADDR),
        .M00_AXI_awburst(axi_interconnect_0_M00_AXI_AWBURST),
        .M00_AXI_awcache(axi_interconnect_0_M00_AXI_AWCACHE),
        .M00_AXI_awid(axi_interconnect_0_M00_AXI_AWID),
        .M00_AXI_awlen(axi_interconnect_0_M00_AXI_AWLEN),
        .M00_AXI_awlock(axi_interconnect_0_M00_AXI_AWLOCK),
        .M00_AXI_awprot(axi_interconnect_0_M00_AXI_AWPROT),
        .M00_AXI_awqos(axi_interconnect_0_M00_AXI_AWQOS),
        .M00_AXI_awready(axi_interconnect_0_M00_AXI_AWREADY),
        .M00_AXI_awsize(axi_interconnect_0_M00_AXI_AWSIZE),
        .M00_AXI_awuser(axi_interconnect_0_M00_AXI_AWUSER),
        .M00_AXI_awvalid(axi_interconnect_0_M00_AXI_AWVALID),
        .M00_AXI_bid(axi_interconnect_0_M00_AXI_BID),
        .M00_AXI_bready(axi_interconnect_0_M00_AXI_BREADY),
        .M00_AXI_bresp(axi_interconnect_0_M00_AXI_BRESP),
        .M00_AXI_bvalid(axi_interconnect_0_M00_AXI_BVALID),
        .M00_AXI_rdata(axi_interconnect_0_M00_AXI_RDATA),
        .M00_AXI_rid(axi_interconnect_0_M00_AXI_RID),
        .M00_AXI_rlast(axi_interconnect_0_M00_AXI_RLAST),
        .M00_AXI_rready(axi_interconnect_0_M00_AXI_RREADY),
        .M00_AXI_rresp(axi_interconnect_0_M00_AXI_RRESP),
        .M00_AXI_rvalid(axi_interconnect_0_M00_AXI_RVALID),
        .M00_AXI_wdata(axi_interconnect_0_M00_AXI_WDATA),
        .M00_AXI_wlast(axi_interconnect_0_M00_AXI_WLAST),
        .M00_AXI_wready(axi_interconnect_0_M00_AXI_WREADY),
        .M00_AXI_wstrb(axi_interconnect_0_M00_AXI_WSTRB),
        .M00_AXI_wvalid(axi_interconnect_0_M00_AXI_WVALID),
        .S00_ACLK(clk_wiz_clk_out2),
        .S00_ARESETN(proc_sys_reset_2_peripheral_aresetn),
        .S00_AXI_araddr(zynq_ultra_ps_M_AXI_HPM0_LPD_ARADDR),
        .S00_AXI_arburst(zynq_ultra_ps_M_AXI_HPM0_LPD_ARBURST),
        .S00_AXI_arcache(zynq_ultra_ps_M_AXI_HPM0_LPD_ARCACHE),
        .S00_AXI_arid(zynq_ultra_ps_M_AXI_HPM0_LPD_ARID),
        .S00_AXI_arlen(zynq_ultra_ps_M_AXI_HPM0_LPD_ARLEN),
        .S00_AXI_arlock(zynq_ultra_ps_M_AXI_HPM0_LPD_ARLOCK),
        .S00_AXI_arprot(zynq_ultra_ps_M_AXI_HPM0_LPD_ARPROT),
        .S00_AXI_arqos(zynq_ultra_ps_M_AXI_HPM0_LPD_ARQOS),
        .S00_AXI_arready(zynq_ultra_ps_M_AXI_HPM0_LPD_ARREADY),
        .S00_AXI_arsize(zynq_ultra_ps_M_AXI_HPM0_LPD_ARSIZE),
        .S00_AXI_aruser(zynq_ultra_ps_M_AXI_HPM0_LPD_ARUSER),
        .S00_AXI_arvalid(zynq_ultra_ps_M_AXI_HPM0_LPD_ARVALID),
        .S00_AXI_awaddr(zynq_ultra_ps_M_AXI_HPM0_LPD_AWADDR),
        .S00_AXI_awburst(zynq_ultra_ps_M_AXI_HPM0_LPD_AWBURST),
        .S00_AXI_awcache(zynq_ultra_ps_M_AXI_HPM0_LPD_AWCACHE),
        .S00_AXI_awid(zynq_ultra_ps_M_AXI_HPM0_LPD_AWID),
        .S00_AXI_awlen(zynq_ultra_ps_M_AXI_HPM0_LPD_AWLEN),
        .S00_AXI_awlock(zynq_ultra_ps_M_AXI_HPM0_LPD_AWLOCK),
        .S00_AXI_awprot(zynq_ultra_ps_M_AXI_HPM0_LPD_AWPROT),
        .S00_AXI_awqos(zynq_ultra_ps_M_AXI_HPM0_LPD_AWQOS),
        .S00_AXI_awready(zynq_ultra_ps_M_AXI_HPM0_LPD_AWREADY),
        .S00_AXI_awsize(zynq_ultra_ps_M_AXI_HPM0_LPD_AWSIZE),
        .S00_AXI_awuser(zynq_ultra_ps_M_AXI_HPM0_LPD_AWUSER),
        .S00_AXI_awvalid(zynq_ultra_ps_M_AXI_HPM0_LPD_AWVALID),
        .S00_AXI_bid(zynq_ultra_ps_M_AXI_HPM0_LPD_BID),
        .S00_AXI_bready(zynq_ultra_ps_M_AXI_HPM0_LPD_BREADY),
        .S00_AXI_bresp(zynq_ultra_ps_M_AXI_HPM0_LPD_BRESP),
        .S00_AXI_bvalid(zynq_ultra_ps_M_AXI_HPM0_LPD_BVALID),
        .S00_AXI_rdata(zynq_ultra_ps_M_AXI_HPM0_LPD_RDATA),
        .S00_AXI_rid(zynq_ultra_ps_M_AXI_HPM0_LPD_RID),
        .S00_AXI_rlast(zynq_ultra_ps_M_AXI_HPM0_LPD_RLAST),
        .S00_AXI_rready(zynq_ultra_ps_M_AXI_HPM0_LPD_RREADY),
        .S00_AXI_rresp(zynq_ultra_ps_M_AXI_HPM0_LPD_RRESP),
        .S00_AXI_rvalid(zynq_ultra_ps_M_AXI_HPM0_LPD_RVALID),
        .S00_AXI_wdata(zynq_ultra_ps_M_AXI_HPM0_LPD_WDATA),
        .S00_AXI_wlast(zynq_ultra_ps_M_AXI_HPM0_LPD_WLAST),
        .S00_AXI_wready(zynq_ultra_ps_M_AXI_HPM0_LPD_WREADY),
        .S00_AXI_wstrb(zynq_ultra_ps_M_AXI_HPM0_LPD_WSTRB),
        .S00_AXI_wvalid(zynq_ultra_ps_M_AXI_HPM0_LPD_WVALID));
  hardware_axi_interconnect_1_0 axi_interconnect_1
       (.ACLK(clk_wiz_clk_out2),
        .ARESETN(proc_sys_reset_2_peripheral_aresetn),
        .M00_ACLK(clk_wiz_clk_out2),
        .M00_ARESETN(proc_sys_reset_2_peripheral_aresetn),
        .M00_AXI_araddr(axi_interconnect_1_M00_AXI_ARADDR),
        .M00_AXI_arready(axi_interconnect_1_M00_AXI_ARREADY),
        .M00_AXI_arvalid(axi_interconnect_1_M00_AXI_ARVALID),
        .M00_AXI_awaddr(axi_interconnect_1_M00_AXI_AWADDR),
        .M00_AXI_awready(axi_interconnect_1_M00_AXI_AWREADY),
        .M00_AXI_awvalid(axi_interconnect_1_M00_AXI_AWVALID),
        .M00_AXI_bready(axi_interconnect_1_M00_AXI_BREADY),
        .M00_AXI_bresp(axi_interconnect_1_M00_AXI_BRESP),
        .M00_AXI_bvalid(axi_interconnect_1_M00_AXI_BVALID),
        .M00_AXI_rdata(axi_interconnect_1_M00_AXI_RDATA),
        .M00_AXI_rready(axi_interconnect_1_M00_AXI_RREADY),
        .M00_AXI_rresp(axi_interconnect_1_M00_AXI_RRESP),
        .M00_AXI_rvalid(axi_interconnect_1_M00_AXI_RVALID),
        .M00_AXI_wdata(axi_interconnect_1_M00_AXI_WDATA),
        .M00_AXI_wready(axi_interconnect_1_M00_AXI_WREADY),
        .M00_AXI_wstrb(axi_interconnect_1_M00_AXI_WSTRB),
        .M00_AXI_wvalid(axi_interconnect_1_M00_AXI_WVALID),
        .M01_ACLK(clk_wiz_clk_out2),
        .M01_ARESETN(proc_sys_reset_2_peripheral_aresetn),
        .M01_AXI_araddr(axi_interconnect_1_M01_AXI_ARADDR),
        .M01_AXI_arburst(axi_interconnect_1_M01_AXI_ARBURST),
        .M01_AXI_arcache(axi_interconnect_1_M01_AXI_ARCACHE),
        .M01_AXI_arlen(axi_interconnect_1_M01_AXI_ARLEN),
        .M01_AXI_arlock(axi_interconnect_1_M01_AXI_ARLOCK),
        .M01_AXI_arprot(axi_interconnect_1_M01_AXI_ARPROT),
        .M01_AXI_arqos(axi_interconnect_1_M01_AXI_ARQOS),
        .M01_AXI_arready(axi_interconnect_1_M01_AXI_ARREADY),
        .M01_AXI_arregion(axi_interconnect_1_M01_AXI_ARREGION),
        .M01_AXI_arsize(axi_interconnect_1_M01_AXI_ARSIZE),
        .M01_AXI_aruser(axi_interconnect_1_M01_AXI_ARUSER),
        .M01_AXI_arvalid(axi_interconnect_1_M01_AXI_ARVALID),
        .M01_AXI_awaddr(axi_interconnect_1_M01_AXI_AWADDR),
        .M01_AXI_awburst(axi_interconnect_1_M01_AXI_AWBURST),
        .M01_AXI_awcache(axi_interconnect_1_M01_AXI_AWCACHE),
        .M01_AXI_awlen(axi_interconnect_1_M01_AXI_AWLEN),
        .M01_AXI_awlock(axi_interconnect_1_M01_AXI_AWLOCK),
        .M01_AXI_awprot(axi_interconnect_1_M01_AXI_AWPROT),
        .M01_AXI_awqos(axi_interconnect_1_M01_AXI_AWQOS),
        .M01_AXI_awready(axi_interconnect_1_M01_AXI_AWREADY),
        .M01_AXI_awregion(axi_interconnect_1_M01_AXI_AWREGION),
        .M01_AXI_awsize(axi_interconnect_1_M01_AXI_AWSIZE),
        .M01_AXI_awuser(axi_interconnect_1_M01_AXI_AWUSER),
        .M01_AXI_awvalid(axi_interconnect_1_M01_AXI_AWVALID),
        .M01_AXI_bready(axi_interconnect_1_M01_AXI_BREADY),
        .M01_AXI_bresp(axi_interconnect_1_M01_AXI_BRESP),
        .M01_AXI_bvalid(axi_interconnect_1_M01_AXI_BVALID),
        .M01_AXI_rdata(axi_interconnect_1_M01_AXI_RDATA),
        .M01_AXI_rlast(axi_interconnect_1_M01_AXI_RLAST),
        .M01_AXI_rready(axi_interconnect_1_M01_AXI_RREADY),
        .M01_AXI_rresp(axi_interconnect_1_M01_AXI_RRESP),
        .M01_AXI_rvalid(axi_interconnect_1_M01_AXI_RVALID),
        .M01_AXI_wdata(axi_interconnect_1_M01_AXI_WDATA),
        .M01_AXI_wlast(axi_interconnect_1_M01_AXI_WLAST),
        .M01_AXI_wready(axi_interconnect_1_M01_AXI_WREADY),
        .M01_AXI_wstrb(axi_interconnect_1_M01_AXI_WSTRB),
        .M01_AXI_wvalid(axi_interconnect_1_M01_AXI_WVALID),
        .M02_ACLK(clk_wiz_clk_out2),
        .M02_ARESETN(proc_sys_reset_2_peripheral_aresetn),
        .M02_AXI_araddr(axi_interconnect_1_M02_AXI_ARADDR),
        .M02_AXI_arready(axi_interconnect_1_M02_AXI_ARREADY),
        .M02_AXI_arvalid(axi_interconnect_1_M02_AXI_ARVALID),
        .M02_AXI_awaddr(axi_interconnect_1_M02_AXI_AWADDR),
        .M02_AXI_awready(axi_interconnect_1_M02_AXI_AWREADY),
        .M02_AXI_awvalid(axi_interconnect_1_M02_AXI_AWVALID),
        .M02_AXI_bready(axi_interconnect_1_M02_AXI_BREADY),
        .M02_AXI_bresp(axi_interconnect_1_M02_AXI_BRESP),
        .M02_AXI_bvalid(axi_interconnect_1_M02_AXI_BVALID),
        .M02_AXI_rdata(axi_interconnect_1_M02_AXI_RDATA),
        .M02_AXI_rready(axi_interconnect_1_M02_AXI_RREADY),
        .M02_AXI_rresp(axi_interconnect_1_M02_AXI_RRESP),
        .M02_AXI_rvalid(axi_interconnect_1_M02_AXI_RVALID),
        .M02_AXI_wdata(axi_interconnect_1_M02_AXI_WDATA),
        .M02_AXI_wready(axi_interconnect_1_M02_AXI_WREADY),
        .M02_AXI_wstrb(axi_interconnect_1_M02_AXI_WSTRB),
        .M02_AXI_wvalid(axi_interconnect_1_M02_AXI_WVALID),
        .M03_ACLK(clk_wiz_clk_out2),
        .M03_ARESETN(proc_sys_reset_2_peripheral_aresetn),
        .M03_AXI_araddr(axi_interconnect_1_M03_AXI_ARADDR),
        .M03_AXI_arready(axi_interconnect_1_M03_AXI_ARREADY),
        .M03_AXI_arvalid(axi_interconnect_1_M03_AXI_ARVALID),
        .M03_AXI_awaddr(axi_interconnect_1_M03_AXI_AWADDR),
        .M03_AXI_awready(axi_interconnect_1_M03_AXI_AWREADY),
        .M03_AXI_awvalid(axi_interconnect_1_M03_AXI_AWVALID),
        .M03_AXI_bready(axi_interconnect_1_M03_AXI_BREADY),
        .M03_AXI_bresp(axi_interconnect_1_M03_AXI_BRESP),
        .M03_AXI_bvalid(axi_interconnect_1_M03_AXI_BVALID),
        .M03_AXI_rdata(axi_interconnect_1_M03_AXI_RDATA),
        .M03_AXI_rready(axi_interconnect_1_M03_AXI_RREADY),
        .M03_AXI_rresp(axi_interconnect_1_M03_AXI_RRESP),
        .M03_AXI_rvalid(axi_interconnect_1_M03_AXI_RVALID),
        .M03_AXI_wdata(axi_interconnect_1_M03_AXI_WDATA),
        .M03_AXI_wready(axi_interconnect_1_M03_AXI_WREADY),
        .M03_AXI_wstrb(axi_interconnect_1_M03_AXI_WSTRB),
        .M03_AXI_wvalid(axi_interconnect_1_M03_AXI_WVALID),
        .S00_ACLK(clk_wiz_clk_out2),
        .S00_ARESETN(proc_sys_reset_2_peripheral_aresetn),
        .S00_AXI_araddr(axi_interconnect_0_M00_AXI_ARADDR),
        .S00_AXI_arburst(axi_interconnect_0_M00_AXI_ARBURST),
        .S00_AXI_arcache(axi_interconnect_0_M00_AXI_ARCACHE),
        .S00_AXI_arid(axi_interconnect_0_M00_AXI_ARID),
        .S00_AXI_arlen(axi_interconnect_0_M00_AXI_ARLEN),
        .S00_AXI_arlock(axi_interconnect_0_M00_AXI_ARLOCK),
        .S00_AXI_arprot(axi_interconnect_0_M00_AXI_ARPROT),
        .S00_AXI_arqos(axi_interconnect_0_M00_AXI_ARQOS),
        .S00_AXI_arready(axi_interconnect_0_M00_AXI_ARREADY),
        .S00_AXI_arsize(axi_interconnect_0_M00_AXI_ARSIZE),
        .S00_AXI_aruser(axi_interconnect_0_M00_AXI_ARUSER),
        .S00_AXI_arvalid(axi_interconnect_0_M00_AXI_ARVALID),
        .S00_AXI_awaddr(axi_interconnect_0_M00_AXI_AWADDR),
        .S00_AXI_awburst(axi_interconnect_0_M00_AXI_AWBURST),
        .S00_AXI_awcache(axi_interconnect_0_M00_AXI_AWCACHE),
        .S00_AXI_awid(axi_interconnect_0_M00_AXI_AWID),
        .S00_AXI_awlen(axi_interconnect_0_M00_AXI_AWLEN),
        .S00_AXI_awlock(axi_interconnect_0_M00_AXI_AWLOCK),
        .S00_AXI_awprot(axi_interconnect_0_M00_AXI_AWPROT),
        .S00_AXI_awqos(axi_interconnect_0_M00_AXI_AWQOS),
        .S00_AXI_awready(axi_interconnect_0_M00_AXI_AWREADY),
        .S00_AXI_awsize(axi_interconnect_0_M00_AXI_AWSIZE),
        .S00_AXI_awuser(axi_interconnect_0_M00_AXI_AWUSER),
        .S00_AXI_awvalid(axi_interconnect_0_M00_AXI_AWVALID),
        .S00_AXI_bid(axi_interconnect_0_M00_AXI_BID),
        .S00_AXI_bready(axi_interconnect_0_M00_AXI_BREADY),
        .S00_AXI_bresp(axi_interconnect_0_M00_AXI_BRESP),
        .S00_AXI_bvalid(axi_interconnect_0_M00_AXI_BVALID),
        .S00_AXI_rdata(axi_interconnect_0_M00_AXI_RDATA),
        .S00_AXI_rid(axi_interconnect_0_M00_AXI_RID),
        .S00_AXI_rlast(axi_interconnect_0_M00_AXI_RLAST),
        .S00_AXI_rready(axi_interconnect_0_M00_AXI_RREADY),
        .S00_AXI_rresp(axi_interconnect_0_M00_AXI_RRESP),
        .S00_AXI_rvalid(axi_interconnect_0_M00_AXI_RVALID),
        .S00_AXI_wdata(axi_interconnect_0_M00_AXI_WDATA),
        .S00_AXI_wlast(axi_interconnect_0_M00_AXI_WLAST),
        .S00_AXI_wready(axi_interconnect_0_M00_AXI_WREADY),
        .S00_AXI_wstrb(axi_interconnect_0_M00_AXI_WSTRB),
        .S00_AXI_wvalid(axi_interconnect_0_M00_AXI_WVALID));
  hardware_clk_wiz_0_2 clk_wiz_0
       (.clk_in1(zynq_ultra_ps_pl_clk0),
        .dpu(clk_wiz_0_dpu),
        .dpux2(clk_wiz_clk_out3),
        .locked(clk_wiz_locked),
        .resetn(zynq_ultra_ps_pl_resetn0));
  hardware_clk_wiz_1_0 clk_wiz_1
       (.clk_in1(zynq_ultra_ps_pl_clk0),
        .global(clk_wiz_clk_out2),
        .locked(clk_wiz_1_locked),
        .resetn(zynq_ultra_ps_pl_resetn0));
  hardware_xlslice_0_0 cmd_bits
       (.Din(axi_gpio_gpio_io_o),
        .Dout(cmd_bits_Dout));
  hardware_divider_0_1 div_stepper
       (.clk_in(clk_wiz_clk_out2),
        .clk_out(div_stepper_clk_out),
        .rst(proc_sys_reset_2_peripheral_aresetn));
  hardware_divider_0_0 divider_pwm
       (.clk_in(clk_wiz_clk_out2),
        .clk_out(divider_0_clk_out),
        .rst(proc_sys_reset_2_peripheral_aresetn));
  hardware_proc_sys_reset_0_0 dpu_reset
       (.aux_reset_in(1'b1),
        .dcm_locked(clk_wiz_locked),
        .ext_reset_in(zynq_ultra_ps_pl_resetn0),
        .mb_debug_sys_rst(1'b0),
        .peripheral_aresetn(dpu_reset_peripheral_aresetn),
        .slowest_sync_clk(clk_wiz_0_dpu));
  hardware_proc_sys_reset_1_1 dpux2_reset
       (.aux_reset_in(1'b1),
        .dcm_locked(clk_wiz_locked),
        .ext_reset_in(zynq_ultra_ps_pl_resetn0),
        .mb_debug_sys_rst(1'b0),
        .peripheral_aresetn(proc_sys_reset_3_peripheral_aresetn),
        .slowest_sync_clk(clk_wiz_clk_out3));
  hardware_cmd_bits_1 ena_bit
       (.Din(axi_gpio_gpio_io_o),
        .Dout(ena_bit_Dout));
  hardware_proc_sys_reset_1_0 global_reset
       (.aux_reset_in(1'b1),
        .dcm_locked(clk_wiz_1_locked),
        .ext_reset_in(zynq_ultra_ps_pl_resetn0),
        .mb_debug_sys_rst(1'b0),
        .peripheral_aresetn(proc_sys_reset_2_peripheral_aresetn),
        .slowest_sync_clk(clk_wiz_clk_out2));
  hardware_cmd_bits_0 latch_bit
       (.Din(axi_gpio_gpio_io_o),
        .Dout(latch_bit_Dout));
  hardware_pwm_0_0 pwm
       (.clk(divider_0_clk_out),
        .fill(temp2pwm_0_pwm),
        .rst(proc_sys_reset_2_peripheral_aresetn),
        .state(pwm_0_state));
  hardware_stepper_0_0 stepper_ctrl
       (.busy(stepper_ctrl_busy),
        .clk(div_stepper_clk_out),
        .cmd(cmd_bits_Dout),
        .dir(stepper_ctrl_dir),
        .ena(stepper_ctrl_ena),
        .force_ena(ena_bit_Dout),
        .latch(latch_bit_Dout),
        .step(stepper_ctrl_step),
        .stop1(stop1_1),
        .stop2(stop2_1));
  hardware_system_management_wiz_0_0 system_management_wiz
       (.eos_out(system_management_wiz_0_eos_out),
        .ip2intc_irpt(system_management_wiz_ip2intc_irpt),
        .s_axi_aclk(clk_wiz_clk_out2),
        .s_axi_araddr(axi_interconnect_1_M02_AXI_ARADDR),
        .s_axi_aresetn(proc_sys_reset_2_peripheral_aresetn),
        .s_axi_arready(axi_interconnect_1_M02_AXI_ARREADY),
        .s_axi_arvalid(axi_interconnect_1_M02_AXI_ARVALID),
        .s_axi_awaddr(axi_interconnect_1_M02_AXI_AWADDR),
        .s_axi_awready(axi_interconnect_1_M02_AXI_AWREADY),
        .s_axi_awvalid(axi_interconnect_1_M02_AXI_AWVALID),
        .s_axi_bready(axi_interconnect_1_M02_AXI_BREADY),
        .s_axi_bresp(axi_interconnect_1_M02_AXI_BRESP),
        .s_axi_bvalid(axi_interconnect_1_M02_AXI_BVALID),
        .s_axi_rdata(axi_interconnect_1_M02_AXI_RDATA),
        .s_axi_rready(axi_interconnect_1_M02_AXI_RREADY),
        .s_axi_rresp(axi_interconnect_1_M02_AXI_RRESP),
        .s_axi_rvalid(axi_interconnect_1_M02_AXI_RVALID),
        .s_axi_wdata(axi_interconnect_1_M02_AXI_WDATA),
        .s_axi_wready(axi_interconnect_1_M02_AXI_WREADY),
        .s_axi_wstrb(axi_interconnect_1_M02_AXI_WSTRB),
        .s_axi_wvalid(axi_interconnect_1_M02_AXI_WVALID),
        .temp_out(system_management_wiz_0_temp_out));
  hardware_temp2pwm_0_0 temp2pwm
       (.pwm(temp2pwm_0_pwm),
        .rdy(system_management_wiz_0_eos_out),
        .temp(system_management_wiz_0_temp_out));
  hardware_xlconcat_0_0 xlconcat_0
       (.In0(stepper_ctrl_busy),
        .In1(stop1_1),
        .In2(stop2_1),
        .dout(xlconcat_0_dout));
  hardware_xlconcat_3_0 xlconcat_3
       (.In0(axi_intc_irq),
        .In1(system_management_wiz_ip2intc_irpt),
        .In2(DPUCZDX8G_0_dpu_interrupt),
        .dout(xlconcat_3_dout));
  hardware_zynq_ultra_ps_e_0_0 zynq_ultra_ps
       (.maxigp2_araddr(zynq_ultra_ps_M_AXI_HPM0_LPD_ARADDR),
        .maxigp2_arburst(zynq_ultra_ps_M_AXI_HPM0_LPD_ARBURST),
        .maxigp2_arcache(zynq_ultra_ps_M_AXI_HPM0_LPD_ARCACHE),
        .maxigp2_arid(zynq_ultra_ps_M_AXI_HPM0_LPD_ARID),
        .maxigp2_arlen(zynq_ultra_ps_M_AXI_HPM0_LPD_ARLEN),
        .maxigp2_arlock(zynq_ultra_ps_M_AXI_HPM0_LPD_ARLOCK),
        .maxigp2_arprot(zynq_ultra_ps_M_AXI_HPM0_LPD_ARPROT),
        .maxigp2_arqos(zynq_ultra_ps_M_AXI_HPM0_LPD_ARQOS),
        .maxigp2_arready(zynq_ultra_ps_M_AXI_HPM0_LPD_ARREADY),
        .maxigp2_arsize(zynq_ultra_ps_M_AXI_HPM0_LPD_ARSIZE),
        .maxigp2_aruser(zynq_ultra_ps_M_AXI_HPM0_LPD_ARUSER),
        .maxigp2_arvalid(zynq_ultra_ps_M_AXI_HPM0_LPD_ARVALID),
        .maxigp2_awaddr(zynq_ultra_ps_M_AXI_HPM0_LPD_AWADDR),
        .maxigp2_awburst(zynq_ultra_ps_M_AXI_HPM0_LPD_AWBURST),
        .maxigp2_awcache(zynq_ultra_ps_M_AXI_HPM0_LPD_AWCACHE),
        .maxigp2_awid(zynq_ultra_ps_M_AXI_HPM0_LPD_AWID),
        .maxigp2_awlen(zynq_ultra_ps_M_AXI_HPM0_LPD_AWLEN),
        .maxigp2_awlock(zynq_ultra_ps_M_AXI_HPM0_LPD_AWLOCK),
        .maxigp2_awprot(zynq_ultra_ps_M_AXI_HPM0_LPD_AWPROT),
        .maxigp2_awqos(zynq_ultra_ps_M_AXI_HPM0_LPD_AWQOS),
        .maxigp2_awready(zynq_ultra_ps_M_AXI_HPM0_LPD_AWREADY),
        .maxigp2_awsize(zynq_ultra_ps_M_AXI_HPM0_LPD_AWSIZE),
        .maxigp2_awuser(zynq_ultra_ps_M_AXI_HPM0_LPD_AWUSER),
        .maxigp2_awvalid(zynq_ultra_ps_M_AXI_HPM0_LPD_AWVALID),
        .maxigp2_bid(zynq_ultra_ps_M_AXI_HPM0_LPD_BID),
        .maxigp2_bready(zynq_ultra_ps_M_AXI_HPM0_LPD_BREADY),
        .maxigp2_bresp(zynq_ultra_ps_M_AXI_HPM0_LPD_BRESP),
        .maxigp2_bvalid(zynq_ultra_ps_M_AXI_HPM0_LPD_BVALID),
        .maxigp2_rdata(zynq_ultra_ps_M_AXI_HPM0_LPD_RDATA),
        .maxigp2_rid(zynq_ultra_ps_M_AXI_HPM0_LPD_RID),
        .maxigp2_rlast(zynq_ultra_ps_M_AXI_HPM0_LPD_RLAST),
        .maxigp2_rready(zynq_ultra_ps_M_AXI_HPM0_LPD_RREADY),
        .maxigp2_rresp(zynq_ultra_ps_M_AXI_HPM0_LPD_RRESP),
        .maxigp2_rvalid(zynq_ultra_ps_M_AXI_HPM0_LPD_RVALID),
        .maxigp2_wdata(zynq_ultra_ps_M_AXI_HPM0_LPD_WDATA),
        .maxigp2_wlast(zynq_ultra_ps_M_AXI_HPM0_LPD_WLAST),
        .maxigp2_wready(zynq_ultra_ps_M_AXI_HPM0_LPD_WREADY),
        .maxigp2_wstrb(zynq_ultra_ps_M_AXI_HPM0_LPD_WSTRB),
        .maxigp2_wvalid(zynq_ultra_ps_M_AXI_HPM0_LPD_WVALID),
        .maxihpm0_lpd_aclk(clk_wiz_clk_out2),
        .pl_clk0(zynq_ultra_ps_pl_clk0),
        .pl_ps_irq0(xlconcat_3_dout),
        .pl_resetn0(zynq_ultra_ps_pl_resetn0),
        .saxi_lpd_aclk(clk_wiz_0_dpu),
        .saxigp0_araddr({1'b0,1'b0,1'b0,1'b0,1'b0,1'b0,1'b0,1'b0,1'b0,DPUCZDX8G_0_DPU0_M_AXI_DATA0_ARADDR}),
        .saxigp0_arburst(DPUCZDX8G_0_DPU0_M_AXI_DATA0_ARBURST),
        .saxigp0_arcache(DPUCZDX8G_0_DPU0_M_AXI_DATA0_ARCACHE),
        .saxigp0_arid({1'b0,1'b0,1'b0,1'b0,DPUCZDX8G_0_DPU0_M_AXI_DATA0_ARID}),
        .saxigp0_arlen(DPUCZDX8G_0_DPU0_M_AXI_DATA0_ARLEN),
        .saxigp0_arlock(DPUCZDX8G_0_DPU0_M_AXI_DATA0_ARLOCK),
        .saxigp0_arprot(DPUCZDX8G_0_DPU0_M_AXI_DATA0_ARPROT),
        .saxigp0_arqos(DPUCZDX8G_0_DPU0_M_AXI_DATA0_ARQOS),
        .saxigp0_arready(DPUCZDX8G_0_DPU0_M_AXI_DATA0_ARREADY),
        .saxigp0_arsize(DPUCZDX8G_0_DPU0_M_AXI_DATA0_ARSIZE),
        .saxigp0_aruser(DPUCZDX8G_0_DPU0_M_AXI_DATA0_ARUSER),
        .saxigp0_arvalid(DPUCZDX8G_0_DPU0_M_AXI_DATA0_ARVALID),
        .saxigp0_awaddr({1'b0,1'b0,1'b0,1'b0,1'b0,1'b0,1'b0,1'b0,1'b0,DPUCZDX8G_0_DPU0_M_AXI_DATA0_AWADDR}),
        .saxigp0_awburst(DPUCZDX8G_0_DPU0_M_AXI_DATA0_AWBURST),
        .saxigp0_awcache(DPUCZDX8G_0_DPU0_M_AXI_DATA0_AWCACHE),
        .saxigp0_awid({1'b0,1'b0,1'b0,1'b0,DPUCZDX8G_0_DPU0_M_AXI_DATA0_AWID}),
        .saxigp0_awlen(DPUCZDX8G_0_DPU0_M_AXI_DATA0_AWLEN),
        .saxigp0_awlock(DPUCZDX8G_0_DPU0_M_AXI_DATA0_AWLOCK),
        .saxigp0_awprot(DPUCZDX8G_0_DPU0_M_AXI_DATA0_AWPROT),
        .saxigp0_awqos(DPUCZDX8G_0_DPU0_M_AXI_DATA0_AWQOS),
        .saxigp0_awready(DPUCZDX8G_0_DPU0_M_AXI_DATA0_AWREADY),
        .saxigp0_awsize(DPUCZDX8G_0_DPU0_M_AXI_DATA0_AWSIZE),
        .saxigp0_awuser(DPUCZDX8G_0_DPU0_M_AXI_DATA0_AWUSER),
        .saxigp0_awvalid(DPUCZDX8G_0_DPU0_M_AXI_DATA0_AWVALID),
        .saxigp0_bid(DPUCZDX8G_0_DPU0_M_AXI_DATA0_BID),
        .saxigp0_bready(DPUCZDX8G_0_DPU0_M_AXI_DATA0_BREADY),
        .saxigp0_bresp(DPUCZDX8G_0_DPU0_M_AXI_DATA0_BRESP),
        .saxigp0_bvalid(DPUCZDX8G_0_DPU0_M_AXI_DATA0_BVALID),
        .saxigp0_rdata(DPUCZDX8G_0_DPU0_M_AXI_DATA0_RDATA),
        .saxigp0_rid(DPUCZDX8G_0_DPU0_M_AXI_DATA0_RID),
        .saxigp0_rlast(DPUCZDX8G_0_DPU0_M_AXI_DATA0_RLAST),
        .saxigp0_rready(DPUCZDX8G_0_DPU0_M_AXI_DATA0_RREADY),
        .saxigp0_rresp(DPUCZDX8G_0_DPU0_M_AXI_DATA0_RRESP),
        .saxigp0_rvalid(DPUCZDX8G_0_DPU0_M_AXI_DATA0_RVALID),
        .saxigp0_wdata(DPUCZDX8G_0_DPU0_M_AXI_DATA0_WDATA),
        .saxigp0_wlast(DPUCZDX8G_0_DPU0_M_AXI_DATA0_WLAST),
        .saxigp0_wready(DPUCZDX8G_0_DPU0_M_AXI_DATA0_WREADY),
        .saxigp0_wstrb(DPUCZDX8G_0_DPU0_M_AXI_DATA0_WSTRB),
        .saxigp0_wvalid(DPUCZDX8G_0_DPU0_M_AXI_DATA0_WVALID),
        .saxigp1_araddr({1'b0,1'b0,1'b0,1'b0,1'b0,1'b0,1'b0,1'b0,1'b0,DPUCZDX8G_0_DPU0_M_AXI_DATA1_ARADDR}),
        .saxigp1_arburst(DPUCZDX8G_0_DPU0_M_AXI_DATA1_ARBURST),
        .saxigp1_arcache(DPUCZDX8G_0_DPU0_M_AXI_DATA1_ARCACHE),
        .saxigp1_arid({1'b0,1'b0,1'b0,1'b0,DPUCZDX8G_0_DPU0_M_AXI_DATA1_ARID}),
        .saxigp1_arlen(DPUCZDX8G_0_DPU0_M_AXI_DATA1_ARLEN),
        .saxigp1_arlock(DPUCZDX8G_0_DPU0_M_AXI_DATA1_ARLOCK),
        .saxigp1_arprot(DPUCZDX8G_0_DPU0_M_AXI_DATA1_ARPROT),
        .saxigp1_arqos(DPUCZDX8G_0_DPU0_M_AXI_DATA1_ARQOS),
        .saxigp1_arready(DPUCZDX8G_0_DPU0_M_AXI_DATA1_ARREADY),
        .saxigp1_arsize(DPUCZDX8G_0_DPU0_M_AXI_DATA1_ARSIZE),
        .saxigp1_aruser(DPUCZDX8G_0_DPU0_M_AXI_DATA1_ARUSER),
        .saxigp1_arvalid(DPUCZDX8G_0_DPU0_M_AXI_DATA1_ARVALID),
        .saxigp1_awaddr({1'b0,1'b0,1'b0,1'b0,1'b0,1'b0,1'b0,1'b0,1'b0,DPUCZDX8G_0_DPU0_M_AXI_DATA1_AWADDR}),
        .saxigp1_awburst(DPUCZDX8G_0_DPU0_M_AXI_DATA1_AWBURST),
        .saxigp1_awcache(DPUCZDX8G_0_DPU0_M_AXI_DATA1_AWCACHE),
        .saxigp1_awid({1'b0,1'b0,1'b0,1'b0,DPUCZDX8G_0_DPU0_M_AXI_DATA1_AWID}),
        .saxigp1_awlen(DPUCZDX8G_0_DPU0_M_AXI_DATA1_AWLEN),
        .saxigp1_awlock(DPUCZDX8G_0_DPU0_M_AXI_DATA1_AWLOCK),
        .saxigp1_awprot(DPUCZDX8G_0_DPU0_M_AXI_DATA1_AWPROT),
        .saxigp1_awqos(DPUCZDX8G_0_DPU0_M_AXI_DATA1_AWQOS),
        .saxigp1_awready(DPUCZDX8G_0_DPU0_M_AXI_DATA1_AWREADY),
        .saxigp1_awsize(DPUCZDX8G_0_DPU0_M_AXI_DATA1_AWSIZE),
        .saxigp1_awuser(DPUCZDX8G_0_DPU0_M_AXI_DATA1_AWUSER),
        .saxigp1_awvalid(DPUCZDX8G_0_DPU0_M_AXI_DATA1_AWVALID),
        .saxigp1_bid(DPUCZDX8G_0_DPU0_M_AXI_DATA1_BID),
        .saxigp1_bready(DPUCZDX8G_0_DPU0_M_AXI_DATA1_BREADY),
        .saxigp1_bresp(DPUCZDX8G_0_DPU0_M_AXI_DATA1_BRESP),
        .saxigp1_bvalid(DPUCZDX8G_0_DPU0_M_AXI_DATA1_BVALID),
        .saxigp1_rdata(DPUCZDX8G_0_DPU0_M_AXI_DATA1_RDATA),
        .saxigp1_rid(DPUCZDX8G_0_DPU0_M_AXI_DATA1_RID),
        .saxigp1_rlast(DPUCZDX8G_0_DPU0_M_AXI_DATA1_RLAST),
        .saxigp1_rready(DPUCZDX8G_0_DPU0_M_AXI_DATA1_RREADY),
        .saxigp1_rresp(DPUCZDX8G_0_DPU0_M_AXI_DATA1_RRESP),
        .saxigp1_rvalid(DPUCZDX8G_0_DPU0_M_AXI_DATA1_RVALID),
        .saxigp1_wdata(DPUCZDX8G_0_DPU0_M_AXI_DATA1_WDATA),
        .saxigp1_wlast(DPUCZDX8G_0_DPU0_M_AXI_DATA1_WLAST),
        .saxigp1_wready(DPUCZDX8G_0_DPU0_M_AXI_DATA1_WREADY),
        .saxigp1_wstrb(DPUCZDX8G_0_DPU0_M_AXI_DATA1_WSTRB),
        .saxigp1_wvalid(DPUCZDX8G_0_DPU0_M_AXI_DATA1_WVALID),
        .saxigp6_araddr({1'b0,1'b0,1'b0,1'b0,1'b0,1'b0,1'b0,1'b0,1'b0,DPUCZDX8G_0_DPU0_M_AXI_INSTR_ARADDR}),
        .saxigp6_arburst(DPUCZDX8G_0_DPU0_M_AXI_INSTR_ARBURST),
        .saxigp6_arcache(DPUCZDX8G_0_DPU0_M_AXI_INSTR_ARCACHE),
        .saxigp6_arid({1'b0,1'b0,1'b0,1'b0,DPUCZDX8G_0_DPU0_M_AXI_INSTR_ARID}),
        .saxigp6_arlen(DPUCZDX8G_0_DPU0_M_AXI_INSTR_ARLEN),
        .saxigp6_arlock(DPUCZDX8G_0_DPU0_M_AXI_INSTR_ARLOCK),
        .saxigp6_arprot(DPUCZDX8G_0_DPU0_M_AXI_INSTR_ARPROT),
        .saxigp6_arqos(DPUCZDX8G_0_DPU0_M_AXI_INSTR_ARQOS),
        .saxigp6_arready(DPUCZDX8G_0_DPU0_M_AXI_INSTR_ARREADY),
        .saxigp6_arsize(DPUCZDX8G_0_DPU0_M_AXI_INSTR_ARSIZE),
        .saxigp6_aruser(DPUCZDX8G_0_DPU0_M_AXI_INSTR_ARUSER),
        .saxigp6_arvalid(DPUCZDX8G_0_DPU0_M_AXI_INSTR_ARVALID),
        .saxigp6_awaddr({1'b0,1'b0,1'b0,1'b0,1'b0,1'b0,1'b0,1'b0,1'b0,DPUCZDX8G_0_DPU0_M_AXI_INSTR_AWADDR}),
        .saxigp6_awburst(DPUCZDX8G_0_DPU0_M_AXI_INSTR_AWBURST),
        .saxigp6_awcache(DPUCZDX8G_0_DPU0_M_AXI_INSTR_AWCACHE),
        .saxigp6_awid({1'b0,1'b0,1'b0,1'b0,DPUCZDX8G_0_DPU0_M_AXI_INSTR_AWID}),
        .saxigp6_awlen(DPUCZDX8G_0_DPU0_M_AXI_INSTR_AWLEN),
        .saxigp6_awlock(DPUCZDX8G_0_DPU0_M_AXI_INSTR_AWLOCK),
        .saxigp6_awprot(DPUCZDX8G_0_DPU0_M_AXI_INSTR_AWPROT),
        .saxigp6_awqos(DPUCZDX8G_0_DPU0_M_AXI_INSTR_AWQOS),
        .saxigp6_awready(DPUCZDX8G_0_DPU0_M_AXI_INSTR_AWREADY),
        .saxigp6_awsize(DPUCZDX8G_0_DPU0_M_AXI_INSTR_AWSIZE),
        .saxigp6_awuser(DPUCZDX8G_0_DPU0_M_AXI_INSTR_AWUSER),
        .saxigp6_awvalid(DPUCZDX8G_0_DPU0_M_AXI_INSTR_AWVALID),
        .saxigp6_bid(DPUCZDX8G_0_DPU0_M_AXI_INSTR_BID),
        .saxigp6_bready(DPUCZDX8G_0_DPU0_M_AXI_INSTR_BREADY),
        .saxigp6_bresp(DPUCZDX8G_0_DPU0_M_AXI_INSTR_BRESP),
        .saxigp6_bvalid(DPUCZDX8G_0_DPU0_M_AXI_INSTR_BVALID),
        .saxigp6_rdata(DPUCZDX8G_0_DPU0_M_AXI_INSTR_RDATA),
        .saxigp6_rid(DPUCZDX8G_0_DPU0_M_AXI_INSTR_RID),
        .saxigp6_rlast(DPUCZDX8G_0_DPU0_M_AXI_INSTR_RLAST),
        .saxigp6_rready(DPUCZDX8G_0_DPU0_M_AXI_INSTR_RREADY),
        .saxigp6_rresp(DPUCZDX8G_0_DPU0_M_AXI_INSTR_RRESP),
        .saxigp6_rvalid(DPUCZDX8G_0_DPU0_M_AXI_INSTR_RVALID),
        .saxigp6_wdata(DPUCZDX8G_0_DPU0_M_AXI_INSTR_WDATA),
        .saxigp6_wlast(DPUCZDX8G_0_DPU0_M_AXI_INSTR_WLAST),
        .saxigp6_wready(DPUCZDX8G_0_DPU0_M_AXI_INSTR_WREADY),
        .saxigp6_wstrb(DPUCZDX8G_0_DPU0_M_AXI_INSTR_WSTRB),
        .saxigp6_wvalid(DPUCZDX8G_0_DPU0_M_AXI_INSTR_WVALID),
        .saxihpc0_fpd_aclk(clk_wiz_0_dpu),
        .saxihpc1_fpd_aclk(clk_wiz_0_dpu));
endmodule

module hardware_axi_interconnect_0_0
   (ACLK,
    ARESETN,
    M00_ACLK,
    M00_ARESETN,
    M00_AXI_araddr,
    M00_AXI_arburst,
    M00_AXI_arcache,
    M00_AXI_arid,
    M00_AXI_arlen,
    M00_AXI_arlock,
    M00_AXI_arprot,
    M00_AXI_arqos,
    M00_AXI_arready,
    M00_AXI_arsize,
    M00_AXI_aruser,
    M00_AXI_arvalid,
    M00_AXI_awaddr,
    M00_AXI_awburst,
    M00_AXI_awcache,
    M00_AXI_awid,
    M00_AXI_awlen,
    M00_AXI_awlock,
    M00_AXI_awprot,
    M00_AXI_awqos,
    M00_AXI_awready,
    M00_AXI_awsize,
    M00_AXI_awuser,
    M00_AXI_awvalid,
    M00_AXI_bid,
    M00_AXI_bready,
    M00_AXI_bresp,
    M00_AXI_bvalid,
    M00_AXI_rdata,
    M00_AXI_rid,
    M00_AXI_rlast,
    M00_AXI_rready,
    M00_AXI_rresp,
    M00_AXI_rvalid,
    M00_AXI_wdata,
    M00_AXI_wlast,
    M00_AXI_wready,
    M00_AXI_wstrb,
    M00_AXI_wvalid,
    S00_ACLK,
    S00_ARESETN,
    S00_AXI_araddr,
    S00_AXI_arburst,
    S00_AXI_arcache,
    S00_AXI_arid,
    S00_AXI_arlen,
    S00_AXI_arlock,
    S00_AXI_arprot,
    S00_AXI_arqos,
    S00_AXI_arready,
    S00_AXI_arsize,
    S00_AXI_aruser,
    S00_AXI_arvalid,
    S00_AXI_awaddr,
    S00_AXI_awburst,
    S00_AXI_awcache,
    S00_AXI_awid,
    S00_AXI_awlen,
    S00_AXI_awlock,
    S00_AXI_awprot,
    S00_AXI_awqos,
    S00_AXI_awready,
    S00_AXI_awsize,
    S00_AXI_awuser,
    S00_AXI_awvalid,
    S00_AXI_bid,
    S00_AXI_bready,
    S00_AXI_bresp,
    S00_AXI_bvalid,
    S00_AXI_rdata,
    S00_AXI_rid,
    S00_AXI_rlast,
    S00_AXI_rready,
    S00_AXI_rresp,
    S00_AXI_rvalid,
    S00_AXI_wdata,
    S00_AXI_wlast,
    S00_AXI_wready,
    S00_AXI_wstrb,
    S00_AXI_wvalid);
  input ACLK;
  input ARESETN;
  input M00_ACLK;
  input M00_ARESETN;
  output [39:0]M00_AXI_araddr;
  output [1:0]M00_AXI_arburst;
  output [3:0]M00_AXI_arcache;
  output [15:0]M00_AXI_arid;
  output [7:0]M00_AXI_arlen;
  output [0:0]M00_AXI_arlock;
  output [2:0]M00_AXI_arprot;
  output [3:0]M00_AXI_arqos;
  input [0:0]M00_AXI_arready;
  output [2:0]M00_AXI_arsize;
  output [15:0]M00_AXI_aruser;
  output [0:0]M00_AXI_arvalid;
  output [39:0]M00_AXI_awaddr;
  output [1:0]M00_AXI_awburst;
  output [3:0]M00_AXI_awcache;
  output [15:0]M00_AXI_awid;
  output [7:0]M00_AXI_awlen;
  output [0:0]M00_AXI_awlock;
  output [2:0]M00_AXI_awprot;
  output [3:0]M00_AXI_awqos;
  input [0:0]M00_AXI_awready;
  output [2:0]M00_AXI_awsize;
  output [15:0]M00_AXI_awuser;
  output [0:0]M00_AXI_awvalid;
  input [15:0]M00_AXI_bid;
  output [0:0]M00_AXI_bready;
  input [1:0]M00_AXI_bresp;
  input [0:0]M00_AXI_bvalid;
  input [31:0]M00_AXI_rdata;
  input [15:0]M00_AXI_rid;
  input [0:0]M00_AXI_rlast;
  output [0:0]M00_AXI_rready;
  input [1:0]M00_AXI_rresp;
  input [0:0]M00_AXI_rvalid;
  output [31:0]M00_AXI_wdata;
  output [0:0]M00_AXI_wlast;
  input [0:0]M00_AXI_wready;
  output [3:0]M00_AXI_wstrb;
  output [0:0]M00_AXI_wvalid;
  input S00_ACLK;
  input S00_ARESETN;
  input [39:0]S00_AXI_araddr;
  input [1:0]S00_AXI_arburst;
  input [3:0]S00_AXI_arcache;
  input [15:0]S00_AXI_arid;
  input [7:0]S00_AXI_arlen;
  input [0:0]S00_AXI_arlock;
  input [2:0]S00_AXI_arprot;
  input [3:0]S00_AXI_arqos;
  output [0:0]S00_AXI_arready;
  input [2:0]S00_AXI_arsize;
  input [15:0]S00_AXI_aruser;
  input [0:0]S00_AXI_arvalid;
  input [39:0]S00_AXI_awaddr;
  input [1:0]S00_AXI_awburst;
  input [3:0]S00_AXI_awcache;
  input [15:0]S00_AXI_awid;
  input [7:0]S00_AXI_awlen;
  input [0:0]S00_AXI_awlock;
  input [2:0]S00_AXI_awprot;
  input [3:0]S00_AXI_awqos;
  output [0:0]S00_AXI_awready;
  input [2:0]S00_AXI_awsize;
  input [15:0]S00_AXI_awuser;
  input [0:0]S00_AXI_awvalid;
  output [15:0]S00_AXI_bid;
  input [0:0]S00_AXI_bready;
  output [1:0]S00_AXI_bresp;
  output [0:0]S00_AXI_bvalid;
  output [31:0]S00_AXI_rdata;
  output [15:0]S00_AXI_rid;
  output [0:0]S00_AXI_rlast;
  input [0:0]S00_AXI_rready;
  output [1:0]S00_AXI_rresp;
  output [0:0]S00_AXI_rvalid;
  input [31:0]S00_AXI_wdata;
  input [0:0]S00_AXI_wlast;
  output [0:0]S00_AXI_wready;
  input [3:0]S00_AXI_wstrb;
  input [0:0]S00_AXI_wvalid;

  wire S00_ACLK_1;
  wire S00_ARESETN_1;
  wire axi_interconnect_0_ACLK_net;
  wire axi_interconnect_0_ARESETN_net;
  wire [39:0]axi_interconnect_0_to_s00_couplers_ARADDR;
  wire [1:0]axi_interconnect_0_to_s00_couplers_ARBURST;
  wire [3:0]axi_interconnect_0_to_s00_couplers_ARCACHE;
  wire [15:0]axi_interconnect_0_to_s00_couplers_ARID;
  wire [7:0]axi_interconnect_0_to_s00_couplers_ARLEN;
  wire [0:0]axi_interconnect_0_to_s00_couplers_ARLOCK;
  wire [2:0]axi_interconnect_0_to_s00_couplers_ARPROT;
  wire [3:0]axi_interconnect_0_to_s00_couplers_ARQOS;
  wire [0:0]axi_interconnect_0_to_s00_couplers_ARREADY;
  wire [2:0]axi_interconnect_0_to_s00_couplers_ARSIZE;
  wire [15:0]axi_interconnect_0_to_s00_couplers_ARUSER;
  wire [0:0]axi_interconnect_0_to_s00_couplers_ARVALID;
  wire [39:0]axi_interconnect_0_to_s00_couplers_AWADDR;
  wire [1:0]axi_interconnect_0_to_s00_couplers_AWBURST;
  wire [3:0]axi_interconnect_0_to_s00_couplers_AWCACHE;
  wire [15:0]axi_interconnect_0_to_s00_couplers_AWID;
  wire [7:0]axi_interconnect_0_to_s00_couplers_AWLEN;
  wire [0:0]axi_interconnect_0_to_s00_couplers_AWLOCK;
  wire [2:0]axi_interconnect_0_to_s00_couplers_AWPROT;
  wire [3:0]axi_interconnect_0_to_s00_couplers_AWQOS;
  wire [0:0]axi_interconnect_0_to_s00_couplers_AWREADY;
  wire [2:0]axi_interconnect_0_to_s00_couplers_AWSIZE;
  wire [15:0]axi_interconnect_0_to_s00_couplers_AWUSER;
  wire [0:0]axi_interconnect_0_to_s00_couplers_AWVALID;
  wire [15:0]axi_interconnect_0_to_s00_couplers_BID;
  wire [0:0]axi_interconnect_0_to_s00_couplers_BREADY;
  wire [1:0]axi_interconnect_0_to_s00_couplers_BRESP;
  wire [0:0]axi_interconnect_0_to_s00_couplers_BVALID;
  wire [31:0]axi_interconnect_0_to_s00_couplers_RDATA;
  wire [15:0]axi_interconnect_0_to_s00_couplers_RID;
  wire [0:0]axi_interconnect_0_to_s00_couplers_RLAST;
  wire [0:0]axi_interconnect_0_to_s00_couplers_RREADY;
  wire [1:0]axi_interconnect_0_to_s00_couplers_RRESP;
  wire [0:0]axi_interconnect_0_to_s00_couplers_RVALID;
  wire [31:0]axi_interconnect_0_to_s00_couplers_WDATA;
  wire [0:0]axi_interconnect_0_to_s00_couplers_WLAST;
  wire [0:0]axi_interconnect_0_to_s00_couplers_WREADY;
  wire [3:0]axi_interconnect_0_to_s00_couplers_WSTRB;
  wire [0:0]axi_interconnect_0_to_s00_couplers_WVALID;
  wire [39:0]s00_couplers_to_axi_interconnect_0_ARADDR;
  wire [1:0]s00_couplers_to_axi_interconnect_0_ARBURST;
  wire [3:0]s00_couplers_to_axi_interconnect_0_ARCACHE;
  wire [15:0]s00_couplers_to_axi_interconnect_0_ARID;
  wire [7:0]s00_couplers_to_axi_interconnect_0_ARLEN;
  wire [0:0]s00_couplers_to_axi_interconnect_0_ARLOCK;
  wire [2:0]s00_couplers_to_axi_interconnect_0_ARPROT;
  wire [3:0]s00_couplers_to_axi_interconnect_0_ARQOS;
  wire [0:0]s00_couplers_to_axi_interconnect_0_ARREADY;
  wire [2:0]s00_couplers_to_axi_interconnect_0_ARSIZE;
  wire [15:0]s00_couplers_to_axi_interconnect_0_ARUSER;
  wire [0:0]s00_couplers_to_axi_interconnect_0_ARVALID;
  wire [39:0]s00_couplers_to_axi_interconnect_0_AWADDR;
  wire [1:0]s00_couplers_to_axi_interconnect_0_AWBURST;
  wire [3:0]s00_couplers_to_axi_interconnect_0_AWCACHE;
  wire [15:0]s00_couplers_to_axi_interconnect_0_AWID;
  wire [7:0]s00_couplers_to_axi_interconnect_0_AWLEN;
  wire [0:0]s00_couplers_to_axi_interconnect_0_AWLOCK;
  wire [2:0]s00_couplers_to_axi_interconnect_0_AWPROT;
  wire [3:0]s00_couplers_to_axi_interconnect_0_AWQOS;
  wire [0:0]s00_couplers_to_axi_interconnect_0_AWREADY;
  wire [2:0]s00_couplers_to_axi_interconnect_0_AWSIZE;
  wire [15:0]s00_couplers_to_axi_interconnect_0_AWUSER;
  wire [0:0]s00_couplers_to_axi_interconnect_0_AWVALID;
  wire [15:0]s00_couplers_to_axi_interconnect_0_BID;
  wire [0:0]s00_couplers_to_axi_interconnect_0_BREADY;
  wire [1:0]s00_couplers_to_axi_interconnect_0_BRESP;
  wire [0:0]s00_couplers_to_axi_interconnect_0_BVALID;
  wire [31:0]s00_couplers_to_axi_interconnect_0_RDATA;
  wire [15:0]s00_couplers_to_axi_interconnect_0_RID;
  wire [0:0]s00_couplers_to_axi_interconnect_0_RLAST;
  wire [0:0]s00_couplers_to_axi_interconnect_0_RREADY;
  wire [1:0]s00_couplers_to_axi_interconnect_0_RRESP;
  wire [0:0]s00_couplers_to_axi_interconnect_0_RVALID;
  wire [31:0]s00_couplers_to_axi_interconnect_0_WDATA;
  wire [0:0]s00_couplers_to_axi_interconnect_0_WLAST;
  wire [0:0]s00_couplers_to_axi_interconnect_0_WREADY;
  wire [3:0]s00_couplers_to_axi_interconnect_0_WSTRB;
  wire [0:0]s00_couplers_to_axi_interconnect_0_WVALID;

  assign M00_AXI_araddr[39:0] = s00_couplers_to_axi_interconnect_0_ARADDR;
  assign M00_AXI_arburst[1:0] = s00_couplers_to_axi_interconnect_0_ARBURST;
  assign M00_AXI_arcache[3:0] = s00_couplers_to_axi_interconnect_0_ARCACHE;
  assign M00_AXI_arid[15:0] = s00_couplers_to_axi_interconnect_0_ARID;
  assign M00_AXI_arlen[7:0] = s00_couplers_to_axi_interconnect_0_ARLEN;
  assign M00_AXI_arlock[0] = s00_couplers_to_axi_interconnect_0_ARLOCK;
  assign M00_AXI_arprot[2:0] = s00_couplers_to_axi_interconnect_0_ARPROT;
  assign M00_AXI_arqos[3:0] = s00_couplers_to_axi_interconnect_0_ARQOS;
  assign M00_AXI_arsize[2:0] = s00_couplers_to_axi_interconnect_0_ARSIZE;
  assign M00_AXI_aruser[15:0] = s00_couplers_to_axi_interconnect_0_ARUSER;
  assign M00_AXI_arvalid[0] = s00_couplers_to_axi_interconnect_0_ARVALID;
  assign M00_AXI_awaddr[39:0] = s00_couplers_to_axi_interconnect_0_AWADDR;
  assign M00_AXI_awburst[1:0] = s00_couplers_to_axi_interconnect_0_AWBURST;
  assign M00_AXI_awcache[3:0] = s00_couplers_to_axi_interconnect_0_AWCACHE;
  assign M00_AXI_awid[15:0] = s00_couplers_to_axi_interconnect_0_AWID;
  assign M00_AXI_awlen[7:0] = s00_couplers_to_axi_interconnect_0_AWLEN;
  assign M00_AXI_awlock[0] = s00_couplers_to_axi_interconnect_0_AWLOCK;
  assign M00_AXI_awprot[2:0] = s00_couplers_to_axi_interconnect_0_AWPROT;
  assign M00_AXI_awqos[3:0] = s00_couplers_to_axi_interconnect_0_AWQOS;
  assign M00_AXI_awsize[2:0] = s00_couplers_to_axi_interconnect_0_AWSIZE;
  assign M00_AXI_awuser[15:0] = s00_couplers_to_axi_interconnect_0_AWUSER;
  assign M00_AXI_awvalid[0] = s00_couplers_to_axi_interconnect_0_AWVALID;
  assign M00_AXI_bready[0] = s00_couplers_to_axi_interconnect_0_BREADY;
  assign M00_AXI_rready[0] = s00_couplers_to_axi_interconnect_0_RREADY;
  assign M00_AXI_wdata[31:0] = s00_couplers_to_axi_interconnect_0_WDATA;
  assign M00_AXI_wlast[0] = s00_couplers_to_axi_interconnect_0_WLAST;
  assign M00_AXI_wstrb[3:0] = s00_couplers_to_axi_interconnect_0_WSTRB;
  assign M00_AXI_wvalid[0] = s00_couplers_to_axi_interconnect_0_WVALID;
  assign S00_ACLK_1 = S00_ACLK;
  assign S00_ARESETN_1 = S00_ARESETN;
  assign S00_AXI_arready[0] = axi_interconnect_0_to_s00_couplers_ARREADY;
  assign S00_AXI_awready[0] = axi_interconnect_0_to_s00_couplers_AWREADY;
  assign S00_AXI_bid[15:0] = axi_interconnect_0_to_s00_couplers_BID;
  assign S00_AXI_bresp[1:0] = axi_interconnect_0_to_s00_couplers_BRESP;
  assign S00_AXI_bvalid[0] = axi_interconnect_0_to_s00_couplers_BVALID;
  assign S00_AXI_rdata[31:0] = axi_interconnect_0_to_s00_couplers_RDATA;
  assign S00_AXI_rid[15:0] = axi_interconnect_0_to_s00_couplers_RID;
  assign S00_AXI_rlast[0] = axi_interconnect_0_to_s00_couplers_RLAST;
  assign S00_AXI_rresp[1:0] = axi_interconnect_0_to_s00_couplers_RRESP;
  assign S00_AXI_rvalid[0] = axi_interconnect_0_to_s00_couplers_RVALID;
  assign S00_AXI_wready[0] = axi_interconnect_0_to_s00_couplers_WREADY;
  assign axi_interconnect_0_ACLK_net = M00_ACLK;
  assign axi_interconnect_0_ARESETN_net = M00_ARESETN;
  assign axi_interconnect_0_to_s00_couplers_ARADDR = S00_AXI_araddr[39:0];
  assign axi_interconnect_0_to_s00_couplers_ARBURST = S00_AXI_arburst[1:0];
  assign axi_interconnect_0_to_s00_couplers_ARCACHE = S00_AXI_arcache[3:0];
  assign axi_interconnect_0_to_s00_couplers_ARID = S00_AXI_arid[15:0];
  assign axi_interconnect_0_to_s00_couplers_ARLEN = S00_AXI_arlen[7:0];
  assign axi_interconnect_0_to_s00_couplers_ARLOCK = S00_AXI_arlock[0];
  assign axi_interconnect_0_to_s00_couplers_ARPROT = S00_AXI_arprot[2:0];
  assign axi_interconnect_0_to_s00_couplers_ARQOS = S00_AXI_arqos[3:0];
  assign axi_interconnect_0_to_s00_couplers_ARSIZE = S00_AXI_arsize[2:0];
  assign axi_interconnect_0_to_s00_couplers_ARUSER = S00_AXI_aruser[15:0];
  assign axi_interconnect_0_to_s00_couplers_ARVALID = S00_AXI_arvalid[0];
  assign axi_interconnect_0_to_s00_couplers_AWADDR = S00_AXI_awaddr[39:0];
  assign axi_interconnect_0_to_s00_couplers_AWBURST = S00_AXI_awburst[1:0];
  assign axi_interconnect_0_to_s00_couplers_AWCACHE = S00_AXI_awcache[3:0];
  assign axi_interconnect_0_to_s00_couplers_AWID = S00_AXI_awid[15:0];
  assign axi_interconnect_0_to_s00_couplers_AWLEN = S00_AXI_awlen[7:0];
  assign axi_interconnect_0_to_s00_couplers_AWLOCK = S00_AXI_awlock[0];
  assign axi_interconnect_0_to_s00_couplers_AWPROT = S00_AXI_awprot[2:0];
  assign axi_interconnect_0_to_s00_couplers_AWQOS = S00_AXI_awqos[3:0];
  assign axi_interconnect_0_to_s00_couplers_AWSIZE = S00_AXI_awsize[2:0];
  assign axi_interconnect_0_to_s00_couplers_AWUSER = S00_AXI_awuser[15:0];
  assign axi_interconnect_0_to_s00_couplers_AWVALID = S00_AXI_awvalid[0];
  assign axi_interconnect_0_to_s00_couplers_BREADY = S00_AXI_bready[0];
  assign axi_interconnect_0_to_s00_couplers_RREADY = S00_AXI_rready[0];
  assign axi_interconnect_0_to_s00_couplers_WDATA = S00_AXI_wdata[31:0];
  assign axi_interconnect_0_to_s00_couplers_WLAST = S00_AXI_wlast[0];
  assign axi_interconnect_0_to_s00_couplers_WSTRB = S00_AXI_wstrb[3:0];
  assign axi_interconnect_0_to_s00_couplers_WVALID = S00_AXI_wvalid[0];
  assign s00_couplers_to_axi_interconnect_0_ARREADY = M00_AXI_arready[0];
  assign s00_couplers_to_axi_interconnect_0_AWREADY = M00_AXI_awready[0];
  assign s00_couplers_to_axi_interconnect_0_BID = M00_AXI_bid[15:0];
  assign s00_couplers_to_axi_interconnect_0_BRESP = M00_AXI_bresp[1:0];
  assign s00_couplers_to_axi_interconnect_0_BVALID = M00_AXI_bvalid[0];
  assign s00_couplers_to_axi_interconnect_0_RDATA = M00_AXI_rdata[31:0];
  assign s00_couplers_to_axi_interconnect_0_RID = M00_AXI_rid[15:0];
  assign s00_couplers_to_axi_interconnect_0_RLAST = M00_AXI_rlast[0];
  assign s00_couplers_to_axi_interconnect_0_RRESP = M00_AXI_rresp[1:0];
  assign s00_couplers_to_axi_interconnect_0_RVALID = M00_AXI_rvalid[0];
  assign s00_couplers_to_axi_interconnect_0_WREADY = M00_AXI_wready[0];
  s00_couplers_imp_1LUCK8K s00_couplers
       (.M_ACLK(axi_interconnect_0_ACLK_net),
        .M_ARESETN(axi_interconnect_0_ARESETN_net),
        .M_AXI_araddr(s00_couplers_to_axi_interconnect_0_ARADDR),
        .M_AXI_arburst(s00_couplers_to_axi_interconnect_0_ARBURST),
        .M_AXI_arcache(s00_couplers_to_axi_interconnect_0_ARCACHE),
        .M_AXI_arid(s00_couplers_to_axi_interconnect_0_ARID),
        .M_AXI_arlen(s00_couplers_to_axi_interconnect_0_ARLEN),
        .M_AXI_arlock(s00_couplers_to_axi_interconnect_0_ARLOCK),
        .M_AXI_arprot(s00_couplers_to_axi_interconnect_0_ARPROT),
        .M_AXI_arqos(s00_couplers_to_axi_interconnect_0_ARQOS),
        .M_AXI_arready(s00_couplers_to_axi_interconnect_0_ARREADY),
        .M_AXI_arsize(s00_couplers_to_axi_interconnect_0_ARSIZE),
        .M_AXI_aruser(s00_couplers_to_axi_interconnect_0_ARUSER),
        .M_AXI_arvalid(s00_couplers_to_axi_interconnect_0_ARVALID),
        .M_AXI_awaddr(s00_couplers_to_axi_interconnect_0_AWADDR),
        .M_AXI_awburst(s00_couplers_to_axi_interconnect_0_AWBURST),
        .M_AXI_awcache(s00_couplers_to_axi_interconnect_0_AWCACHE),
        .M_AXI_awid(s00_couplers_to_axi_interconnect_0_AWID),
        .M_AXI_awlen(s00_couplers_to_axi_interconnect_0_AWLEN),
        .M_AXI_awlock(s00_couplers_to_axi_interconnect_0_AWLOCK),
        .M_AXI_awprot(s00_couplers_to_axi_interconnect_0_AWPROT),
        .M_AXI_awqos(s00_couplers_to_axi_interconnect_0_AWQOS),
        .M_AXI_awready(s00_couplers_to_axi_interconnect_0_AWREADY),
        .M_AXI_awsize(s00_couplers_to_axi_interconnect_0_AWSIZE),
        .M_AXI_awuser(s00_couplers_to_axi_interconnect_0_AWUSER),
        .M_AXI_awvalid(s00_couplers_to_axi_interconnect_0_AWVALID),
        .M_AXI_bid(s00_couplers_to_axi_interconnect_0_BID),
        .M_AXI_bready(s00_couplers_to_axi_interconnect_0_BREADY),
        .M_AXI_bresp(s00_couplers_to_axi_interconnect_0_BRESP),
        .M_AXI_bvalid(s00_couplers_to_axi_interconnect_0_BVALID),
        .M_AXI_rdata(s00_couplers_to_axi_interconnect_0_RDATA),
        .M_AXI_rid(s00_couplers_to_axi_interconnect_0_RID),
        .M_AXI_rlast(s00_couplers_to_axi_interconnect_0_RLAST),
        .M_AXI_rready(s00_couplers_to_axi_interconnect_0_RREADY),
        .M_AXI_rresp(s00_couplers_to_axi_interconnect_0_RRESP),
        .M_AXI_rvalid(s00_couplers_to_axi_interconnect_0_RVALID),
        .M_AXI_wdata(s00_couplers_to_axi_interconnect_0_WDATA),
        .M_AXI_wlast(s00_couplers_to_axi_interconnect_0_WLAST),
        .M_AXI_wready(s00_couplers_to_axi_interconnect_0_WREADY),
        .M_AXI_wstrb(s00_couplers_to_axi_interconnect_0_WSTRB),
        .M_AXI_wvalid(s00_couplers_to_axi_interconnect_0_WVALID),
        .S_ACLK(S00_ACLK_1),
        .S_ARESETN(S00_ARESETN_1),
        .S_AXI_araddr(axi_interconnect_0_to_s00_couplers_ARADDR),
        .S_AXI_arburst(axi_interconnect_0_to_s00_couplers_ARBURST),
        .S_AXI_arcache(axi_interconnect_0_to_s00_couplers_ARCACHE),
        .S_AXI_arid(axi_interconnect_0_to_s00_couplers_ARID),
        .S_AXI_arlen(axi_interconnect_0_to_s00_couplers_ARLEN),
        .S_AXI_arlock(axi_interconnect_0_to_s00_couplers_ARLOCK),
        .S_AXI_arprot(axi_interconnect_0_to_s00_couplers_ARPROT),
        .S_AXI_arqos(axi_interconnect_0_to_s00_couplers_ARQOS),
        .S_AXI_arready(axi_interconnect_0_to_s00_couplers_ARREADY),
        .S_AXI_arsize(axi_interconnect_0_to_s00_couplers_ARSIZE),
        .S_AXI_aruser(axi_interconnect_0_to_s00_couplers_ARUSER),
        .S_AXI_arvalid(axi_interconnect_0_to_s00_couplers_ARVALID),
        .S_AXI_awaddr(axi_interconnect_0_to_s00_couplers_AWADDR),
        .S_AXI_awburst(axi_interconnect_0_to_s00_couplers_AWBURST),
        .S_AXI_awcache(axi_interconnect_0_to_s00_couplers_AWCACHE),
        .S_AXI_awid(axi_interconnect_0_to_s00_couplers_AWID),
        .S_AXI_awlen(axi_interconnect_0_to_s00_couplers_AWLEN),
        .S_AXI_awlock(axi_interconnect_0_to_s00_couplers_AWLOCK),
        .S_AXI_awprot(axi_interconnect_0_to_s00_couplers_AWPROT),
        .S_AXI_awqos(axi_interconnect_0_to_s00_couplers_AWQOS),
        .S_AXI_awready(axi_interconnect_0_to_s00_couplers_AWREADY),
        .S_AXI_awsize(axi_interconnect_0_to_s00_couplers_AWSIZE),
        .S_AXI_awuser(axi_interconnect_0_to_s00_couplers_AWUSER),
        .S_AXI_awvalid(axi_interconnect_0_to_s00_couplers_AWVALID),
        .S_AXI_bid(axi_interconnect_0_to_s00_couplers_BID),
        .S_AXI_bready(axi_interconnect_0_to_s00_couplers_BREADY),
        .S_AXI_bresp(axi_interconnect_0_to_s00_couplers_BRESP),
        .S_AXI_bvalid(axi_interconnect_0_to_s00_couplers_BVALID),
        .S_AXI_rdata(axi_interconnect_0_to_s00_couplers_RDATA),
        .S_AXI_rid(axi_interconnect_0_to_s00_couplers_RID),
        .S_AXI_rlast(axi_interconnect_0_to_s00_couplers_RLAST),
        .S_AXI_rready(axi_interconnect_0_to_s00_couplers_RREADY),
        .S_AXI_rresp(axi_interconnect_0_to_s00_couplers_RRESP),
        .S_AXI_rvalid(axi_interconnect_0_to_s00_couplers_RVALID),
        .S_AXI_wdata(axi_interconnect_0_to_s00_couplers_WDATA),
        .S_AXI_wlast(axi_interconnect_0_to_s00_couplers_WLAST),
        .S_AXI_wready(axi_interconnect_0_to_s00_couplers_WREADY),
        .S_AXI_wstrb(axi_interconnect_0_to_s00_couplers_WSTRB),
        .S_AXI_wvalid(axi_interconnect_0_to_s00_couplers_WVALID));
endmodule

module hardware_axi_interconnect_1_0
   (ACLK,
    ARESETN,
    M00_ACLK,
    M00_ARESETN,
    M00_AXI_araddr,
    M00_AXI_arready,
    M00_AXI_arvalid,
    M00_AXI_awaddr,
    M00_AXI_awready,
    M00_AXI_awvalid,
    M00_AXI_bready,
    M00_AXI_bresp,
    M00_AXI_bvalid,
    M00_AXI_rdata,
    M00_AXI_rready,
    M00_AXI_rresp,
    M00_AXI_rvalid,
    M00_AXI_wdata,
    M00_AXI_wready,
    M00_AXI_wstrb,
    M00_AXI_wvalid,
    M01_ACLK,
    M01_ARESETN,
    M01_AXI_araddr,
    M01_AXI_arburst,
    M01_AXI_arcache,
    M01_AXI_arlen,
    M01_AXI_arlock,
    M01_AXI_arprot,
    M01_AXI_arqos,
    M01_AXI_arready,
    M01_AXI_arregion,
    M01_AXI_arsize,
    M01_AXI_aruser,
    M01_AXI_arvalid,
    M01_AXI_awaddr,
    M01_AXI_awburst,
    M01_AXI_awcache,
    M01_AXI_awlen,
    M01_AXI_awlock,
    M01_AXI_awprot,
    M01_AXI_awqos,
    M01_AXI_awready,
    M01_AXI_awregion,
    M01_AXI_awsize,
    M01_AXI_awuser,
    M01_AXI_awvalid,
    M01_AXI_bready,
    M01_AXI_bresp,
    M01_AXI_bvalid,
    M01_AXI_rdata,
    M01_AXI_rlast,
    M01_AXI_rready,
    M01_AXI_rresp,
    M01_AXI_rvalid,
    M01_AXI_wdata,
    M01_AXI_wlast,
    M01_AXI_wready,
    M01_AXI_wstrb,
    M01_AXI_wvalid,
    M02_ACLK,
    M02_ARESETN,
    M02_AXI_araddr,
    M02_AXI_arready,
    M02_AXI_arvalid,
    M02_AXI_awaddr,
    M02_AXI_awready,
    M02_AXI_awvalid,
    M02_AXI_bready,
    M02_AXI_bresp,
    M02_AXI_bvalid,
    M02_AXI_rdata,
    M02_AXI_rready,
    M02_AXI_rresp,
    M02_AXI_rvalid,
    M02_AXI_wdata,
    M02_AXI_wready,
    M02_AXI_wstrb,
    M02_AXI_wvalid,
    M03_ACLK,
    M03_ARESETN,
    M03_AXI_araddr,
    M03_AXI_arready,
    M03_AXI_arvalid,
    M03_AXI_awaddr,
    M03_AXI_awready,
    M03_AXI_awvalid,
    M03_AXI_bready,
    M03_AXI_bresp,
    M03_AXI_bvalid,
    M03_AXI_rdata,
    M03_AXI_rready,
    M03_AXI_rresp,
    M03_AXI_rvalid,
    M03_AXI_wdata,
    M03_AXI_wready,
    M03_AXI_wstrb,
    M03_AXI_wvalid,
    S00_ACLK,
    S00_ARESETN,
    S00_AXI_araddr,
    S00_AXI_arburst,
    S00_AXI_arcache,
    S00_AXI_arid,
    S00_AXI_arlen,
    S00_AXI_arlock,
    S00_AXI_arprot,
    S00_AXI_arqos,
    S00_AXI_arready,
    S00_AXI_arsize,
    S00_AXI_aruser,
    S00_AXI_arvalid,
    S00_AXI_awaddr,
    S00_AXI_awburst,
    S00_AXI_awcache,
    S00_AXI_awid,
    S00_AXI_awlen,
    S00_AXI_awlock,
    S00_AXI_awprot,
    S00_AXI_awqos,
    S00_AXI_awready,
    S00_AXI_awsize,
    S00_AXI_awuser,
    S00_AXI_awvalid,
    S00_AXI_bid,
    S00_AXI_bready,
    S00_AXI_bresp,
    S00_AXI_bvalid,
    S00_AXI_rdata,
    S00_AXI_rid,
    S00_AXI_rlast,
    S00_AXI_rready,
    S00_AXI_rresp,
    S00_AXI_rvalid,
    S00_AXI_wdata,
    S00_AXI_wlast,
    S00_AXI_wready,
    S00_AXI_wstrb,
    S00_AXI_wvalid);
  input ACLK;
  input ARESETN;
  input M00_ACLK;
  input M00_ARESETN;
  output [39:0]M00_AXI_araddr;
  input M00_AXI_arready;
  output M00_AXI_arvalid;
  output [39:0]M00_AXI_awaddr;
  input M00_AXI_awready;
  output M00_AXI_awvalid;
  output M00_AXI_bready;
  input [1:0]M00_AXI_bresp;
  input M00_AXI_bvalid;
  input [31:0]M00_AXI_rdata;
  output M00_AXI_rready;
  input [1:0]M00_AXI_rresp;
  input M00_AXI_rvalid;
  output [31:0]M00_AXI_wdata;
  input M00_AXI_wready;
  output [3:0]M00_AXI_wstrb;
  output M00_AXI_wvalid;
  input M01_ACLK;
  input M01_ARESETN;
  output [39:0]M01_AXI_araddr;
  output [1:0]M01_AXI_arburst;
  output [3:0]M01_AXI_arcache;
  output [7:0]M01_AXI_arlen;
  output [0:0]M01_AXI_arlock;
  output [2:0]M01_AXI_arprot;
  output [3:0]M01_AXI_arqos;
  input M01_AXI_arready;
  output [3:0]M01_AXI_arregion;
  output [2:0]M01_AXI_arsize;
  output [15:0]M01_AXI_aruser;
  output M01_AXI_arvalid;
  output [39:0]M01_AXI_awaddr;
  output [1:0]M01_AXI_awburst;
  output [3:0]M01_AXI_awcache;
  output [7:0]M01_AXI_awlen;
  output [0:0]M01_AXI_awlock;
  output [2:0]M01_AXI_awprot;
  output [3:0]M01_AXI_awqos;
  input M01_AXI_awready;
  output [3:0]M01_AXI_awregion;
  output [2:0]M01_AXI_awsize;
  output [15:0]M01_AXI_awuser;
  output M01_AXI_awvalid;
  output M01_AXI_bready;
  input [1:0]M01_AXI_bresp;
  input M01_AXI_bvalid;
  input [31:0]M01_AXI_rdata;
  input M01_AXI_rlast;
  output M01_AXI_rready;
  input [1:0]M01_AXI_rresp;
  input M01_AXI_rvalid;
  output [31:0]M01_AXI_wdata;
  output M01_AXI_wlast;
  input M01_AXI_wready;
  output [3:0]M01_AXI_wstrb;
  output M01_AXI_wvalid;
  input M02_ACLK;
  input M02_ARESETN;
  output [12:0]M02_AXI_araddr;
  input M02_AXI_arready;
  output M02_AXI_arvalid;
  output [12:0]M02_AXI_awaddr;
  input M02_AXI_awready;
  output M02_AXI_awvalid;
  output M02_AXI_bready;
  input [1:0]M02_AXI_bresp;
  input M02_AXI_bvalid;
  input [31:0]M02_AXI_rdata;
  output M02_AXI_rready;
  input [1:0]M02_AXI_rresp;
  input M02_AXI_rvalid;
  output [31:0]M02_AXI_wdata;
  input M02_AXI_wready;
  output [3:0]M02_AXI_wstrb;
  output M02_AXI_wvalid;
  input M03_ACLK;
  input M03_ARESETN;
  output [39:0]M03_AXI_araddr;
  input M03_AXI_arready;
  output M03_AXI_arvalid;
  output [39:0]M03_AXI_awaddr;
  input M03_AXI_awready;
  output M03_AXI_awvalid;
  output M03_AXI_bready;
  input [1:0]M03_AXI_bresp;
  input M03_AXI_bvalid;
  input [31:0]M03_AXI_rdata;
  output M03_AXI_rready;
  input [1:0]M03_AXI_rresp;
  input M03_AXI_rvalid;
  output [31:0]M03_AXI_wdata;
  input M03_AXI_wready;
  output [3:0]M03_AXI_wstrb;
  output M03_AXI_wvalid;
  input S00_ACLK;
  input S00_ARESETN;
  input [39:0]S00_AXI_araddr;
  input [1:0]S00_AXI_arburst;
  input [3:0]S00_AXI_arcache;
  input [15:0]S00_AXI_arid;
  input [7:0]S00_AXI_arlen;
  input [0:0]S00_AXI_arlock;
  input [2:0]S00_AXI_arprot;
  input [3:0]S00_AXI_arqos;
  output [0:0]S00_AXI_arready;
  input [2:0]S00_AXI_arsize;
  input [15:0]S00_AXI_aruser;
  input [0:0]S00_AXI_arvalid;
  input [39:0]S00_AXI_awaddr;
  input [1:0]S00_AXI_awburst;
  input [3:0]S00_AXI_awcache;
  input [15:0]S00_AXI_awid;
  input [7:0]S00_AXI_awlen;
  input [0:0]S00_AXI_awlock;
  input [2:0]S00_AXI_awprot;
  input [3:0]S00_AXI_awqos;
  output [0:0]S00_AXI_awready;
  input [2:0]S00_AXI_awsize;
  input [15:0]S00_AXI_awuser;
  input [0:0]S00_AXI_awvalid;
  output [15:0]S00_AXI_bid;
  input [0:0]S00_AXI_bready;
  output [1:0]S00_AXI_bresp;
  output [0:0]S00_AXI_bvalid;
  output [31:0]S00_AXI_rdata;
  output [15:0]S00_AXI_rid;
  output [0:0]S00_AXI_rlast;
  input [0:0]S00_AXI_rready;
  output [1:0]S00_AXI_rresp;
  output [0:0]S00_AXI_rvalid;
  input [31:0]S00_AXI_wdata;
  input [0:0]S00_AXI_wlast;
  output [0:0]S00_AXI_wready;
  input [3:0]S00_AXI_wstrb;
  input [0:0]S00_AXI_wvalid;

  wire axi_interconnect_1_ACLK_net;
  wire axi_interconnect_1_ARESETN_net;
  wire [39:0]axi_interconnect_1_to_s00_couplers_ARADDR;
  wire [1:0]axi_interconnect_1_to_s00_couplers_ARBURST;
  wire [3:0]axi_interconnect_1_to_s00_couplers_ARCACHE;
  wire [15:0]axi_interconnect_1_to_s00_couplers_ARID;
  wire [7:0]axi_interconnect_1_to_s00_couplers_ARLEN;
  wire [0:0]axi_interconnect_1_to_s00_couplers_ARLOCK;
  wire [2:0]axi_interconnect_1_to_s00_couplers_ARPROT;
  wire [3:0]axi_interconnect_1_to_s00_couplers_ARQOS;
  wire [0:0]axi_interconnect_1_to_s00_couplers_ARREADY;
  wire [2:0]axi_interconnect_1_to_s00_couplers_ARSIZE;
  wire [15:0]axi_interconnect_1_to_s00_couplers_ARUSER;
  wire [0:0]axi_interconnect_1_to_s00_couplers_ARVALID;
  wire [39:0]axi_interconnect_1_to_s00_couplers_AWADDR;
  wire [1:0]axi_interconnect_1_to_s00_couplers_AWBURST;
  wire [3:0]axi_interconnect_1_to_s00_couplers_AWCACHE;
  wire [15:0]axi_interconnect_1_to_s00_couplers_AWID;
  wire [7:0]axi_interconnect_1_to_s00_couplers_AWLEN;
  wire [0:0]axi_interconnect_1_to_s00_couplers_AWLOCK;
  wire [2:0]axi_interconnect_1_to_s00_couplers_AWPROT;
  wire [3:0]axi_interconnect_1_to_s00_couplers_AWQOS;
  wire [0:0]axi_interconnect_1_to_s00_couplers_AWREADY;
  wire [2:0]axi_interconnect_1_to_s00_couplers_AWSIZE;
  wire [15:0]axi_interconnect_1_to_s00_couplers_AWUSER;
  wire [0:0]axi_interconnect_1_to_s00_couplers_AWVALID;
  wire [15:0]axi_interconnect_1_to_s00_couplers_BID;
  wire [0:0]axi_interconnect_1_to_s00_couplers_BREADY;
  wire [1:0]axi_interconnect_1_to_s00_couplers_BRESP;
  wire [0:0]axi_interconnect_1_to_s00_couplers_BVALID;
  wire [31:0]axi_interconnect_1_to_s00_couplers_RDATA;
  wire [15:0]axi_interconnect_1_to_s00_couplers_RID;
  wire [0:0]axi_interconnect_1_to_s00_couplers_RLAST;
  wire [0:0]axi_interconnect_1_to_s00_couplers_RREADY;
  wire [1:0]axi_interconnect_1_to_s00_couplers_RRESP;
  wire [0:0]axi_interconnect_1_to_s00_couplers_RVALID;
  wire [31:0]axi_interconnect_1_to_s00_couplers_WDATA;
  wire [0:0]axi_interconnect_1_to_s00_couplers_WLAST;
  wire [0:0]axi_interconnect_1_to_s00_couplers_WREADY;
  wire [3:0]axi_interconnect_1_to_s00_couplers_WSTRB;
  wire [0:0]axi_interconnect_1_to_s00_couplers_WVALID;
  wire [39:0]m00_couplers_to_axi_interconnect_1_ARADDR;
  wire m00_couplers_to_axi_interconnect_1_ARREADY;
  wire m00_couplers_to_axi_interconnect_1_ARVALID;
  wire [39:0]m00_couplers_to_axi_interconnect_1_AWADDR;
  wire m00_couplers_to_axi_interconnect_1_AWREADY;
  wire m00_couplers_to_axi_interconnect_1_AWVALID;
  wire m00_couplers_to_axi_interconnect_1_BREADY;
  wire [1:0]m00_couplers_to_axi_interconnect_1_BRESP;
  wire m00_couplers_to_axi_interconnect_1_BVALID;
  wire [31:0]m00_couplers_to_axi_interconnect_1_RDATA;
  wire m00_couplers_to_axi_interconnect_1_RREADY;
  wire [1:0]m00_couplers_to_axi_interconnect_1_RRESP;
  wire m00_couplers_to_axi_interconnect_1_RVALID;
  wire [31:0]m00_couplers_to_axi_interconnect_1_WDATA;
  wire m00_couplers_to_axi_interconnect_1_WREADY;
  wire [3:0]m00_couplers_to_axi_interconnect_1_WSTRB;
  wire m00_couplers_to_axi_interconnect_1_WVALID;
  wire [39:0]m01_couplers_to_axi_interconnect_1_ARADDR;
  wire [1:0]m01_couplers_to_axi_interconnect_1_ARBURST;
  wire [3:0]m01_couplers_to_axi_interconnect_1_ARCACHE;
  wire [7:0]m01_couplers_to_axi_interconnect_1_ARLEN;
  wire [0:0]m01_couplers_to_axi_interconnect_1_ARLOCK;
  wire [2:0]m01_couplers_to_axi_interconnect_1_ARPROT;
  wire [3:0]m01_couplers_to_axi_interconnect_1_ARQOS;
  wire m01_couplers_to_axi_interconnect_1_ARREADY;
  wire [3:0]m01_couplers_to_axi_interconnect_1_ARREGION;
  wire [2:0]m01_couplers_to_axi_interconnect_1_ARSIZE;
  wire [15:0]m01_couplers_to_axi_interconnect_1_ARUSER;
  wire m01_couplers_to_axi_interconnect_1_ARVALID;
  wire [39:0]m01_couplers_to_axi_interconnect_1_AWADDR;
  wire [1:0]m01_couplers_to_axi_interconnect_1_AWBURST;
  wire [3:0]m01_couplers_to_axi_interconnect_1_AWCACHE;
  wire [7:0]m01_couplers_to_axi_interconnect_1_AWLEN;
  wire [0:0]m01_couplers_to_axi_interconnect_1_AWLOCK;
  wire [2:0]m01_couplers_to_axi_interconnect_1_AWPROT;
  wire [3:0]m01_couplers_to_axi_interconnect_1_AWQOS;
  wire m01_couplers_to_axi_interconnect_1_AWREADY;
  wire [3:0]m01_couplers_to_axi_interconnect_1_AWREGION;
  wire [2:0]m01_couplers_to_axi_interconnect_1_AWSIZE;
  wire [15:0]m01_couplers_to_axi_interconnect_1_AWUSER;
  wire m01_couplers_to_axi_interconnect_1_AWVALID;
  wire m01_couplers_to_axi_interconnect_1_BREADY;
  wire [1:0]m01_couplers_to_axi_interconnect_1_BRESP;
  wire m01_couplers_to_axi_interconnect_1_BVALID;
  wire [31:0]m01_couplers_to_axi_interconnect_1_RDATA;
  wire m01_couplers_to_axi_interconnect_1_RLAST;
  wire m01_couplers_to_axi_interconnect_1_RREADY;
  wire [1:0]m01_couplers_to_axi_interconnect_1_RRESP;
  wire m01_couplers_to_axi_interconnect_1_RVALID;
  wire [31:0]m01_couplers_to_axi_interconnect_1_WDATA;
  wire m01_couplers_to_axi_interconnect_1_WLAST;
  wire m01_couplers_to_axi_interconnect_1_WREADY;
  wire [3:0]m01_couplers_to_axi_interconnect_1_WSTRB;
  wire m01_couplers_to_axi_interconnect_1_WVALID;
  wire [12:0]m02_couplers_to_axi_interconnect_1_ARADDR;
  wire m02_couplers_to_axi_interconnect_1_ARREADY;
  wire m02_couplers_to_axi_interconnect_1_ARVALID;
  wire [12:0]m02_couplers_to_axi_interconnect_1_AWADDR;
  wire m02_couplers_to_axi_interconnect_1_AWREADY;
  wire m02_couplers_to_axi_interconnect_1_AWVALID;
  wire m02_couplers_to_axi_interconnect_1_BREADY;
  wire [1:0]m02_couplers_to_axi_interconnect_1_BRESP;
  wire m02_couplers_to_axi_interconnect_1_BVALID;
  wire [31:0]m02_couplers_to_axi_interconnect_1_RDATA;
  wire m02_couplers_to_axi_interconnect_1_RREADY;
  wire [1:0]m02_couplers_to_axi_interconnect_1_RRESP;
  wire m02_couplers_to_axi_interconnect_1_RVALID;
  wire [31:0]m02_couplers_to_axi_interconnect_1_WDATA;
  wire m02_couplers_to_axi_interconnect_1_WREADY;
  wire [3:0]m02_couplers_to_axi_interconnect_1_WSTRB;
  wire m02_couplers_to_axi_interconnect_1_WVALID;
  wire [39:0]m03_couplers_to_axi_interconnect_1_ARADDR;
  wire m03_couplers_to_axi_interconnect_1_ARREADY;
  wire m03_couplers_to_axi_interconnect_1_ARVALID;
  wire [39:0]m03_couplers_to_axi_interconnect_1_AWADDR;
  wire m03_couplers_to_axi_interconnect_1_AWREADY;
  wire m03_couplers_to_axi_interconnect_1_AWVALID;
  wire m03_couplers_to_axi_interconnect_1_BREADY;
  wire [1:0]m03_couplers_to_axi_interconnect_1_BRESP;
  wire m03_couplers_to_axi_interconnect_1_BVALID;
  wire [31:0]m03_couplers_to_axi_interconnect_1_RDATA;
  wire m03_couplers_to_axi_interconnect_1_RREADY;
  wire [1:0]m03_couplers_to_axi_interconnect_1_RRESP;
  wire m03_couplers_to_axi_interconnect_1_RVALID;
  wire [31:0]m03_couplers_to_axi_interconnect_1_WDATA;
  wire m03_couplers_to_axi_interconnect_1_WREADY;
  wire [3:0]m03_couplers_to_axi_interconnect_1_WSTRB;
  wire m03_couplers_to_axi_interconnect_1_WVALID;
  wire [39:0]s00_couplers_to_xbar_ARADDR;
  wire [1:0]s00_couplers_to_xbar_ARBURST;
  wire [3:0]s00_couplers_to_xbar_ARCACHE;
  wire [15:0]s00_couplers_to_xbar_ARID;
  wire [7:0]s00_couplers_to_xbar_ARLEN;
  wire [0:0]s00_couplers_to_xbar_ARLOCK;
  wire [2:0]s00_couplers_to_xbar_ARPROT;
  wire [3:0]s00_couplers_to_xbar_ARQOS;
  wire [0:0]s00_couplers_to_xbar_ARREADY;
  wire [2:0]s00_couplers_to_xbar_ARSIZE;
  wire [15:0]s00_couplers_to_xbar_ARUSER;
  wire [0:0]s00_couplers_to_xbar_ARVALID;
  wire [39:0]s00_couplers_to_xbar_AWADDR;
  wire [1:0]s00_couplers_to_xbar_AWBURST;
  wire [3:0]s00_couplers_to_xbar_AWCACHE;
  wire [15:0]s00_couplers_to_xbar_AWID;
  wire [7:0]s00_couplers_to_xbar_AWLEN;
  wire [0:0]s00_couplers_to_xbar_AWLOCK;
  wire [2:0]s00_couplers_to_xbar_AWPROT;
  wire [3:0]s00_couplers_to_xbar_AWQOS;
  wire [0:0]s00_couplers_to_xbar_AWREADY;
  wire [2:0]s00_couplers_to_xbar_AWSIZE;
  wire [15:0]s00_couplers_to_xbar_AWUSER;
  wire [0:0]s00_couplers_to_xbar_AWVALID;
  wire [15:0]s00_couplers_to_xbar_BID;
  wire [0:0]s00_couplers_to_xbar_BREADY;
  wire [1:0]s00_couplers_to_xbar_BRESP;
  wire [0:0]s00_couplers_to_xbar_BVALID;
  wire [31:0]s00_couplers_to_xbar_RDATA;
  wire [15:0]s00_couplers_to_xbar_RID;
  wire [0:0]s00_couplers_to_xbar_RLAST;
  wire [0:0]s00_couplers_to_xbar_RREADY;
  wire [1:0]s00_couplers_to_xbar_RRESP;
  wire [0:0]s00_couplers_to_xbar_RVALID;
  wire [31:0]s00_couplers_to_xbar_WDATA;
  wire [0:0]s00_couplers_to_xbar_WLAST;
  wire [0:0]s00_couplers_to_xbar_WREADY;
  wire [3:0]s00_couplers_to_xbar_WSTRB;
  wire [0:0]s00_couplers_to_xbar_WVALID;
  wire [39:0]xbar_to_m00_couplers_ARADDR;
  wire [1:0]xbar_to_m00_couplers_ARBURST;
  wire [3:0]xbar_to_m00_couplers_ARCACHE;
  wire [7:0]xbar_to_m00_couplers_ARLEN;
  wire [0:0]xbar_to_m00_couplers_ARLOCK;
  wire [2:0]xbar_to_m00_couplers_ARPROT;
  wire [3:0]xbar_to_m00_couplers_ARQOS;
  wire xbar_to_m00_couplers_ARREADY;
  wire [3:0]xbar_to_m00_couplers_ARREGION;
  wire [2:0]xbar_to_m00_couplers_ARSIZE;
  wire [0:0]xbar_to_m00_couplers_ARVALID;
  wire [39:0]xbar_to_m00_couplers_AWADDR;
  wire [1:0]xbar_to_m00_couplers_AWBURST;
  wire [3:0]xbar_to_m00_couplers_AWCACHE;
  wire [7:0]xbar_to_m00_couplers_AWLEN;
  wire [0:0]xbar_to_m00_couplers_AWLOCK;
  wire [2:0]xbar_to_m00_couplers_AWPROT;
  wire [3:0]xbar_to_m00_couplers_AWQOS;
  wire xbar_to_m00_couplers_AWREADY;
  wire [3:0]xbar_to_m00_couplers_AWREGION;
  wire [2:0]xbar_to_m00_couplers_AWSIZE;
  wire [0:0]xbar_to_m00_couplers_AWVALID;
  wire [0:0]xbar_to_m00_couplers_BREADY;
  wire [1:0]xbar_to_m00_couplers_BRESP;
  wire xbar_to_m00_couplers_BVALID;
  wire [31:0]xbar_to_m00_couplers_RDATA;
  wire xbar_to_m00_couplers_RLAST;
  wire [0:0]xbar_to_m00_couplers_RREADY;
  wire [1:0]xbar_to_m00_couplers_RRESP;
  wire xbar_to_m00_couplers_RVALID;
  wire [31:0]xbar_to_m00_couplers_WDATA;
  wire [0:0]xbar_to_m00_couplers_WLAST;
  wire xbar_to_m00_couplers_WREADY;
  wire [3:0]xbar_to_m00_couplers_WSTRB;
  wire [0:0]xbar_to_m00_couplers_WVALID;
  wire [79:40]xbar_to_m01_couplers_ARADDR;
  wire [3:2]xbar_to_m01_couplers_ARBURST;
  wire [7:4]xbar_to_m01_couplers_ARCACHE;
  wire [15:8]xbar_to_m01_couplers_ARLEN;
  wire [1:1]xbar_to_m01_couplers_ARLOCK;
  wire [5:3]xbar_to_m01_couplers_ARPROT;
  wire [7:4]xbar_to_m01_couplers_ARQOS;
  wire xbar_to_m01_couplers_ARREADY;
  wire [7:4]xbar_to_m01_couplers_ARREGION;
  wire [5:3]xbar_to_m01_couplers_ARSIZE;
  wire [31:16]xbar_to_m01_couplers_ARUSER;
  wire [1:1]xbar_to_m01_couplers_ARVALID;
  wire [79:40]xbar_to_m01_couplers_AWADDR;
  wire [3:2]xbar_to_m01_couplers_AWBURST;
  wire [7:4]xbar_to_m01_couplers_AWCACHE;
  wire [15:8]xbar_to_m01_couplers_AWLEN;
  wire [1:1]xbar_to_m01_couplers_AWLOCK;
  wire [5:3]xbar_to_m01_couplers_AWPROT;
  wire [7:4]xbar_to_m01_couplers_AWQOS;
  wire xbar_to_m01_couplers_AWREADY;
  wire [7:4]xbar_to_m01_couplers_AWREGION;
  wire [5:3]xbar_to_m01_couplers_AWSIZE;
  wire [31:16]xbar_to_m01_couplers_AWUSER;
  wire [1:1]xbar_to_m01_couplers_AWVALID;
  wire [1:1]xbar_to_m01_couplers_BREADY;
  wire [1:0]xbar_to_m01_couplers_BRESP;
  wire xbar_to_m01_couplers_BVALID;
  wire [31:0]xbar_to_m01_couplers_RDATA;
  wire xbar_to_m01_couplers_RLAST;
  wire [1:1]xbar_to_m01_couplers_RREADY;
  wire [1:0]xbar_to_m01_couplers_RRESP;
  wire xbar_to_m01_couplers_RVALID;
  wire [63:32]xbar_to_m01_couplers_WDATA;
  wire [1:1]xbar_to_m01_couplers_WLAST;
  wire xbar_to_m01_couplers_WREADY;
  wire [7:4]xbar_to_m01_couplers_WSTRB;
  wire [1:1]xbar_to_m01_couplers_WVALID;
  wire [119:80]xbar_to_m02_couplers_ARADDR;
  wire [5:4]xbar_to_m02_couplers_ARBURST;
  wire [11:8]xbar_to_m02_couplers_ARCACHE;
  wire [23:16]xbar_to_m02_couplers_ARLEN;
  wire [2:2]xbar_to_m02_couplers_ARLOCK;
  wire [8:6]xbar_to_m02_couplers_ARPROT;
  wire [11:8]xbar_to_m02_couplers_ARQOS;
  wire xbar_to_m02_couplers_ARREADY;
  wire [11:8]xbar_to_m02_couplers_ARREGION;
  wire [8:6]xbar_to_m02_couplers_ARSIZE;
  wire [2:2]xbar_to_m02_couplers_ARVALID;
  wire [119:80]xbar_to_m02_couplers_AWADDR;
  wire [5:4]xbar_to_m02_couplers_AWBURST;
  wire [11:8]xbar_to_m02_couplers_AWCACHE;
  wire [23:16]xbar_to_m02_couplers_AWLEN;
  wire [2:2]xbar_to_m02_couplers_AWLOCK;
  wire [8:6]xbar_to_m02_couplers_AWPROT;
  wire [11:8]xbar_to_m02_couplers_AWQOS;
  wire xbar_to_m02_couplers_AWREADY;
  wire [11:8]xbar_to_m02_couplers_AWREGION;
  wire [8:6]xbar_to_m02_couplers_AWSIZE;
  wire [2:2]xbar_to_m02_couplers_AWVALID;
  wire [2:2]xbar_to_m02_couplers_BREADY;
  wire [1:0]xbar_to_m02_couplers_BRESP;
  wire xbar_to_m02_couplers_BVALID;
  wire [31:0]xbar_to_m02_couplers_RDATA;
  wire xbar_to_m02_couplers_RLAST;
  wire [2:2]xbar_to_m02_couplers_RREADY;
  wire [1:0]xbar_to_m02_couplers_RRESP;
  wire xbar_to_m02_couplers_RVALID;
  wire [95:64]xbar_to_m02_couplers_WDATA;
  wire [2:2]xbar_to_m02_couplers_WLAST;
  wire xbar_to_m02_couplers_WREADY;
  wire [11:8]xbar_to_m02_couplers_WSTRB;
  wire [2:2]xbar_to_m02_couplers_WVALID;
  wire [159:120]xbar_to_m03_couplers_ARADDR;
  wire [7:6]xbar_to_m03_couplers_ARBURST;
  wire [15:12]xbar_to_m03_couplers_ARCACHE;
  wire [31:24]xbar_to_m03_couplers_ARLEN;
  wire [3:3]xbar_to_m03_couplers_ARLOCK;
  wire [11:9]xbar_to_m03_couplers_ARPROT;
  wire [15:12]xbar_to_m03_couplers_ARQOS;
  wire xbar_to_m03_couplers_ARREADY;
  wire [15:12]xbar_to_m03_couplers_ARREGION;
  wire [11:9]xbar_to_m03_couplers_ARSIZE;
  wire [3:3]xbar_to_m03_couplers_ARVALID;
  wire [159:120]xbar_to_m03_couplers_AWADDR;
  wire [7:6]xbar_to_m03_couplers_AWBURST;
  wire [15:12]xbar_to_m03_couplers_AWCACHE;
  wire [31:24]xbar_to_m03_couplers_AWLEN;
  wire [3:3]xbar_to_m03_couplers_AWLOCK;
  wire [11:9]xbar_to_m03_couplers_AWPROT;
  wire [15:12]xbar_to_m03_couplers_AWQOS;
  wire xbar_to_m03_couplers_AWREADY;
  wire [15:12]xbar_to_m03_couplers_AWREGION;
  wire [11:9]xbar_to_m03_couplers_AWSIZE;
  wire [3:3]xbar_to_m03_couplers_AWVALID;
  wire [3:3]xbar_to_m03_couplers_BREADY;
  wire [1:0]xbar_to_m03_couplers_BRESP;
  wire xbar_to_m03_couplers_BVALID;
  wire [31:0]xbar_to_m03_couplers_RDATA;
  wire xbar_to_m03_couplers_RLAST;
  wire [3:3]xbar_to_m03_couplers_RREADY;
  wire [1:0]xbar_to_m03_couplers_RRESP;
  wire xbar_to_m03_couplers_RVALID;
  wire [127:96]xbar_to_m03_couplers_WDATA;
  wire [3:3]xbar_to_m03_couplers_WLAST;
  wire xbar_to_m03_couplers_WREADY;
  wire [15:12]xbar_to_m03_couplers_WSTRB;
  wire [3:3]xbar_to_m03_couplers_WVALID;
  wire [63:0]NLW_xbar_m_axi_aruser_UNCONNECTED;
  wire [63:0]NLW_xbar_m_axi_awuser_UNCONNECTED;
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
