Tai-Min/KV260-Human-Detector/package/app/inc/stepper_controller.hpp

#pragma once

#include <cstdint>
#include <string>

#include "../inc/gpio.hpp"

class StepperController {
   public:
    /**
     * @brief Specifies direction of cradle's movement. ENDSTOP1 - moves towards endstop 1 etc.
     */
    enum Endstop : bool {
        ENDSTOP1 = 0,
        ENDSTOP2 = 1
    };

   private:
    ///@{
    /**
     * @brief Offsets to specific GPIOs starting from gpiochip.
     */
    static const unsigned int paramLength = 8;                                    // Simple uint8 param.
    static const unsigned int LSBParamOffset = 0;                                 // Offset 0.
    static const unsigned int MSBParamOffset = LSBParamOffset + paramLength - 1;  // Offset 7.
    static const unsigned int dirOffset = MSBParamOffset + 1;                     // Offset 8.
    static const unsigned int cmdLength = 2;                                      // Command has two bits.
    static const unsigned int cmdOffset = dirOffset + cmdLength;                  // Offset 10.
    static const unsigned int latchOffset = cmdOffset + 1;                        // Offset 11.
    static const unsigned int forceEnaOffset = latchOffset + 1;                   // Offset 12
    static const unsigned int outputLength = forceEnaOffset + 1;                  // 13 outputs.

    static const unsigned int busyOffset = forceEnaOffset + 1;          // Offset 13.
    static const unsigned int stop1Offset = busyOffset + 1;             // Offset 14.
    static const unsigned int stop2Offset = stop1Offset + 1;            // Offset 15.
    static const unsigned int gpioLength = stop2Offset + 1;             // 16 GPIO.
    static const unsigned int inputLength = gpioLength - outputLength;  // 3 inputs.
    ///@}

    int chipNum = -1;     //!< Number of gpiochip connected to AXI stepper controller.
    bool isInit = false;  //!< Whether controller is ready to be used.

    GPIO gpio[gpioLength];  //!< GPIOs to control AXI stepper controller.

    /**
     * @brief Initialize GPIOs connected to AXI stepper controller.
     * @return True if success.
     */
    bool initGPIO();

    /**
     * @brief Deinitialize used GPIOs.
     */
    void deinitGPIO();

    /**
     * @brief Send latch signal to AXI stepper controller.
     * @param err Set to true if operation fails.
     */
    void latchCmd(bool &err);

    StepperController(const StepperController&);
    StepperController& operator=(const StepperController&);

   public:
    StepperController() = default;

    /**
     * @brief Construct a new Stepper Controller object and initialize it's GPIOs.
     * @param chipNum Number of gpiochip connected to AXI stepper controller.
     */
    StepperController(int chipNum);

    /**
     * @brief Destroy the Stepper Controller object and unexport used GPIOs.
     */
    ~StepperController();

    /**
     * @brief Initialize GPIOs connected to AXI stepper controller.
     * @param chipNum Number of gpiochip connected to AXI stepper controller.
     * @return True if stepper controller initialized.
     */
    bool init(int chipNum);

    /**
     * @brief Disconnect from AXI GPIOs.
     */
    void deinit();

    /**
     * @brief Check whether stepper controller is initialized.
     * @return True if initialized.
     */
    bool good();

    /**
     * @brief Send BASE command to PL controller. Does not wait for BASE command to complete.
     * @param dir Endstop to move towards to.
     * @param err Set to true if operation fails.
     */
    void home(Endstop dir, bool &err);

    /**
     * @brief Send MOV command to PL controller. Does not wait for MOV command to complete.
     * @param dir Endstop to move towards to.
     * @param steps Number of steps to perform.
     * @param err Set to true if operation fails.
     */
    void move(Endstop dir, uint8_t steps, bool &err);

    /**
     * @brief Force ENA pin to power on the motor even when there is no command being performed. Might heat up the motor if forced for too long!
     * @param val True - force enable, false - disabled when idle.
     * @param err Set to true if operation fails.
     */
    void forceEnable(bool val, bool &err);

    /**
     * @brief Send NOP command to PL controller. Stops currently latched command.
     * @param err Set to true if operation fails.
     */
    void stop(bool &err);

    /**
     * @brief Check whether AXI stepper controller is performing BASE or MOV.
     * @param err Set to true if operation fails.
     * @return True if AXI controller is performing BASE or MOV.
     */
    bool busy(bool &err);

    /**
     * @brief Read state of selected endstop.
     * @param endstop Endstop to check.
     * @param err Set to true if operation fails.
     * @return True if selected endstop pressed.
     */
    bool checkEndstop(Endstop endstop, bool &err);
};
