Tai-Min/KV260-Human-Detector/(commit log)

2022-01-09 Create HW design
    [pmod_shield.kicad_pcb, pmod_shield.sch]
2022-01-09 Add linux conf
    [bsp.cfg]
2022-01-12 Add build_app.ps1, work on regenerate_hw.ps1
    [krnl_vadd-compile.cfg, vadd_container.cfg]
2022-01-18 Moving to linux
    [krnl_vadd-compile.cfg, ocl_rules.cfg]
2022-01-18 Move to linux
    [bsp.cfg, kernel.cfg, krnl_vadd-compile.cfg, link.cfg, ocl_rules.cfg, pmod_shield.kicad_pcb, pmod_shield.sch, vadd_container.cfg]
2022-02-01 Move HW design to Vivado 2020.2 for KRS stack
    [bsp.cfg]
2022-02-07 Env setup for project
    [kernel.cfg, link.cfg, package.cfg]
2022-02-07 Control stepper from app
2022-02-10 Add USB Hub to DeviceTree
2022-02-13 Add working PointCloud2 generation!
    [bsp.cfg, kernel.cfg, package.cfg]
2022-02-15 Add working lidar processing kernel
    [kernel.cfg, link.cfg]
2022-02-23 Add quantized network
    Former-commit-id: 2e93fe863f3f042f3845f770757ea0587df8208d
    [link.cfg]
2022-03-03 Fix padding
    Former-commit-id: 0b71f26b0f5eeac8cc3295633aa7daf47227497f
    Former-commit-id: a1b3f106a05651add333338576ab2586ceb8ca72
    [kernel.cfg, link.cfg]
2022-03-03 Update README, add gerber and stl files
    [bottom_panel.stl, bottom_panel_feets.stl, bottom_panel_stopper.stl, cradle.stl, lidar_board_holder.stl, lidar_frame.stl, motor_frame.stl, nema_connector.stl]
2022-03-03 Fix schematic.jpg
2022-03-23 Add working dpcma, dpu drivers and working inference engine
    [bsp.cfg]
2022-03-25 Add projection to cloud kernel
    [kernel.cfg, link.cfg]
